G5K-org/open-lasertag/readme.md

<div align="center">

# Open Lasertag

**Infrarot-Lasertag zum Selberbauen – ESP32-S3 in der Waffe, passive Sensorweste, Spielserver in Python**







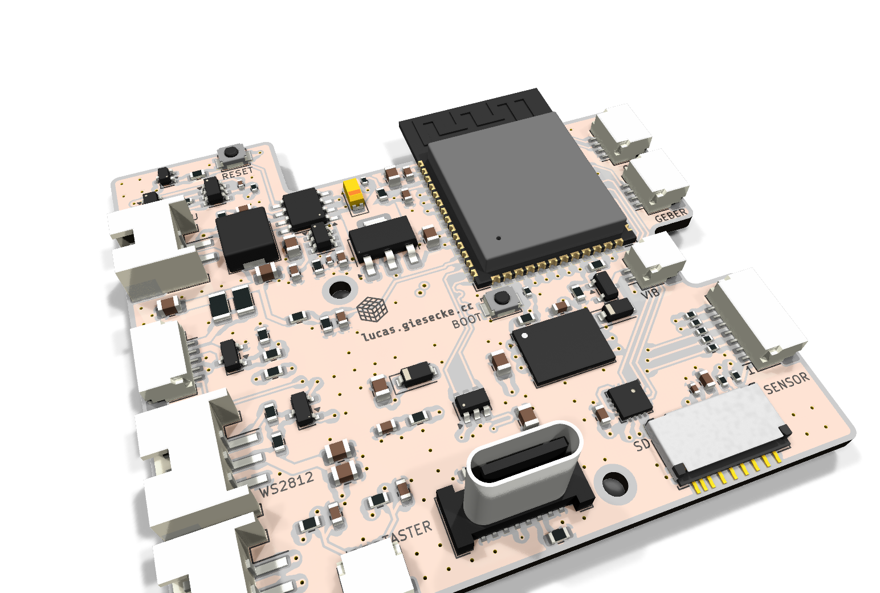
[picture p1: kicad/waffe_elektronik/renders/platine_3d.png]
3D-Ansicht der Waffen-Platine


</div>

## Was ist das?

Ein komplettes Lasertag-System im Eigenbau für Spiele in einer großen Halle:

- **Waffe:** ein 3D-gedrucktes MP5-Gehäuse mit einer eigenen Platine. Darauf
  sitzt ein ESP32-S3, der alles steuert: IR-Schuss, Trefferauswertung,
  Lebens- und Munitionsanzeige, Mündungsfeuer, Vibration, Sound, Akku und WLAN.
- **Weste:** nur passive IR-Empfänger (TSOP34838) an Stirnband, Brust, Rücken
  und Schultern, per Kabel an der Waffe. Die Weste hat keine eigene Elektronik.
- **Server:** ein Python-Programm mit Live-Anzeige im Browser. Es zählt
  Punkte, führt Runden und gibt den Respawn frei.
- **Gateway (optional):** ein kleiner ESP32 am Server-PC. Über ihn erreichen
  die Waffen den Server per ESP-NOW, wenn das WLAN ausfällt.

Geschossen wird mit einer 940-nm-IR-LED hinter einer Linse, nicht mit einem
echten Laser. Die Spiellogik läuft lokal in der Waffe, damit Treffer sofort
Licht, Ton und Vibration auslösen. Das Netz meldet nur nach.

## Inhalt

- [Funktionen](#funktionen)
- [Systemüberblick](#systemüberblick)
- [Hardware](#hardware)
- [Gehäuse](#gehäuse)
- [Firmware](#firmware)
- [Server und Live-Anzeige](#server-und-live-anzeige)
- [Schnellstart](#schnellstart)
- [Projektstruktur](#projektstruktur)
- [Stand](#stand)
- [Planung im Detail](#planung-im-detail)
  1. [Grundentscheidungen](#1-grundentscheidungen)
  2. [Architektur](#2-architektur)
  3. [Sensorkabel zwischen Weste und Waffe](#3-sensorkabel-zwischen-weste-und-waffe)
  4. [IR-Protokoll und Trefferlogik](#4-ir-protokoll-und-trefferlogik)
  5. [Netzwerk](#5-netzwerk)
  6. [Anzeige und Feedback](#6-anzeige-und-feedback)
  7. [Risiken und Gegenmaßnahmen](#7-risiken-und-gegenmaßnahmen)
  8. [ESP32-Wahl](#8-esp32-wahl)
  9. [Vorgehen](#9-vorgehen)
  10. [Offene Punkte](#10-offene-punkte)

## Funktionen

| | |
|---|---|
| 🔫 **Schuss** | NEC-codiertes IR-Signal (Team + Spieler-ID), 38 kHz, jeder Schuss 2× gesendet; Ziel 30–50 m Reichweite |
| 🎯 **Treffer** | bis zu 6 Sensoren; Treffer zählt erst bei 2 gültigen Frames in 100 ms, danach 500 ms unverwundbar; Kopftreffer geben Bonuspunkte |
| 💡 **Anzeige** | WS2812-Kette an der Waffe: Lebensbalken grün → gelb → rot, Munition, Teamfarbe, Ringlicht als Mündungsfeuer; Anschlüsse für OLED (I²C) und Drehdrück-Geber |
| 📳 **Feedback** | Rückstoß- und Treffervibration, Soundeffekte über I²S-Verstärker, weißer Blitz bei Treffer, rotes Pulsieren als tot |
| 🔋 **Akku** | 1S-LiPo/18650 mit Schutzschaltung auf der Platine, Laden über USB-C, Spannungs- und Ladeanzeige; per USB auch ohne Akku lauffähig |
| 📡 **Netz** | WLAN mit eigenem Roaming zwischen Access Points, UDP mit HMAC-Signatur, Treffer werden bis zur Bestätigung wiederholt |
| 🛟 **ESP-NOW** | Fallback zum Server über ein Gateway, wenn das WLAN ausfällt; Trefferbestätigung direkt an die Waffe des Schützen (Ton + grüner Blitz) |
| 🖥️ **Server** | Runden mit Zeitlimit, Teamwertung, Respawn-Freigabe, Live-Anzeige und Bedienung im Browser, Latenzmessung pro Hallenzone |

## Systemüberblick

```mermaid
flowchart LR
    subgraph Weste["Weste (nur Sensoren)"]
        T1["TSOP 1<br>Stirn vorn"]
        T2["TSOP 2<br>Stirn hinten"]
        T3["TSOP 3<br>Brust"]
        T4["TSOP 4<br>Rücken"]
        T5["TSOP 5<br>Schultern"]
    end
    subgraph Waffe["Waffe (ESP32-S3)"]
        RX["IR-Empfang<br>RMT + GPIO"]
        GAME["Spiellogik<br>HP, Munition, Respawn"]
        TX["IR-LED<br>38 kHz"]
        FX["WS2812, Ringlicht,<br>Vibration, Sound"]
        NET["WLAN / UDP"]
    end
    SRV["Server (Python)<br>Punkte, Runden"]
    GW["Gateway<br>ESP32-C3"]
    WEB["Browser<br>Live-Anzeige"]
    W2["andere Waffe"]

    Weste -->|"Sensorkabel<br>GX16, 7 Adern"| RX
    RX --> GAME
    GAME --> TX
    GAME --> FX
    GAME <--> NET
    NET <-->|"WLAN: UDP + HMAC"| SRV
    NET <-.->|"Fallback: ESP-NOW"| GW
    GW <-->|USB| SRV
    NET -.->|"ESP-NOW: Treffer bestätigt"| W2
    SRV <-->|WebSocket| WEB
    TX -.->|IR-Schuss| G(("Gegner"))
```

## Hardware

Eine Platine für die ganze Waffe: 59,6 × 55 mm, 4 Lagen, nur SMD-Bauteile, von
Hand geroutet und für die Bestückung bei JLCPCB vorbereitet. Alle Peripherie
hängt an Steckern: Akku, IR-LED, Taster, Motoren, Lautsprecher, WS2812, ein Sensor an der Waffe und
das Sensorkabel der Weste. Ein- und ausgeschaltet wird mit dem Taster des Drehgebers (kurz drücken = ein,
2 s = aus; ausgeschaltet fließen ca. 55 µA). Geladen wird über USB-C mit 2 A.

| Oberseite | Unterseite |
|---|---|
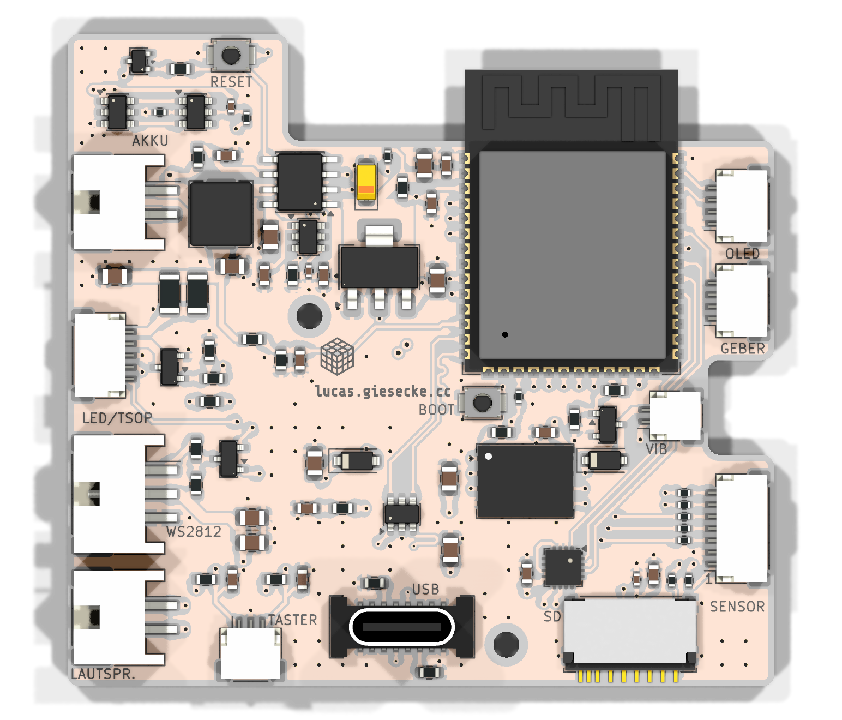
[picture p2: kicad/waffe_elektronik/renders/platine_oben.png]
Platine Oberseite
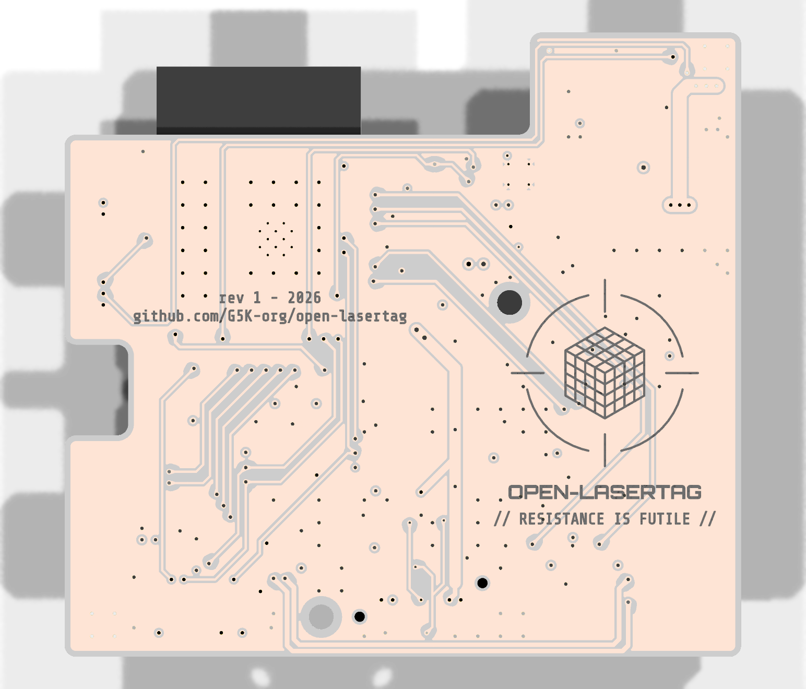
[picture p3: kicad/waffe_elektronik/renders/platine_unten.png]
Platine Unterseite
|  |  |

**Auf der Platine:** ESP32-S3-WROOM-1 (16 MB Flash, 8 MB PSRAM; optional WROOM-1U mit externer Antenne), USB-C mit
ESD-Schutz zum Flashen und Laden, Lade- und 5-V-IC IP5306 (2 A Laden), Akkuschutz DW01A + FS8205A,
3,3-V-Regler, MOSFETs für IR-LED und Vibrationsmotor, Pegelwandler für
WS2812, I²S-Verstärker MAX98357A, microSD-Slot für Audio-Dateien (optional SPI-NAND-Flash 128 MB),
GX16-Buchse für das Sensorkabel der Weste (TSOP-Leitungen über 100 Ω).

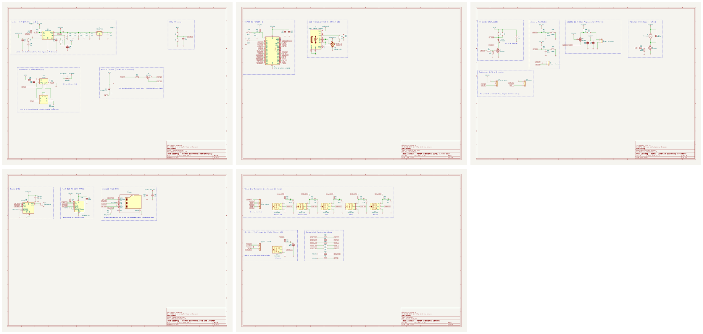
[picture p4: kicad/waffe_elektronik/renders/schaltplan.png]
Schaltplan der Waffen-Elektronik, fünf Seiten


Schaltplan, Layout, Fertigungsdaten und Design-Entscheidungen:
[kicad/waffe_elektronik/](kicad/waffe_elektronik/) · Pinbelegung:
[pinbelegung.md](pinbelegung.md)

## Gehäuse

Als Basis dient das Modell
[MP5 Toygun Cosplay](https://makerworld.com/de/models/427808-mp5-toygun-cosplay)
von **WIZZY** (MakerWorld). Es ist eine rein statische Requisite und wird für
Platine, Akku, Lautsprecher und Optik ausgehöhlt und angepasst. Vorne an der
Mündung sitzt ein WS2812-Ring als Mündungsfeuer.

Die Originaldateien liegen wegen der MakerWorld-Lizenz nicht im Repo; Download und
Ablage beschreibt [gehaeuse/mp5_toygun_stls/](gehaeuse/mp5_toygun_stls/).

Die Platine sitzt im Unterteil zwischen Magazinschacht und Griff; die senkrechte
USB-C-Buchse schließt bündig mit einer Mulde in der linken Seitenwand ab. Im Schalldämpfer sitzen IR-LED und
verstellbare Linse, vorn das Ringlicht; der 18650-Akku steckt im Magazin, das OLED sitzt
angewinkelt vorn oben am Schaft, der Drehgeber unten im Griff, der Abzug löst einen Mikroschalter aus.
Im Handschutz sitzt ein Lautsprecher Ø 40 mit Basskammer, vorn unter dem Korn der TSOP 6. Gehäusehälften
(6 × M3) und die beiden Hälften des vorderen Handschutzes mit Schalldämpfer (5 × M3) sind mit
Einschmelzmuttern verschraubt; die vorderen Hälften umschließen einen Zapfen am hinteren Handschutz
und sind dort mit je 2 × M3 befestigt (ohne Kleber, lösbar). Das Sensorkabel der Weste steckt unten vorn
am Schaft in einer GX16-7-Buchse (Stecker hängt hinter dem Griff leicht schräg nach hinten unten). Links über
dem Griff ist der Sicherungshebel ein beweglicher Nachladehebel (Wippe auf einen verdeckten Taster). Links oben
über dem ESP32-Modul sitzt eine RP-SMA-Buchse für eine externe Knick-Stabantenne (Variante WROOM-1U), die
senkrecht nach oben neben Kimme und Korn steht. Gehäuse, Zwischenring, Handschutz und Schaft sind
mit Stahlstegen und je zwei Zugankern M4 vorn und hinten verspannt, der Zwischenring ist beidseitig
zentriert. Alle Kabelwege sind geprüft:
[gehaeuse/mp5_umbau/](gehaeuse/mp5_umbau/README.md#kabelwege).
Umgebaute und neue Druckteile: [gehaeuse/mp5_umbau/](gehaeuse/mp5_umbau/). Alle Teile samt
Platine zusammengesetzt: [gehaeuse/baugruppe/](gehaeuse/baugruppe/) (GLB/3MF).

| Umgebaute Waffe | Innen (linke Hälfte, Schaft und Magazin ausgeblendet) |
|---|---|
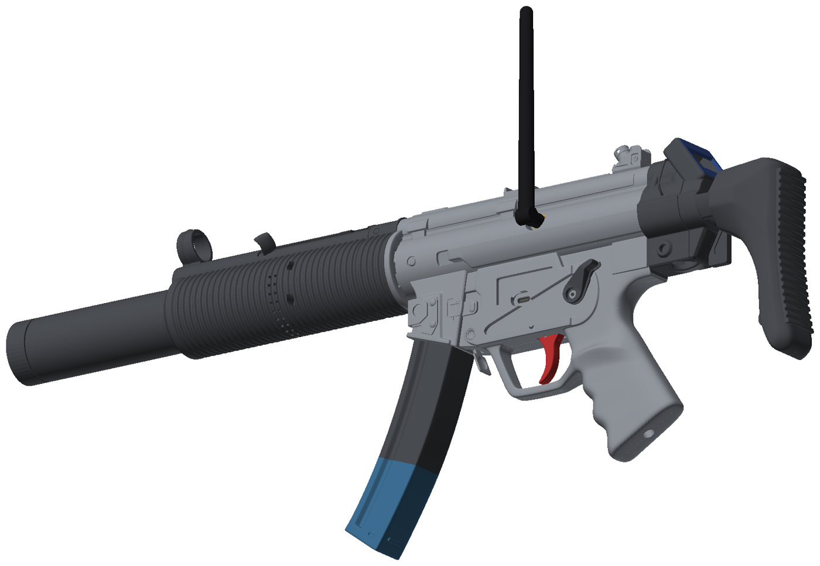
[picture p5: gehaeuse/baugruppe/baugruppe_schraeg.png]
3D-Ansicht der umgebauten Waffe, schräg von vorn
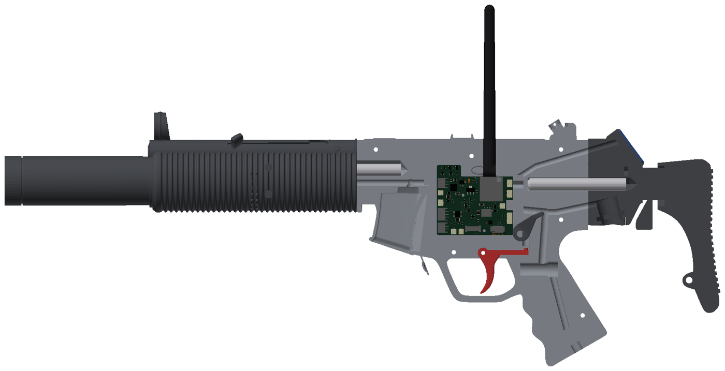
[picture p6: gehaeuse/baugruppe/baugruppe_offen.png]
3D-Schnittansicht: Platine, Abzug, Kabelschächte, Motor, Drehgeber
|  |  |

| Schalldämpfer mit Ringlicht und Linsenhülse | OLED am Schaft |
|---|---|
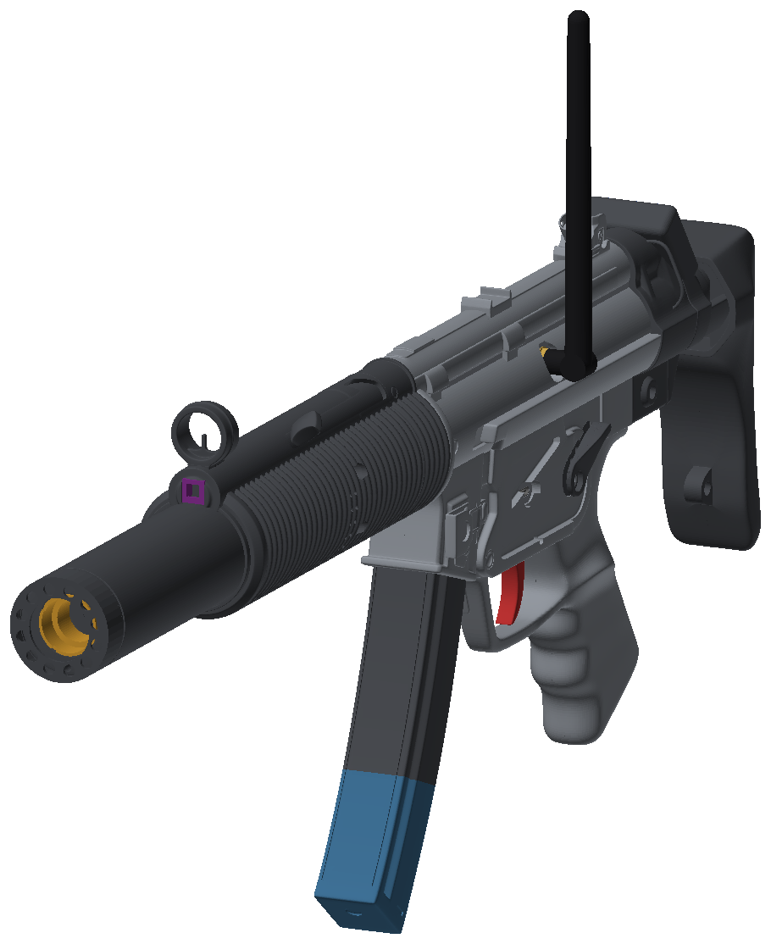
[picture p7: gehaeuse/baugruppe/baugruppe_vorn.png]
3D-Ansicht vorn: Frontkappe mit 12 Fenstern und Linsenhülse
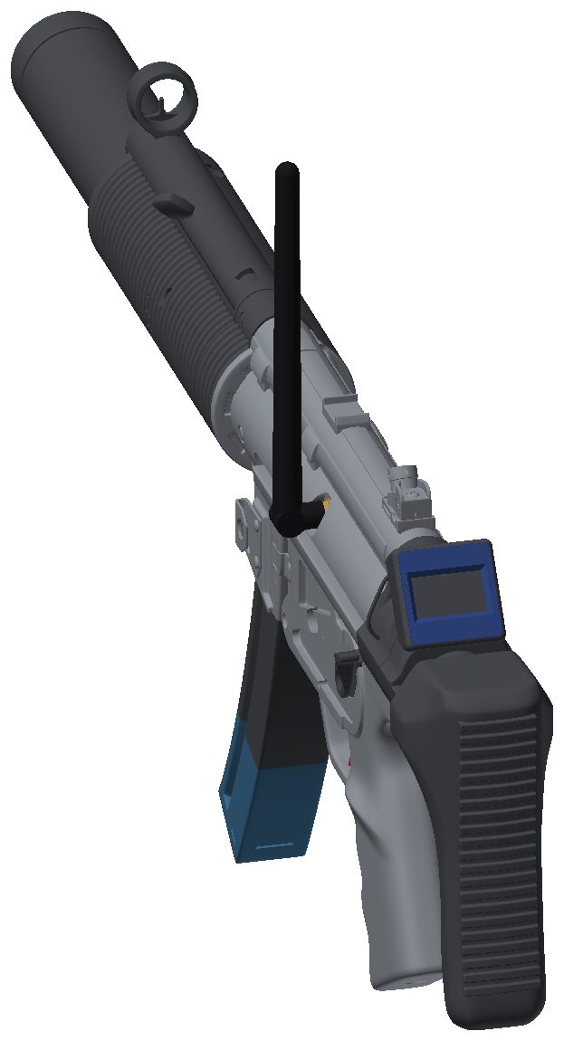
[picture p8: gehaeuse/baugruppe/baugruppe_hinten.png]
3D-Ansicht hinten: OLED-Sockel mit Rahmen am Schaft
|  |  |

**Externe Antenne:** RP-SMA-Buchse in der linken Seitenwand, innen Pigtail als Schlaufe zum U.FL des WROOM-1U.

| Außen | Innen (linke Hälfte und Antenne ausgeblendet) |
|---|---|
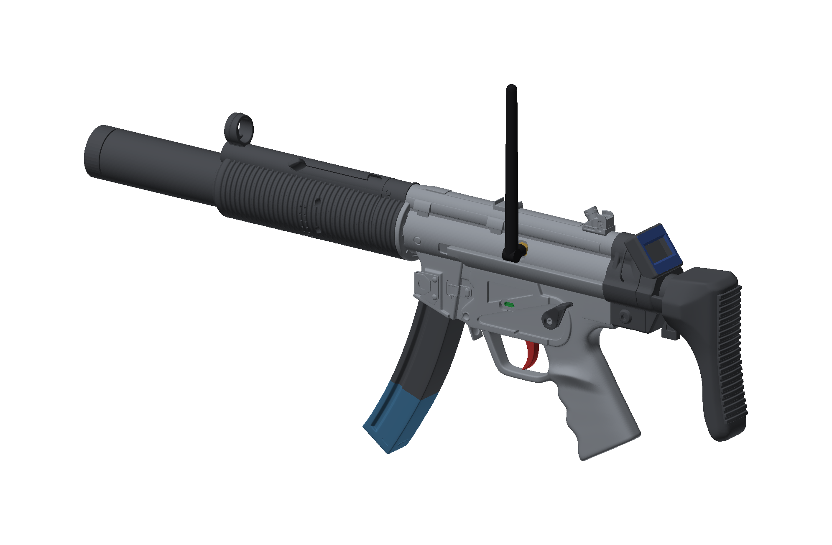
[picture p9: gehaeuse/baugruppe/antenne_aussen.png]
Knick-Stabantenne links oben am Gehäuse, senkrecht nach oben
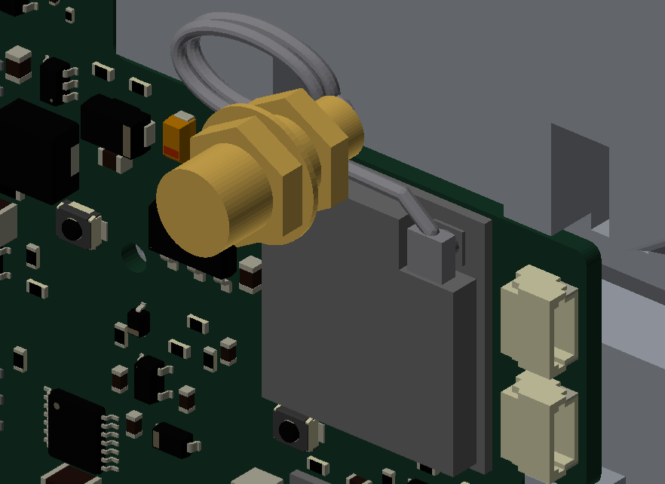
[picture p10: gehaeuse/baugruppe/antenne_innen.png]
RP-SMA-Buchse, Kabelschlaufe und U.FL am ESP32-S3-WROOM-1U
|  |  |

**Explosionszeichnung:** alle Druckteile, die Platine und die Antennenteile, entlang ihrer Montagerichtung auseinandergezogen.

| Von links vorn | Von rechts |
|---|---|
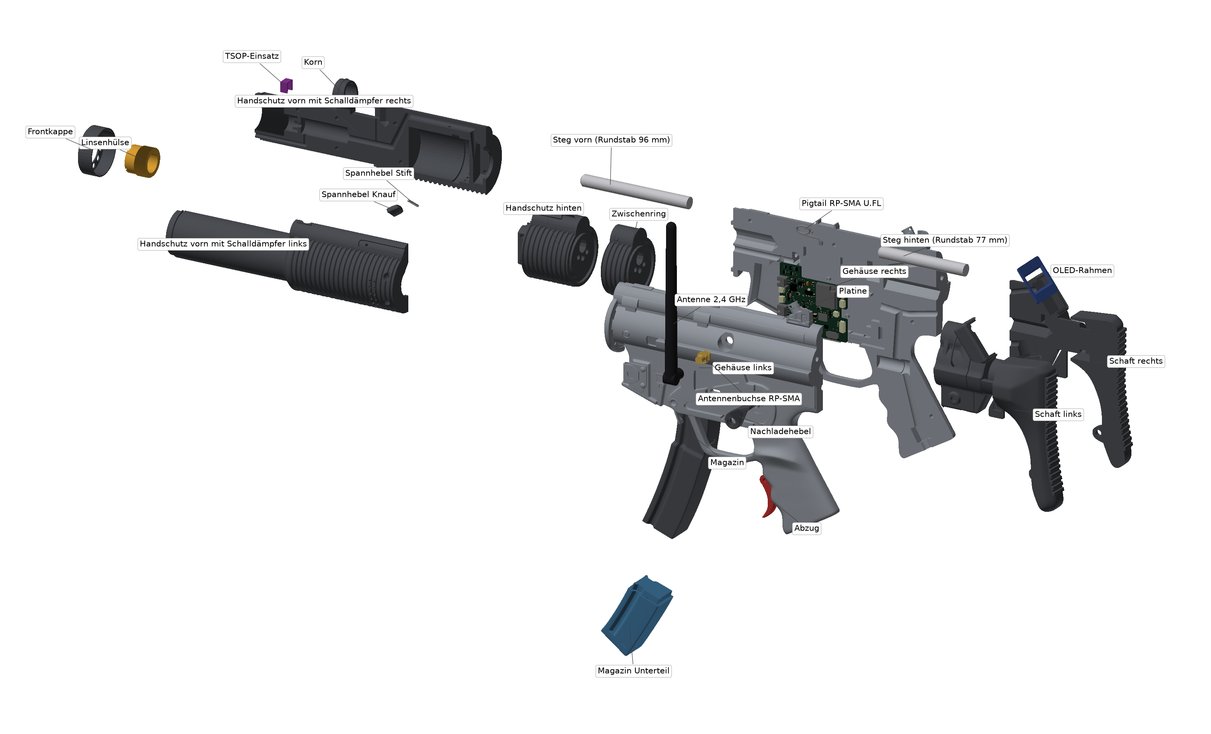
[picture p11: gehaeuse/baugruppe/explosion_links.png]
Explosionszeichnung von links vorn mit Teilenamen
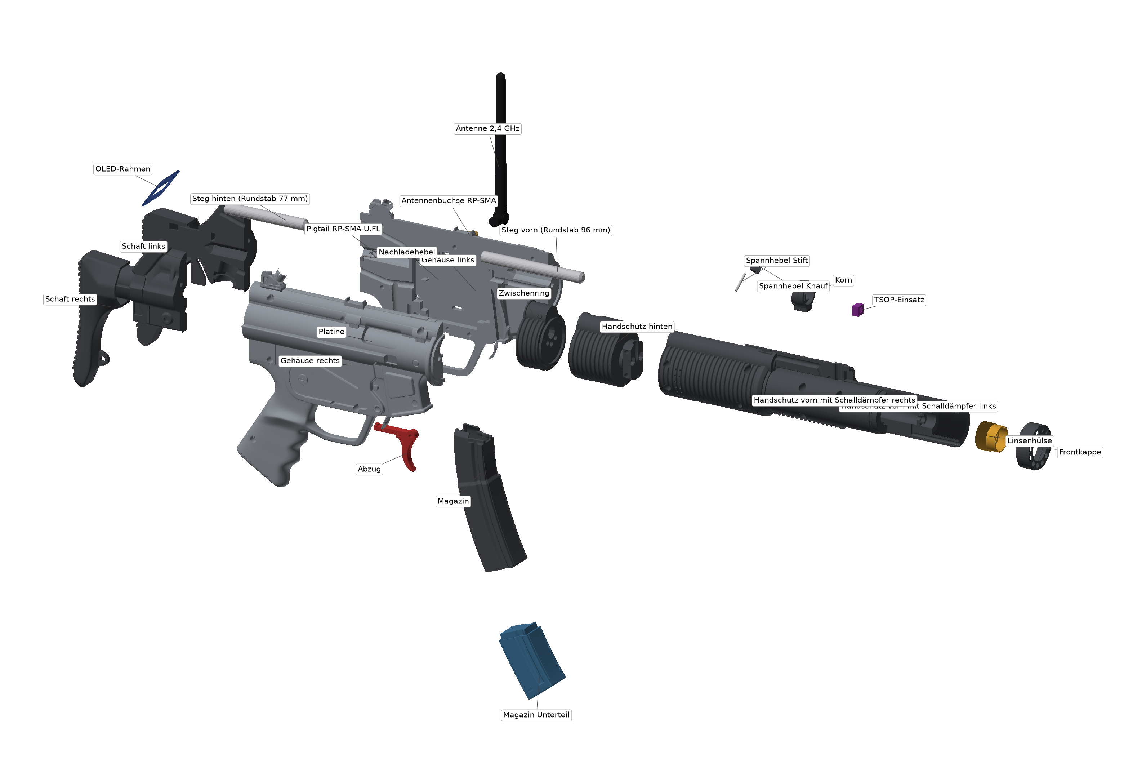
[picture p12: gehaeuse/baugruppe/explosion_rechts.png]
Explosionszeichnung von rechts mit Teilenamen
|  |  |

**Schnitt durch den Schalldämpfer:** Linsenhülse (gold) mit Linse Ø 20 im Innengewinde M24 × 1,5,
von vorn verstellbar; dahinter die IR-LED im Sitz (21 mm hinter der Linse), Kabel nach hinten;
vorn die Frontkappe mit Ringlicht, unten der Kabelkanal für das Ringlicht.

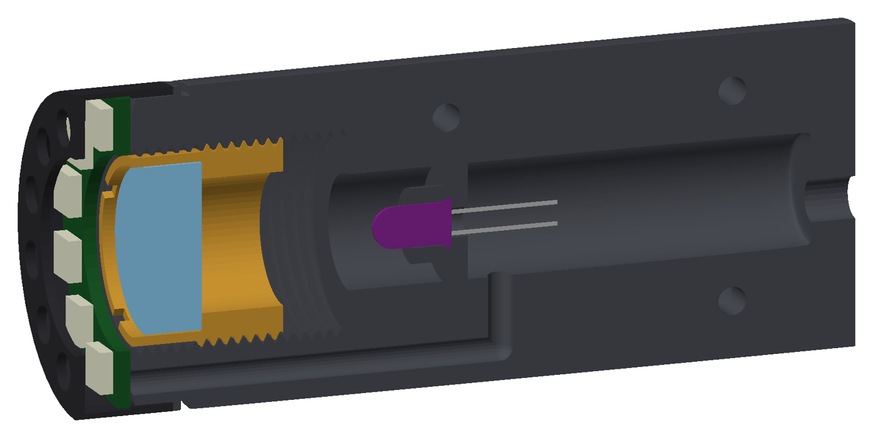
[picture p13: gehaeuse/baugruppe/schnitt_schalldaempfer.png]
Schnitt durch den Schalldämpfer: Linsenhülse mit Gewinde, Linse, IR-LED, Frontkappe mit Ringlicht


**Schnitt durch den Handschutz** (rechte Hälfte): Lautsprecher Ø 40 (rot) strahlt nach hinten in eine
Schallkammer mit Löchern in den Rillen, davor die geschlossene Basskammer (ca. 42 cm³); oben der
Kabelschacht als offene Nut an der Teilungsfläche, darüber das Korn; rechts (blau) der Zapfen des
hinteren Handschutzes, den die vorderen Hälften umschließen.

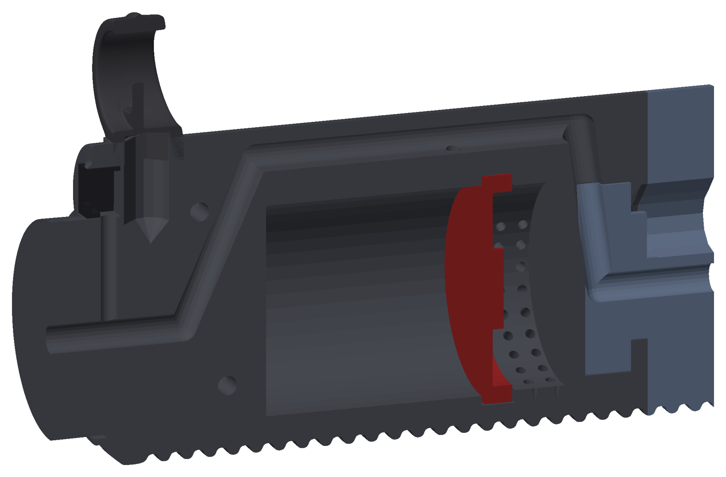
[picture p14: gehaeuse/baugruppe/schnitt_lautsprecher.png]
Schnitt durch den Handschutz: Lautsprecher, Schallkammer mit Löchern, Basskammer, Kabelschacht


**Schnitt durch Gehäuse und Schaft:** GX16-7-Buchse für das Sensorkabel der Weste unten vorn am Schaft
(gold, Mutter in einer Sechskanttasche), Stecker 15° nach hinten unten; der Westenschacht läuft schräg nach
vorn in den Motorschacht und zur Platine (J2).

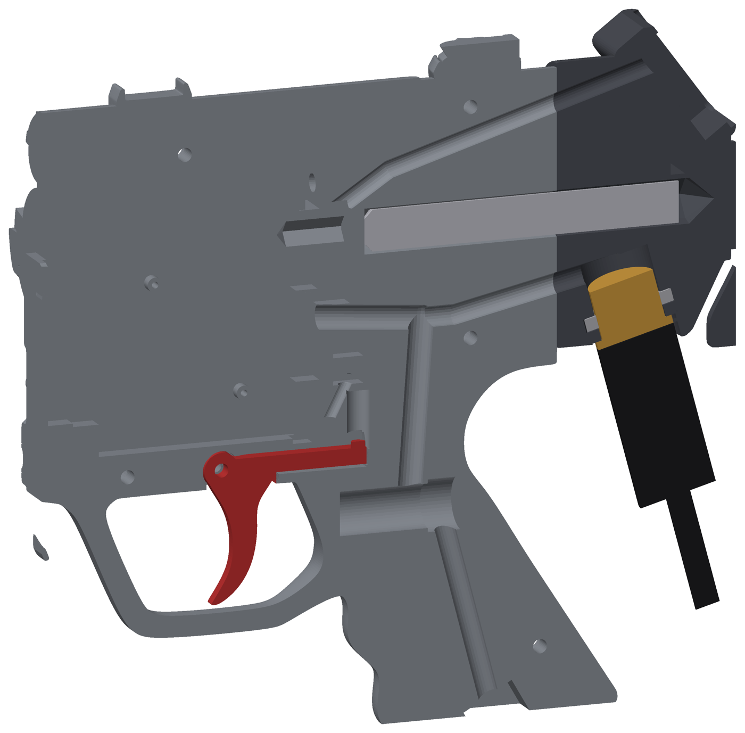
[picture p15: gehaeuse/baugruppe/schnitt_weste.png]
Schnitt: GX16-Buchse im Schaft mit Mutter und Stecker, Kabelschacht zur Platine


## Firmware

ESP-IDF v6.0, nur offizielle Espressif-Komponenten. WLAN und Netz laufen auf
Core 0, IR-Empfang und Spiellogik auf Core 1.

- **IR:** Senden über RMT mit 38-kHz-Träger. TSOP 1–4 laufen über die vier
  RMT-Empfangskanäle, weitere Sensoren über GPIO-Interrupts. Beide Wege gehen
  in denselben NEC-Decoder.
- **Feedback:** WS2812 über `led_strip`, Vibration per PWM, Soundeffekte
  werden synthetisch erzeugt (keine Sound-Dateien). Flash und microSD für
  Audio-Dateien sind auf der Platine vorgesehen, die Firmware nutzt sie noch nicht.
- **Netz:** kein Stromsparmodus, eigenes Roaming unter −75 dBm, Treffer
  werden gepuffert und wiederholt, bis der Server bestätigt.
- **ESP-NOW:** ohne WLAN nach 5 s Fallback über das [Gateway](gateway/);
  getroffene Waffen bestätigen dem Schützen den Treffer direkt.
- **Einstellungen:** Team, Spieler-ID, WLAN, Server und Spielregeln unter
  `idf.py menuconfig`. Team und ID kann auch der Server setzen.

Details: [firmware/](firmware/)

## Server und Live-Anzeige

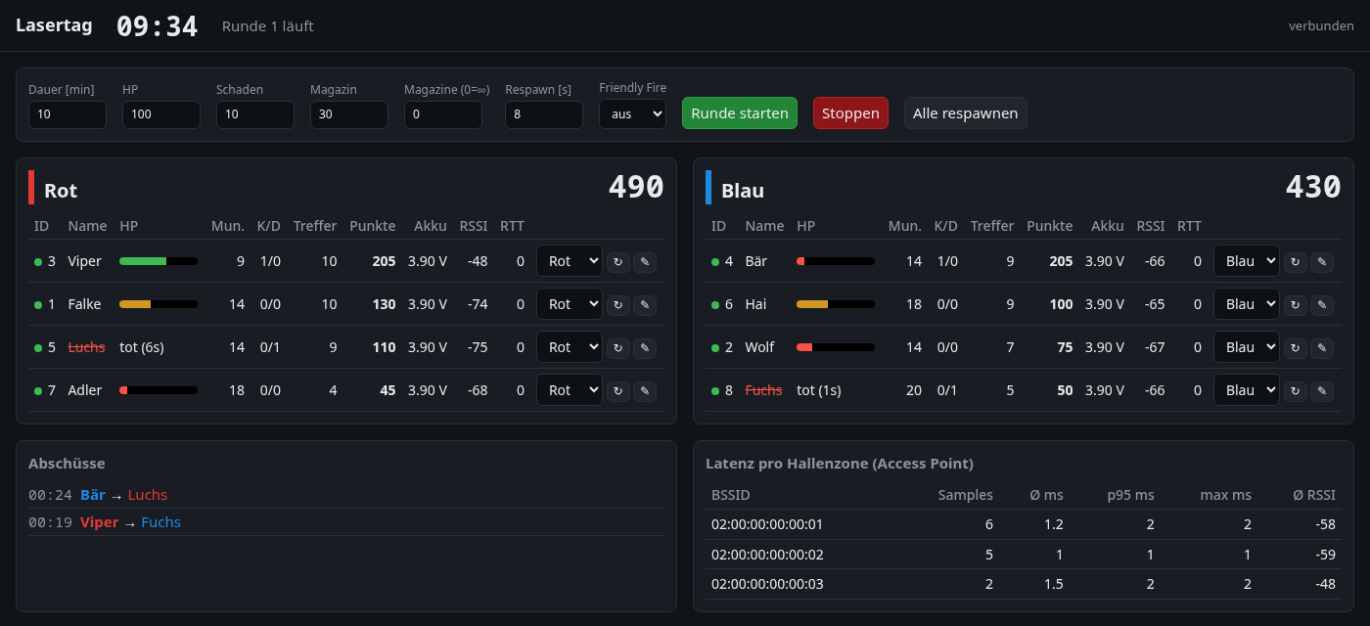
[picture p16: docs/bilder/server_weboberflaeche.png]
Live-Anzeige des Servers während einer Runde


Reines Python (Standardbibliothek, keine Installation). Der Server nimmt die
UDP-Pakete der Waffen an, wertet Treffer und Abschüsse aus, führt Runden mit
Zeitlimit und gibt den Respawn frei. Im Browser gibt es Teamwertung,
Spielerwerte (HP, Munition, K/D, Akku, Signal, Latenz), Abschussliste und die
Latenz pro Access Point. Ein Waffen-Simulator erlaubt Tests ohne Hardware.

Details: [server/](server/) · ESP-NOW-Gateway: [gateway/](gateway/)

## Schnellstart

**Firmware bauen und flashen** (Platine über USB-C anschließen):

```sh
. ~/esp/esp-idf-v6.0.3/export.sh
cd firmware
idf.py menuconfig          # "Lasertag Waffe": WLAN, Server-IP, Team, Spieler
idf.py -p /dev/ttyACM0 flash monitor
```

**Server starten:**

```sh
cd server
cp config.example.json config.json   # Schlüssel wie in der Firmware eintragen
python3 -m lasertag_server --config config.json
# Live-Anzeige: http://<server-ip>:8080/
```

**Ohne Hardware ausprobieren:**

```sh
cd server
python3 -m lasertag_server &
python3 sim_weapon.py --count 6
```

## Projektstruktur

```
├── firmware/              ESP-IDF-Projekt der Waffe
│   ├── main/              Module: IR, Spiellogik, LEDs, Sound, Netz, …
│   ├── test/              Host-Test des NEC-Decoders
│   └── tools/             kleiner UDP-Testserver
├── gateway/               ESP-NOW-Gateway (ESP32-C3) für den Server
├── server/                Spielserver in Python
│   ├── lasertag_server/   UDP, Spiellogik, Web/WebSocket, Oberfläche
│   ├── sim_weapon.py      Waffen-Simulator
│   └── tests/             Unit-Tests
├── kicad/waffe_elektronik/
│   ├── scripts/           Generatoren für Schaltplan (5 Seiten) und Platine, 3D-Modelle
│   ├── symbols/, footprints/, 3dmodels/   Projektbibliotheken
│   ├── renders/           Bilder von Platine und Schaltplan
│   └── fertigung/jlcpcb/  Gerber, BOM, CPL
├── gehaeuse/              MP5-Umbau: Druckteile, Baugruppe, Skripte (Basis-STL per Download)
├── docs/bilder/           Screenshots
├── pinbelegung.md         GPIO-Belegung des ESP32-S3
└── roadmap.md             Phasenplan
```

## Stand

| Teil | Stand |
|---|---|
| Schaltplan und Platine | fertig (Schaltplan auf fünf Seiten), ERC ohne Meldungen, DRC ohne Fehler, Bestellpaket für JLCPCB erstellt |
| Firmware | erste Fassung, auf einem ESP32-S3 geflasht und gestartet; Peripherie noch nicht getestet |
| Server | erste Fassung, mit simulierten Waffen getestet |
| ESP-NOW | Fallback Waffe ↔ Gateway ↔ Server mit zwei ESP32-S3 getestet (beide Richtungen, RTT ~22 ms); Trefferbestätigung Waffe zu Waffe noch ungetestet |
| Gehäuse | Umbau konstruiert (Druckteile, Baugruppe, Kabelwege geprüft), noch nicht gedruckt |
| Weste | Sensoren und Kabel geplant |

Nächste Schritte im [Phasenplan](roadmap.md).

## Lizenz

© 2026 Lucas Giesecke. Firmware, Server, Gateway, Schaltplan, Platine, Gehäuseumbau, Skripte und
Dokumentation stehen unter [CC BY-NC-SA 4.0](LICENSE)
(Namensnennung – nicht kommerziell – Weitergabe unter gleichen Bedingungen):

- **erlaubt:** nutzen, nachbauen, verändern, weiterentwickeln und weitergeben, mit Namensnennung
  und Link auf dieses Projekt; Abwandlungen unter derselben Lizenz
- **nicht erlaubt ohne meine Einwilligung:** kommerzielle Nutzung, z. B. Verkauf von Platinen,
  Bausätzen, Waffen oder Druckteilen, bezahlte Veranstaltungen mit den Geräten, Einbau in
  kommerzielle Produkte. Anfragen bitte als Issue oder direkt an mich

Ausgenommen sind Teile Dritter, für sie gelten ihre eigenen Lizenzen:

| Teil | Quelle | Lizenz |
|---|---|---|
| Gehäusebasis (Originaldateien nicht im Repo, Download siehe `gehaeuse/mp5_toygun_stls/`) und die daraus abgeleiteten Teile in `gehaeuse/mp5_umbau/`, `gehaeuse/baugruppe/` | [MP5 Toygun Cosplay](https://makerworld.com/de/models/427808-mp5-toygun-cosplay) von WIZZY | MakerWorld Standard-Digitaldatei-Lizenz |
| `kicad/waffe_elektronik/fonts/` | Orbitron, Share Tech Mono | SIL Open Font License 1.1 |

---

# Planung im Detail

Stand der Planung: 08.10.2026

## 1. Grundentscheidungen

| Thema | Entscheidung |
|---|---|
| Strahl | IR-LED 940 nm + Linse, kein echter Laser |
| Empfänger | TSOP34838 (Tageslichtfilter) |
| Aufteilung | Ein ESP32-S3 in der Waffe, Weste trägt nur noch passive TSOP-Sensoren |
| Verbindung Weste–Waffe | reines Sensorkabel (3,3 V + GND + je 1 Ader pro TSOP) |
| Netz | WLAN + UDP zu einem Server |
| Spiellogik | lokal in der Waffe (HP, Vibration, LEDs, Sound), Netz meldet nur nach |
| ESP-NOW | Fallback zum Server über ein Gateway und Trefferbestätigung Waffe zu Waffe, WLAN bleibt der Hauptweg |
| Firmware-Framework | ESP-IDF, kein Arduino – nur offizielle Espressif-Komponenten (RMT, I²S, led_strip, esp_wifi) |

---

## 2. Architektur

Übersichtsdiagramm siehe [Systemüberblick](#systemüberblick).

### Waffe (ESP32-S3, zentrale Elektronik – einziger Chip)
- IR-LED (TSAL6100 o. ä.) über N-MOSFET (AO3400 / IRLZ44N), Gate 100 Ω, Pulldown 100 kΩ
- 2 × 22 µF Keramik (C7, C19) als Puffer zwischen Akku und GND
- Abzug und Nachladen (Mikrotaster, RC-Entprellung 10 kΩ + 100 nF)
- Munitionszähler: WS2812-Kette, dazu kleines OLED (I²C) und Drehdrück-Geber, je an eigenem Stecker
- Ein Vibrationsmotor für Rückstoß und Treffer (MOSFET, Freilaufdiode, PWM)
- 4–5× TSOP34838-Signale von der Weste, lokale RMT-Auswertung
- Zusätzlicher TSOP34838 an der Waffe (Stecker J6 zusammen mit der IR-LED, GPIO16, Filter
  100 Ω + 4,7 µF am Sensor, nicht über das Sensorkabel)
- WS2812(B)-Streifen, echte 5-V-Variante (HP/Treffer/Team-Farbe), an der Waffe
  montiert. 5 V für den Strip aus dem IP5306 (Boost vom 1S-LiPo), plus Pegelwandler (z. B.
  ein N-MOSFET in Gateschaltung) zwischen 3,3-V-GPIO und Datenleitung.
- I²S-Verstärker (MAX98357A) + Lautsprecher, nutzt dieselben 5 V wie der
  WS2812-Strip
- SPI-NAND-Flash ZD35Q1GC (128 MB) für Audio-Dateien, optional (Standard: nur microSD), an IO7/IO15/IO3/IO46
- microSD-Slot (Push-Pull, TF-018) am selben SPI-Bus, /CS an IO48; Karte nur bei geöffnetem Gehäuse
  erreichbar
- 1S-LiPo oder 18650, Akkuschutz (DW01A + FS8205A) auf der Platine, Akkuspannung per ADC, im Waffengehäuse
- ESP32-S3-WROOM-1 direkt auf der Platine, eigene USB-C-Buchse am nativen USB
  (IO19/IO20) zum Flashen, Debuggen und Laden – Auto-Flash über den
  eingebauten USB-Serial-JTAG, BOOT- und RESET-Taster als Rückfallebene
- Laden über USB-C mit 2 A: IP5306 (Schaltlader + 5-V-Boost, eigener I²C-Bus, siehe
  [pinbelegung.md](pinbelegung.md)); USB speist über eine Schottky-Diode auch die 5-V-Schiene, damit Flashen
  ohne Akku geht
- WLAN auf Core 0, IR-Auswertung auf Core 1

### Weste (nur Sensoren, keine eigene Elektronik)
- 4–5 TSOP34838: Stirnband vorn/hinten, Brust, Rücken, Schultern
- Je Sensor 100 Ω + 4,7 µF direkt am VCC-Pin, am Sensor selbst
- Kein Chip, keine Platine – nur Sensoren und das Sensorkabel zur Waffe

---

## 3. Sensorkabel zwischen Weste und Waffe

Die Weste hat keinen eigenen Chip – nur TSOP-Sensoren, reine Signalleitungen,
kein Protokoll.

| Ader | Signal |
|---|---|
| 1 | 3,3 V |
| 2 | GND |
| 3 | TSOP 1 – Stirnband vorn |
| 4 | TSOP 2 – Stirnband hinten |
| 5 | TSOP 3 – Brust |
| 6 | TSOP 4 – Rücken |
| 7 | TSOP 5 – Schultern (optional) |

- 7 Adern (bei 5 Sensoren): GX16-7-Aviation-Steckverbinder mit Schraubverriegelung.
  Buchse unten vorn am Schaft, im Gehäuse Litzen zu J2 (JST-SH 7), siehe
  [Weste im Gehäuse](gehaeuse/mp5_umbau/README.md#einbau).
- Je TSOP 100 Ω + 4,7 µF direkt am Sensor, nicht erst an der Waffe; auf der Platine
  liegt jede TSOP-Leitung über 100 Ω in Reihe (Schutz der GPIOs).
- Kabel kurz halten, geschirmt.
- Reine GPIO/RMT-Eingänge, von derselben Firmware ausgewertet, die auch sendet.

---

## 4. IR-Protokoll und Trefferlogik

- NEC-Timing über den offiziellen ESP-IDF RMT-Treiber (`driver/rmt_tx.h` /
  `rmt_rx.h`) encodieren/decodieren; Adresse = Team, Command = Spieler-ID
- Optional später eigenes kürzeres Protokoll (38 kHz, 2 Bit Team, 6 Bit ID,
  Parität)
- Treffer nur zählen bei: Team ungleich eigenem Team (Friendly Fire als
  Schalter), 2 gültige Pakete innerhalb 100 ms, Wiederholcodes ignorieren
- 500 ms Unverwundbarkeit nach Treffer
- Während des Sendens Empfang pausieren, eigene ID ignorieren
- FreeRTOS-Tasks mit `vTaskDelay()`/`esp_timer_get_time()` statt Busy-Loops
- Keine Zonenerkennung (Kopf/Arm/Bein); Kopf-Bonus über Regeln

### Reichweite (IR)
- Linse Ø 25 mm, f ≈ 40–50 mm, LED knapp hinter dem Brennpunkt
- Spitzenstrom 150–300 mA gepulst, Tastgrad 25–33 %
- Eine IR-LED (TSAL6100) mit Vorwiderstand 2 × 22 Ω parallel (11 Ω), Kabel über J6 zusammen mit TSOP 6
- Schuss 2× kurz hintereinander senden
- Ziel: 30–50 m frei

---

## 5. Netzwerk

- Eigene SSID nur 2,4 GHz, eigenes VLAN, Band-Steering aus
- Feste Kanäle (1/6/11), Auto-Optimize während des Spiels aus
- Minimum RSSI ca. -75 dBm, DTIM 1, 802.11r für diese SSID eher aus
- Server und möglichst viele APs per Kabel anbinden
- Waffe: `esp_wifi_set_ps(WIFI_PS_NONE)`, statische IP, keine Scans im Spiel
- UDP-Pakete mit Laufnummer, Treffer 2× senden, bei Aussetzern puffern und
  nachsenden
- Pakete mit Shared-Secret/HMAC absichern
- Eigene Roaming-Logik: RSSI alle 1–2 s prüfen, unter ca. -75 dBm gezielt
  wechseln
- Latenzmessung: Zeitstempel + Echo vom Server, RTT pro Hallenzone loggen
- Erwartung: 3–15 ms, Ausreißer bis 200 ms bei Roaming
- ESP-NOW als Rettungsanker: ohne WLAN Fallback über ein Gateway-ESP32 am
  Server (fester Kanal), dazu Trefferbestätigung direkt an den Schützen. ESP-NOW
  funkt auf dem aktuellen WLAN-Kanal, Waffen hören sich also nur auf gleichem
  Kanal

### Server
- UDP-Listener als eigener asyncio-`DatagramProtocol`, Deduplizierung über
  (Spieler-ID, Laufnummer)
- Teams, Punkte, Runden, Respawn-Freigabe
- Live-Anzeige als Webseite (WebSocket)

---

## 6. Anzeige und Feedback

Komplett an der Waffe montiert (WS2812-Streifen, Vibration, Lautsprecher).

- Lebensanzeige: WS2812-Streifen an der Waffe über das offizielle
  ESP-IDF-`led_strip`-Component, 1 LED = 10 % HP, grün → gelb → rot, unter
  20 % blinken
- Treffer: Vibration 200–300 ms, weißer Blitz 150 ms, Treffer-Ton, Richtung
  über Sensor-Segment
- Tod: rot pulsierend bis Respawn, langes Vibrationsmuster
- Team: Lichtband an der Waffe in Teamfarbe
- Mündungsfeuer: WS2812-Ringlicht vorne an der MP5, als letztes Glied der
  WS2812-Kette über denselben LED-Stecker (kein eigener Pin), kurzer warmer
  Blitz bei jedem Schuss, Helligkeit wegen Stromspitze an der 5-V-Versorgung begrenzt
- Lokale Anzeige zuerst, Netzmeldung danach
- Helligkeit per Skalierungsfaktor in der `led_strip`-Pixel-Berechnung
  begrenzen, Diffusor über den LEDs

---

## 7. Risiken und Gegenmaßnahmen

| Risiko | Maßnahme |
|---|---|
| WLAN stört IR-Empfang | S3 mit Core-Trennung, RC-Filter am TSOP, ggf. RMT-Empfang |
| Reflexionen an Regalen/Folie | 2 gültige Pakete, früh an Gangkreuzungen testen |
| PWM-gedimmte Hallenbeleuchtung stört/blendet TSOP | früh unter realer Beleuchtung testen, ggf. Dimmfrequenz der Lampen prüfen |
| Spannungseinbruch beim IR-Puls | Elko am MOSFET, ausreichend dicke Adern |
| Kabelbruch / Sensorkabel löst sich | Zugentlastung, GX12/GX16-Steckverbinder mit Schraubverriegelung statt loser Stecker |
| TSOP-Signale über längeres Kabel anfälliger für Störungen | kurz halten, geschirmt/verdrillt, RC-Filter direkt am Sensor |
| Team-/HP-Anzeige an der Waffe schlechter sichtbar als am Körper | im Praxistest prüfen, ggf. Sensorkabel später um WS2812-Datenader erweitern |
| Gewicht/Balance der Waffe (Akku, Lautsprecher, LED jetzt alle dort) | früh mit Gesamtgewicht prototypisch testen, ggf. Akku in den Griff/Schaft verlegen |
| WS2812-Datensignal bei 3,3 V unzuverlässig | Pegelwandler (N-MOSFET in Gateschaltung) |
| Augen | IR-LED-Datenblatt und IEC 62471 prüfen, nicht aus der Nähe in die Optik schauen |
| LiPo in der Halle | Schutzschaltung, geschütztes Laden (LiPo-Beutel), nie unbeaufsichtigt |
| Unfallgefahr | nur gehen, Schutzschuhe, Staplerbereiche sperren |
| Organisation | Chef, Versicherung, ggf. Betriebsrat vorher klären |

---

## 8. ESP32-Wahl

| Chip | Status |
|---|---|
| ESP32-S3 | Einziger Chip, in der Waffe |
| ESP32-C3 SuperMini (vorhanden) | nicht mehr im Einsatz – als Ersatzteil aufheben |
| ESP32-C6 | entfällt |
| ESP32 (WROOM) | entfällt |

Befestigung: Platine mit Buchsenleisten und M3-Abstandshaltern oder gedruckte
PETG-Halterung mit Schnappnasen, Antenne frei halten (≥ 10–15 mm Abstand zu
Akku und Metall), USB-Zugang einplanen.

---

## 9. Vorgehen

1. Waffe mit angeschlossenen TSOP-Sensoren auf dem Tisch, nur IR: Reichweite und Fehltreffer messen
2. IR-Stresstest (1000 Schüsse bei laufendem WLAN und LED-Animation, Ziel ≥ 99 %)
3. Sensorkabel Weste → Waffe verlegen und auswerten
4. WLAN/UDP zum Server, RTT pro Hallenzone loggen
5. Spiellogik (Teams, HP, Respawn, Runden) auf dem Server
6. Optik- und Schaltungsoptimierung nach Messwerten
7. Danach weitere Westen, Sound, Extras

---

## 10. Offene Punkte

- Waffe-Code: erste Fassung in [firmware/](firmware/) (ESP-IDF v6.0, auf ESP32-S3 geflasht, Peripherie noch nicht getestet)
- Server: erste Fassung in [server/](server/) (Python, nur Standardbibliothek, mit Waffen-Simulator getestet)
- Gehäuse/3D-Druck-Maße, inkl. Platz für Akku/Lautsprecher/LED in der Waffe –
  als Basis ausgewählt: [MP5 Toygun Cosplay](https://makerworld.com/de/models/427808-mp5-toygun-cosplay)
  (Quellenangabe und Download in [gehaeuse/mp5_toygun_stls/](gehaeuse/mp5_toygun_stls/)),
  Umbau in [gehaeuse/mp5_umbau/](gehaeuse/mp5_umbau/); offen: Nachlade-Taster,
  WS2812-Lebensbalken/Munitionsanzeige
- Akku-/Laufzeitbudget (WLAN + WS2812 + Sound + IR-Pulse) für Eventplanung
- OTA-Update-Mechanismus für die Waffe bei mehreren Sets
- CI-Build für die Firmware
- Server (Python) folgt eigener Umsetzung, ohne externe Basis – ESP-IDF-Vorgabe gilt nur für die Firmware
- Gewichtsverteilung der Waffe mit Gesamt-BOM früh real nachbauen/wiegen
