G5K-org/open-lasertag/gehaeuse/mp5_umbau/README.md

# MP5-Umbau für die Lasertag-Elektronik

Geänderte Druckteile und neue Teile, erzeugt mit [`../scripts/umbau.py`](../scripts/umbau.py).
Geänderte Originalteile liegen in derselben Drucklage wie die Originale, neue Teile druckfertig
(flach bzw. stehend). Zusammengesetzt: [`../baugruppe/`](../baugruppe/).

## Dateien

Vollständiger Drucksatz, jedes Teil mit eindeutigem Namen (gleicher Name als Knoten in der Baugruppe).

| Datei | Teil | aus Original | Änderung |
|---|---|---|---|
| `gehaeuse_links.stl` | Gehäuse links | `obj_1_3` | Platinentasche (Bauteilseite) mit Zonen für die Stecker, USB-C bündig in einer Mulde, RP-SMA-Buchse für die externe Antenne mit Planfläche und Raum für die Kabelschlaufe, Abzugsmechanik, Kabelschächte (auch zur Westenbuchse), Motor, Drehgeber, Tasche und Lagerbund des Nachladehebels (Sicherungshebel-Relief entfernt), Einschmelzmuttern, Zentrierbund vorn, Zuganker mit Mutternischen |
| `gehaeuse_rechts.stl` | Gehäuse rechts | `obj_3_6` | Platinentasche mit Domen, Abzugsmechanik, Kabelschächte (auch zur Westenbuchse), Motor, Drehgeber, Schraubensenkungen, Zentrierbund vorn, Zuganker mit Mutternischen |
| `zwischenring.stl` | Zwischenring | `obj_5_5` | Kabelschacht, Nut hinten, Zentrierbund vorn, 2 Bohrungen für die Zuganker (Nut unten drucken) |
| `handschutz_hinten.stl` | Handschutz hinten | `obj_10_2` | einteilig, ab Y = −32; vorn Zapfen mit 4 Einschmelzmuttern und 2 gefangenen Muttern M4 (Zuganker), Nut hinten, Kabelschacht (Rückseite unten drucken, Stützen unter dem Zapfenkopf) |
| `handschutz_vorn_links.stl` | Handschutz vorn mit Schalldämpfer links | `obj_10_2` | links/rechts geteilt (flach auf der Teilungsfläche), Einschmelzmuttern; Aufnahme für den Zapfen, Lautsprechertasche, Schallkammer mit Löchern, Basskammer, Kabelnut, TSOP-Aufnahme, Gewinde M24 × 1,5, LED-Sitz, Kabelkanäle, Zapfen für die Frontkappe |
| `handschutz_vorn_rechts.stl` | Handschutz vorn mit Schalldämpfer rechts | `obj_10_2` | Gegenstück, Schraubensenkungen (auch für den Zapfen) |
| `frontkappe.stl` | Frontkappe | neu | 12 Fenster für das Ringlicht (Front unten drucken) |
| `linsenhuelse.stl` | Linsenhülse | neu | Gewinde M24 × 1,5 für die Linse Ø 20 |
| `tsop_einsatz.stl` | TSOP-Einsatz | neu | Halter für den TSOP34838 mit Linsenfenster (Fensterseite oben drucken) |
| `korn.stl` | Korn | `obj_7_1` | unverändert |
| `spannhebel_stift.stl` | Spannhebel Stift | `obj_11_12` | unverändert |
| `spannhebel_knauf.stl` | Spannhebel Knauf | `obj_9_10` | unverändert |
| `schaft_links.stl` | Schaft links | `obj_4_7` | OLED-Sockel, Kabelschacht, Aufnahme der GX16-Buchse (Weste), Zuganker mit gefangener Mutter |
| `schaft_rechts.stl` | Schaft rechts | `obj_2_4` | OLED-Sockel, Kabelschacht, Aufnahme der GX16-Buchse (Weste), Zuganker mit gefangener Mutter |
| `oled_rahmen.stl` | OLED-Rahmen | neu | Fenster 24 × 14 mit Fase (Außenseite oben drucken) |
| `steg_vorn_96mm.stl` | Steg vorn (Rundstab 96 mm) | `obj_8_8` | auf 96 mm gekürzt (endet vor dem Zapfen); nur Lehre/Ersatz, eingebaut wird Stahl |
| `steg_hinten_77mm.stl` | Steg hinten (Rundstab 77 mm) | `obj_8_8` | auf 77 mm gekürzt; nur Lehre/Ersatz, eingebaut wird Stahl |
| `magazin.stl` | Magazin | `obj_6_9` | Akkuhalter (3 Rippen), unteres Drittel abgetrennt, Öffnung oben |
| `magazin_unterteil.stl` | Magazin Unterteil | `obj_6_9` | abnehmbar, Zapfen stützt den Akku |
| `abzug.stl` | Abzug | `obj_1_3`/`obj_3_6` | Abzugsblatt in voller Dicke aus beiden Hälften gelöst (kein fester Rest), Nabe und Hebel (flach drucken) |
| `nachladehebel.stl` | Nachladehebel | `obj_1_3` | Sicherungshebel-Relief als bewegliche Wippe, Lagerbohrung in der Kreismarke, 2 Bohrungen für Stifte Ø 3 (Boden unten drucken) |
| `lage.json` | – | – | Lage der neuen Teile in der Waffe (für `baugruppe.py`) |

`obj_12_11` (Sechskantstift 6 × 17,6 mm) aus dem Originalsatz hat keine erkennbare Aufnahme und ist nicht enthalten.

## Kaufteile

Elektrische Teile außerhalb der Platine mit LCSC-Nummer: [`waffe_lose_teile.csv`](../../kicad/waffe_elektronik/fertigung/lcsc/waffe_lose_teile.csv)
(zusammen mit der Platine bei LCSC bestellbar, nicht Teil der JLCPCB-Bestückung).

| Teil | Typ |
|---|---|
| Stege | Stahl-Rundstab Ø 10 h9 (Silberstahl oder Edelstahl), 96 mm und 77 mm |
| Zuganker vorn | 2 × Gewindestange M4 × 130 (Stahl 8.8 oder A2), 2 Muttern M4 (gefangen im Zapfen), 2 Muttern M4 + 2 Scheiben |
| Zuganker hinten | 2 × Gewindestange M4 × 95, 2 Muttern M4 (gefangen im Schaft), 2 Muttern M4 + 2 Scheiben |
| Achse Abzug | Stahlstift Ø 3 × 25 mm |
| Abzugsfeder | Druckfeder Ø 5 × 15 mm, Draht 0,5–0,6 mm (härter/weicher tauschbar) |
| Abzugsschalter | Omron D2F-01 (LCSC C397278; Stößel unten, Grundfläche oben) |
| Linse | Ø 20 mm, bis 7 mm dick, in die Hülse geklebt |
| IR-LED | 5 mm (z. B. TSAL6100), von vorn in den Sitz gesteckt |
| Ringlicht | 12 × WS2812/SK6812, Ø 36,8/23,3 mm (Adafruit #1643 o. ä.) |
| Akku | 1 × 18650 mit Kabel und JST-PH-2-Stecker |
| OLED | 0,96″ SSD1306 I²C 128 × 64 (Platine 27,3 × 27,8), Kabel direkt angelötet, ohne Stiftleiste |
| Drehgeber | EC11 mit Taster, Welle Ø 6, 20 mm |
| Vibrationsmotor | Ø 10 × 20 mm mit Unwucht |
| Nachladehebel | Taster 6 × 6 × 5 mm THT, runder Stößel: Korean Hroparts K2-1102DP-C4SW-04 (LCSC C110153), 2 × Zylinderstift Ø 3 × 8 (Stahl), Druckfeder Ø 3 × 6 (weich), Linsenkopfschraube M3 × 10 ISO 7380 + Scheibe M3 DIN 125 |
| Platine | M2 × 8 ISO 7380 (2 ×) |
| Gehäusehälften | 6 × M3 × 10 ISO 4762, 6 × Einschmelzmutter M3 × 5,7 (Loch Ø 4,0) |
| Handschutz vorn | 5 × M3 × 10 ISO 4762, 5 × Einschmelzmutter M3 × 5,7 (Loch Ø 4,0) |
| Handschutz vorn ↔ hinten | 4 × M3 × 10 ISO 4762, 4 × Einschmelzmutter M3 × 5,7 (in den Zapfen) |
| Lautsprecher | Ø 40 mm, 4–8 Ω, 2–3 W, bis 6 mm Einbautiefe |
| Sensorkabel Weste | GX16-7 Einbaubuchse (Gewinde M16 × 1, Mutter SW 19, Flansch bis Ø 20) + GX16-7 Kabelstecker; 7 Litzen AWG 28 zu J2 (JST-SH 7) |
| Kabel innen | Litze AWG 28 (Ø ≤ 0,9 mm), Akku AWG 24 (Ø ≤ 1,3 mm); Stecker, Längen und fertige Kabel unter [Kabelwege](#kabelwege) |
| TSOP 6 | TSOP34838 (6 × 6,95 × 5,6 mm) |
| Externe Antenne | Knick-Stabantenne 2,4 GHz RP-SMA, 3,2 dBi, 142 mm (TE/Linx ANT-2.4-CW-HWR-RPS); Pigtail RP-SMA-Einbaubuchse auf U.FL, 100 mm, Kabel 1,13 mm (TE/Linx CSI-RGFB-100-UFFR); nur mit ESP32-S3-WROOM-1U auf der Platine |

## Einbau

- **Verstärkung** (vor Platine und Zusammenschrauben der Hälften):
  1. Stege aus Stahl einsetzen: vorn 96 mm (Gehäuse 34 mm, Zwischenring, Handschutz hinten), hinten 77 mm
     (Anschlag im Gehäuse bis in den Schaft)
  2. Zwischenring mit seiner Nut auf den Zentrierbund der Gehäusefront, Handschutz hinten mit seiner Nut auf
     den Bund des Zwischenrings
  3. Zuganker vorn: Mutter M4 in die Sechskanttasche der Stirnfläche am Zapfenkopf drücken, Gewindestange
     M4 × 130 von vorn durch Handschutz hinten und Zwischenring bis in die Gehäusehälfte eindrehen; in der
     Nische vor der Platinentasche (offen zur Teilung) Scheibe und Mutter aufsetzen und mit Schlüssel SW 7
     anziehen. Je Hälfte ein Anker (Z ±6,6)
  4. Zuganker hinten: Mutter M4 von der Teilungsfläche in den Schlitz im Schaft schieben, Gewindestange
     M4 × 95 durch das Gehäuse in die Mutter drehen, in der Nische hinter der Platinentasche Scheibe und Mutter
     anziehen. Je Hälfte ein Anker (Z ±9)
  5. Gehäuse, Zwischenring, Handschutz hinten und Schaft bilden damit einen vorgespannten Block; danach Platine
     einsetzen und die Hälften mit M3 verschrauben
- **Druck der tragenden Teile** (Gehäusehälften, Zwischenring, Handschutz hinten, Schaft): PETG oder ASA,
  6 Wände, 50 % Gyroid, Zwischenring 100 %. Konzept für weniger Druckzeit mit dünner Schale und
  Gießfüllung (Quarzharz / PU-Schaum), noch nicht erprobt: [GIESSFUELLUNG.md](GIESSFUELLUNG.md)

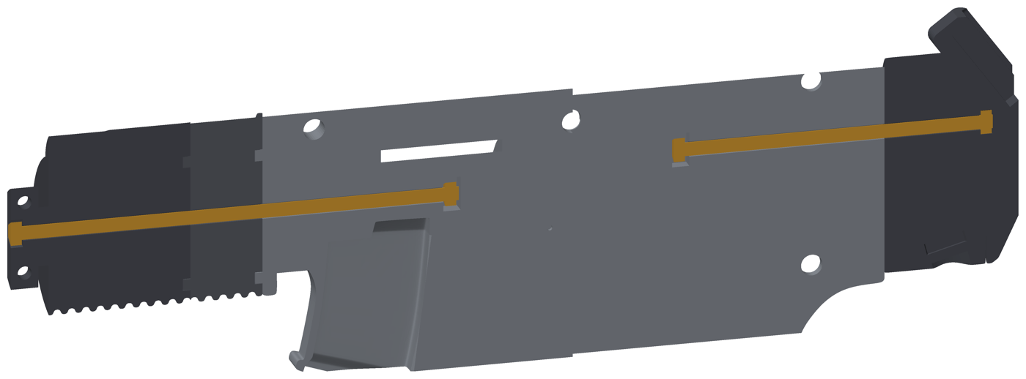
[picture p25: gehaeuse/baugruppe/schnitt_zuganker.png]
Schnitt: Zuganker M4 vorn durch Handschutz hinten, Zwischenring und Gehäuse, hinten durch Gehäuse und Schaft


- **Platine** in der rechten Hälfte, Oberkante X = 76 (4 mm höher als zuvor, Platz für den Abzug)
- **USB-C** (Buchse 10,5 mm hoch) reicht durch die linke Seitenwand (Durchbruch 9,3 × 3,5) und schließt bündig
  mit einer flachen Mulde (14 × 8,5, Boden auf Höhe der Buchsenoberkante) ab

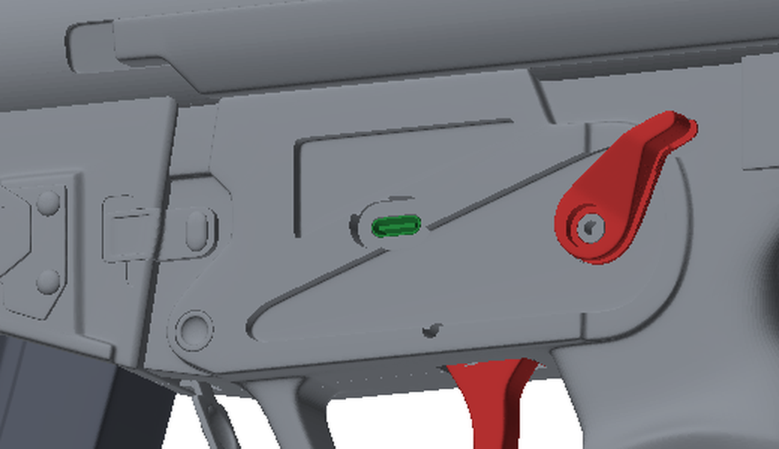
[picture p26: gehaeuse/baugruppe/usb_buendig.png]
USB-C-Buchse bündig in der Mulde der linken Seitenwand


- **Abzug:** Achse X = 136 / Y = 129, Stift durch beide Hälften; Hebel nach hinten unter
  Mikroschalter und Feder; Schalter löst bei ca. 4,5° aus, Anschlag bei 5° (Abzugsweg vorn ca. 3 mm)
- **Schalldämpfer:** Linsenhülse von vorn einschrauben und mit Werkzeug in den Schlitzen verstellen
  (LED-Abstand 13–26 mm, nominal 21 mm); ganz heraus nur bei abgenommener Frontkappe.
  LED von vorn in den Sitz stecken, Kabel nach hinten
- **Ringlicht** von hinten in die Frontkappe legen, Kabel durch den Kanal unten im Schalldämpfer;
  Frontkappe auf den Zapfen stecken
- **Kabelschacht** Ø 5 von der Mündung durch Handschutz, Zwischenring und Gehäuse bis zur Platine;
  Abzweig Ø 6 in den Magazinschacht (Akkukabel)
- **Magazin:** geteilt direkt unter dem Akku (der starre 18650 passt nicht durch den gebogenen
  unteren Teil); Akku von dort gerade einschieben, Unterteil aufstecken. Kabel mit JST-PH-Stecker
  oben heraus; vor dem Einsetzen mit dem Kabel aus dem Schacht verbinden, Stecker in den oberen
  Magazinraum schieben. Der Akku sitzt mit nur ca. 0,5 mm Luft – Zelle ohne dicken Schrumpfschlauch
- **OLED** angewinkelt in der Schrägfläche vorn oben am Schaft: abgerundeter Sockel, Modul von oben
  einkleben (Glas liegt unter der Rahmenstufe), Rahmen in die Stufe setzen; Kabel (Stiftleiste nicht
  bestücken) durch den Schacht im Schaft und Gehäuse zur Platine (OLED). Kimme und Korn bleiben
- **Drehgeber** hinten in der schrägen Griffunterseite, Achse entlang des Griffs, Buchse bündig,
  Welle schaut heraus (Kappe aufstecken)
- **Vibrationsmotor** über dem Griff, Unwucht hinten; Kabel mit dem Drehgeberkabel zur Platine (VIB)
- **Gehäusehälften** verschraubt: Einschmelzmuttern von der Teilungsebene in die linke Hälfte,
  Schrauben M3 × 10 von rechts (Kopf versenkt); vorn oben, Mitte oben, hinten oben, vor dem Abzug,
  hinten über dem Griff, unten im Griff
- **Handschutz vorn mit Schalldämpfer** links/rechts geteilt (Z = 0), beide Hälften flach drucken:
  Einschmelzmuttern in die linke Hälfte, Schrauben M3 × 10 von rechts (Kopf versenkt); 2 Schrauben
  direkt vor der Basskammer, 3 am Schalldämpfer. Lautsprecher, LED, TSOP-Einsatz und Kabel vor dem Verschrauben einlegen
- **Handschutz vorn ↔ hinten:** der hintere Handschutz (einteilig) hat vorn einen Zapfen (Hals Ø 22, Kopf Ø 33
  mit zwei Flächen); die vorderen Hälften umschließen ihn formschlüssig (zieht nicht ab, verdreht nicht).
  4 Einschmelzmuttern seitlich in die Flächen des Kopfs, jede Hälfte mit 2 × M3 × 10 von außen
  (Kopf versenkt) daran schrauben, dann die Hälften miteinander verschrauben. Kein Kleber, alles lösbar
- **Lautsprecher** Ø 40 im vorderen Handschutz: in die Tasche einer Hälfte legen (Membran nach hinten zur
  Schallkammer), Kabel durch die kleine Bohrung in die Kabelnut und abdichten (Basskammer ca. 42 cm³
  bleibt geschlossen). Der Schall geht durch 2 Reihen Löcher Ø 1,8 in den Rillen zwischen den Rippen
- **TSOP 6** vorn an der Rundung unter dem Korn, über dem Schalldämpfer, Linse nach vorn: TSOP von
  hinten in den Einsatz schieben, Kabel an die Beinchen (zeigen nach unten), Einsatz in die Aufnahme
  stecken; Kabel senkrecht nach unten in den Hauptschacht
- **Kabelschächte** laufen als gerade Stücke in beliebiger Richtung (auch diagonal), z. B. vom OLED
  schräg durch das Gehäuse und im Handschutz oben im Rohr um den Lautsprecher herum. Dieses Stück liegt
  als offene Nut an der Teilungsfläche der rechten Hälfte: Kabel einlegen, dann durch die Bohrung im
  Zapfen in den hinteren Handschutz
- **Weste:** GX16-7 Buchse unten vorn am Schaft, 15° schräg nach hinten unten; der Stecker hängt hinter dem
  Griff (ca. 35 mm Abstand zur Griffrückseite, 40 mm vor der Schaftkappe), weg von Schießhand und Wange.
  Mutter vor dem Zusammensetzen der Schafthälften in die Sechskanttasche legen, Buchse später von außen
  eindrehen (Flansch auf der Planfläche). Litzen an die Lötkelche, durch den Schacht schräg nach vorn
  in den Motorschacht (Ø 6, gemeinsam mit Motor und Drehgeber), in die VIB-Zone und flach unter der
  Platine zu J2. Belegung: [Sensorkabel](../../readme.md#3-sensorkabel-zwischen-weste-und-waffe)

Schnitt: GX16-Buchse im Schaft, Mutter, Stecker, Kabelschacht zur Platine

- **Externe Antenne** (Variante mit ESP32-S3-WROOM-1U): RP-SMA-Buchse quer durch die linke Seitenwand oben über
  dem Modul (X = 71,5, Y = 134), Wand an der Buchse 2,5 mm, außen Planfläche Ø 14. Buchse vor dem Einsetzen der
  Platine von innen durchstecken (Sechskant innen an der Wand), außen Scheibe und Mutter SW 8. Kabel in knapp zwei
  Windungen vor der Buchse in der Tasche zur Schlaufe legen, U.FL auf das Modul stecken. Antenne außen aufschrauben
  und senkrecht nach oben klappen; sie steht neben Kimme und Korn

| Außen | Innen (linke Hälfte und Antenne ausgeblendet) |
|---|---|
| Antenne links oben am Gehäuse, senkrecht nach oben geklappt | RP-SMA-Buchse, Kabelschlaufe des Pigtails und U.FL am WROOM-1U |

- **Nachladehebel** (Wippe) links über dem Griff: der Sicherungshebel ist ein eigenes Teil und dreht um die
  Kreismarke (Daumen drückt den Arm ca. 4,5° nach unten)
  1. Taster 6 × 6 liegend in die Tasche unter dem Hebel (Stößel zum Drehpunkt hin), Beinchen nach unten biegen,
     Litzen anlöten und durch den Kanal über der Abzugsfeder in die Tasche des Abzugsschalters führen, von dort
     wie das Abzugskabel zu SW2
  2. Druckfeder Ø 3 × 6 in die Bohrung neben dem Taster legen
  3. Zwei Zylinderstifte Ø 3 × 8 in die Bohrungen im Hebelboden drücken (4,5 mm Überstand)
  4. Hebel mit den Stiften in die Bahnen setzen, Linsenkopfschraube M3 × 10 mit Scheibe in den Lagerbund drehen
     (selbstschneidend); Schraubenkopf liegt versenkt in der Kreismarke. Feder hält den Hebel oben, beim Drücken
     löst der Taster aus, der Taster ist zugleich der Anschlag

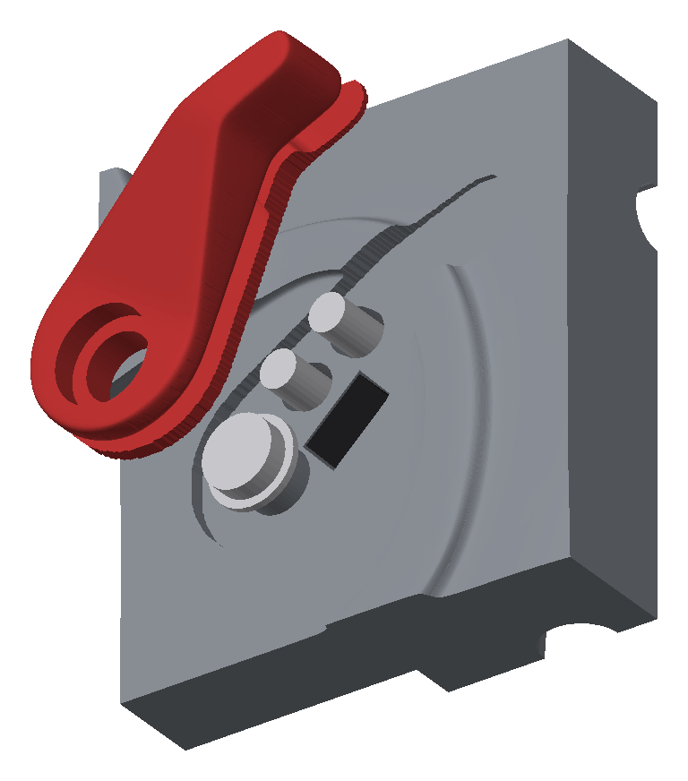
[picture p27: gehaeuse/baugruppe/schnitt_nachladehebel.png]
Nachladehebel abgehoben: Lagerbund mit Schraube, Stifte, Taster und Feder in der Tasche


## Kabelwege

Geprüft mit [`../scripts/kabelwege.py`](../scripts/kabelwege.py): jede Leitung vom Stecker auf der Platine
bis zum Bauteil, das Kabelbündel als Zylinder gegen alle Teile der Baugruppe (Platine eingeschlossen).
Alle Wege sind frei. Jeder Stecker der Platine zeigt in die Zone am Platinenrand, aus der sein Schacht
abgeht: links (vorn) in den Hauptschacht, unten in den Kanal zum Abzugsschalter, rechts (hinten) in den
Motorschacht, rechts oben in OLED- und Motorschacht. Die microSD-Karte (J7) ragt unten rechts ~8,6 mm in
den Kanal zum Abzugsschalter (Tasche dort bis 9,5 mm unter die Platine); die Abzugskabel liegen über ihr.
Die Tasche folgt der Platinenkontur mit der Lasche oben links (Akkuschutz, Ein/Aus); das Westenkabel geht von J2 an der
rechten Kante nach oben in die VIB-Zone und von dort in den Motorschacht.

| Leitung | Stecker | Adern | Weg | Länge ca. | Zuschnitt |
|---|---|---|---|---|---|
| Akku | BT1 (JST-PH 2) | 2 × AWG 24 | linke Zone → Hauptschacht → Abzweig in den Magazinschacht → Kupplung im Magazin | 35 mm + Stecker | 70 mm |
| IR-LED | J6 (JST-SH 5, Pins 1/2, verdrillt) | 2 | linke Zone → Hauptschacht → Zwischenring → Handschutz (um den Lautsprecher) → LED-Sitz | 349 mm | 400 mm |
| TSOP 6 | J6 (JST-SH 5, Pins 3/4/5) | 3 | wie IR-LED bis Y −129, senkrecht hoch in den TSOP-Einsatz | 303 mm | 350 mm |
| Ringlicht | J1 (JST-PH 3) | 3 | linke Zone → Hauptschacht → Bohrung → Kanal unten im Schalldämpfer → Frontkappe | 410 mm | 450 mm |
| Lautsprecher | SP1 (JST-PH 2) | 2 | linke Zone → Hauptschacht → Kabelnut → Bohrung in die Basskammer | 305 mm | 350 mm |
| Abzug | J8 (JST-SH 3, Pins 1/2) | 2 | untere Zone → Schaltertasche | 47 mm | 80 mm |
| Nachladen | J8 (JST-SH 3, Pins 3/2) | 2 | untere Zone → Schaltertasche → Nut an der Teilung → Taster | 66 mm | 100 mm |
| Weste | J2 (JST-SH 7) | 7 | rechte Zone → Motorschacht → Westenschacht → GX16-Buchse | 90 mm | 120 mm |
| OLED | J4 (JST-SH 4) | 4 | Zone rechts oben → OLED-Schacht → OLED im Schaft | 95 mm | 130 mm |
| Drehgeber | J5 (JST-SH 4) | 4 | Zone rechts oben → VIB-Zone → Motorschacht → Motorraum → Drehgeber | 145 mm | 180 mm |
| Vibrationsmotor | M1 (JST-SH 2) | 2 | rechte Zone → Motorschacht → Motor | 80 mm | 110 mm |
| Antenne | U.FL am WROOM-1U | Koax 1,13 | Schlaufe vor der Buchse in der Antennenzone → RP-SMA-Buchse | 100 mm (Pigtail) | – |

„Länge ca.“ ist der Weg ohne Zugabe, „Zuschnitt“ enthält ca. 30 mm Reserve. Zusammen ca. 6,6 m Litze AWG 28 und
0,15 m AWG 24 je Waffe. Zwei Stecker werden aufgeteilt: **J6** läuft mit allen 5 Adern bis Y −129, dort gehen
3 Adern hoch zum TSOP und 2 weiter zur LED. Bei **J8** ist Pin 2 die gemeinsame Masse für Abzug und Nachladetaster.

Füllung der Schächte (Querschnitt der Adern / Schacht, Litze Ø 0,9 mm, Akku Ø 1,3 mm):

| Schacht | Ø | Adern | Ø 0,9 | Ø 1,0 | Ø 1,1 |
|---|---|---|---|---|---|
| Hauptschacht im Gehäuse | 5,0 | 10 × AWG 28 + 2 × AWG 24 | 46 % | 54 % | 62 % |
| Hauptschacht Zwischenring/Handschutz | 5,0 | 10 × AWG 28 | 32 % | 40 % | 48 % |
| Motorschacht | 6,0 | 13 × AWG 28 (Motor, Drehgeber, Weste) | 29 % | 36 % | 44 % |
| Westenschacht | 5,0 | 7 × AWG 28 | 23 % | | |
| OLED-Schacht | 4,5 | 4 × AWG 28 | 16 % | | |

### Stecker und Kabel

| Serie | Raster | auf der Platine | Gegenstück |
|---|---|---|---|
| JST-SH | 1,0 mm | M1 (2), J8 (3), J4 + J5 (4), J6 (5), J2 (7) | SHR-02V-S … SHR-07V-S, Crimpkontakte SSH-003T-P0.2 |
| JST-PH | 2,0 mm | BT1 + SP1 (2), J1 (3) | PHR-2, PHR-3, Crimpkontakte SPH-002T-P0.5S |

JST-XH (2,5 mm) passt auf keinen Stecker der Platine und ist für die Platinentasche zu hoch (THT, ca. 7 mm).
Möglich ist XH nur als Kupplung zwischen Akkukabel und Akku im Magazin.

Am einfachsten sind fertig gecrimpte Kabel mit Stecker an einem Ende („Single Head“), auf Länge gekürzt.
Je Waffe:

| Serie | Pole | Länge | Anzahl | für |
|---|---|---|---|---|
| JST-SH | 2 | 15 cm | 1 | M1 Vibrationsmotor |
| JST-SH | 3 | 15 cm | 1 | J8 Abzug + Nachladen |
| JST-SH | 4 | 15 cm | 1 | J4 OLED |
| JST-SH | 4 | 20 cm | 1 | J5 Drehgeber |
| JST-SH | 5 | 50 cm | 1 | J6 IR-LED + TSOP (ohne Verlängerung) |
| JST-SH | 7 | 15 cm | 1 | J2 Weste → GX16-Buchse |
| JST-PH | 2 | 10 cm | 1 | BT1 Akku → Kupplung im Magazin |
| JST-PH | 2 | 50 cm | 1 | SP1 Lautsprecher |
| JST-PH | 3 | 50 cm | 1 | J1 Ringlicht |

Dazu die Kupplung zum Akku (JST-PH- oder JST-XH-Paar, passend zum Stecker am Akku).

### Verlegen

- **Litze:** Silikonlitze AWG 28 mit Außendurchmesser ≤ 0,9 mm (bei fertig gecrimpten Kabeln auf den Durchmesser
  achten). Mit dickerer PVC-Litze (UL1007, ca. 1,1 mm) wird der Hauptschacht im Gehäuse zu voll (62 %).
- **Einlegen:** Gehäuse, Schaft und vorderer Handschutz sind an der Teilungsebene geteilt, die Schächte liegen dort
  je zur Hälfte in beiden Teilen. Bei offenen Hälften werden die Kabel in die Rinnen gelegt, nicht gezogen.
- **Durchziehen** nur durch Zwischenring und hinteren Handschutz (geschlossen, zusammen ca. 75 mm, 10 Adern):
  alle Adern zusammen, die Spitze mit etwas Klebeband gebündelt. Das muss vor dem Spannen der Zuganker passieren.
- **Lötstellen** (Verlängerungen) nicht in den Hauptschacht im Gehäuse legen, sondern in die Platinentasche direkt
  hinter den Stecker oder vorn in den Handschutz. Versetzt anordnen, mit dünnem Schrumpfschlauch.
- IR-LED-Adern verdrillen. Die Leitung zum Lautsprecher nach dem Löten in der Bohrung zur Basskammer abdichten
  (Heißkleber), sonst leckt die Kammer.
