G5K-org/open-lasertag/gehaeuse/mp5_toygun_stls/README.md

# MP5 Toygun Cosplay – Gehäusebasis

Quelle: [MP5 Toygun Cosplay](https://makerworld.com/de/models/427808-mp5-toygun-cosplay) von Designer **WIZZY** (MakerWorld), veröffentlicht 2024-04-14.
Lizenz: MakerWorld Standard-Digitaldatei-Lizenz (kommerzielle Nutzung erfordert Mitgliedschaft beim Designer).

## Dateien nicht im Repo

Die Originaldateien von WIZZY dürfen hier nicht weitergegeben werden. Für die Skripte in
[`../scripts/`](../scripts/) (z. B. `umbau.py`, `baugruppe.py`) selbst holen:

1. `MP5+Build_stls.zip` von der [MakerWorld-Seite](https://makerworld.com/de/models/427808-mp5-toygun-cosplay) laden
2. in diesen Ordner entpacken, sodass hier `obj_1_3.stl` … `obj_12_11.stl` liegen (12 Dateien)

Git ignoriert die Dateien (`.gitignore`). Die fertigen Druckteile in [`../mp5_umbau/`](../mp5_umbau/)
liegen im Repo und brauchen den Download nicht.

## Wichtiger Hinweis des Designers
Das Modell ist eine **rein statische Deko-Requisite**: kein Schussmechanismus,
keine beweglichen Funktionsteile, nicht als Waffe nutzbar. Für den Tagger
muss das Gehäuse selbst ausgehöhlt/angepasst werden, um ESP32-S3, Akku,
IR-LED, MOSFETs, WS2812, Lautsprecher etc. unterzubringen (siehe
[readme.md, Abschnitt 10 "Offene Punkte"](../../readme.md#10-offene-punkte)).
Nutzer-Reviews weisen zudem auf schwer
entfernbare Supports und knappen Platz hin – beim Druck/Zusammenbau beachten.
