G5K-org/open-lasertag/kicad/waffe_elektronik/README.md

# waffe_elektronik – KiCad-Projekt

Schaltplan und Platine für die zentrale Elektronik der Waffe (einziger
ESP32-S3-Chip), passend zu [../../pinbelegung.md](../../pinbelegung.md) und
[../../readme.md](../../readme.md). KiCad 10, ERC 0 Fehler und 0 Warnungen, DRC 0 Fehler.

Schaltplan, alle Seiten

## Öffnen

`waffe_elektronik.kicad_pro` in KiCad öffnen, dann Schaltplan- bzw.
Platinen-Editor starten. Die Bibliotheken sind über die mitgelieferte projekteigene
`sym-lib-table` eingebunden (nur Standard-KiCad-Bibliotheken, z. B. `Device`,
`Diode`, `Transistor_FET`, `74xx`, `power`).

## Aufbau

Hierarchischer Schaltplan: ein Übersichtsblatt (`waffe_elektronik.kicad_sch`, A4) mit fünf A3-Unterblättern,
jedes in gestrichelt umrahmte Funktionsblöcke gegliedert:

| Seite | Datei | Blöcke |
|---|---|---|
| 2 [Stromversorgung](renders/schaltplan_1_stromversorgung.png) | `stromversorgung.kicad_sch` | Laden + 5 V (IP5306) + LDO, Akku-Messung, Akkuschutz + USB-Versorgung, Akku + Ein/Aus |
| 3 [ESP32-S3 und USB](renders/schaltplan_2_mcu_usb.png) | `mcu_usb.kicad_sch` | ESP32-S3-WROOM-1, USB-C |
| 4 [Bedienung und Aktoren](renders/schaltplan_3_bedienung_aktoren.png) | `bedienung_aktoren.kicad_sch` | IR-Sender, Abzug/Nachladen, WS2812, Vibration, OLED + Drehgeber |
| 5 [Audio und Speicher](renders/schaltplan_4_audio_speicher.png) | `audio_speicher.kicad_sch` | Sound (I²S), Flash, microSD |
| 6 [Sensoren](renders/schaltplan_5_sensoren.png) | `sensoren.kicad_sch` | Weste, TSOP 6, Serienwiderstände im Sensorkabel |

- Innerhalb eines Blocks ist alles mit echten Leitungen verdrahtet; Bauteile
  liegen auf dem Raster, Versorgung zeigt nach oben, Masse nach unten.
- Zwischen den Blöcken und Seiten laufen Signale über globale Labels an kurzen
  Stichleitungen (z. B. `IR_GATE`, `TSOP1_OUT`) statt über lange Leitungen.
- Versorgungsnetze (`GND`, `3V3_MCU`, `5V_PERIPH`, `BAT_P`, `VBUS_NATIVE`)
  hängen an KiCad-Power-Symbolen.
- Unbenutzte Pins sind markiert: freie GPIOs mit No-Connect-Kreuz.
- Bauteile in der Waffe (IR-LED, TSOP 6, Abzugs- und Nachladeschalter) und auf der Weste stehen im Schaltplan
  ohne Footprint jenseits ihres Steckers.

Schaltplan ([kiutils][1]) und Platine (pcbnew) werden per Python erzeugt und
mit `kicad-cli` geprüft; die Generator-Skripte liegen in [`scripts/`](scripts/).
Die Footprints der senkrechten USB-C-Buchse (J3) und des microSD-Slots (J7, Pads nach LCSC/EasyEDA) liegen in der Projektbibliothek
[`footprints/lasertag.pretty`](footprints/lasertag.pretty) (`fp-lib-table`), ihr 3D-Modell
erzeugt `freecadcmd scripts/gen_3d_usb_c_vertical.py`.
3D-Modelle der JST-PH-SMD-Stecker (BT1, SP1, J1) und des WSON-8 8×6 (U14) liegen in [`3dmodels/`](3dmodels/)
(STEP + WRL, erzeugt mit `freecadcmd scripts/gen_3d_jst_ph_sm4.py` bzw. `scripts/gen_3d_wson8_8x6.py`),
das Modell des microSD-Slots (J7) stammt aus der LCSC/EasyEDA-Bibliothek (C961679).

[1]: https://github.com/mvnmgrx/kiutils

## Bauteile

Die Symbole stammen aus den KiCad-Standardbibliotheken; FS8205A, IP5306 sowie Kopien von `W25Q32JVZP`
(/WP, /HOLD passiv) und `MAX98357A` (Pad = Masse) liegen in der Projektbibliothek
[`symbols/lasertag.kicad_sym`](symbols/lasertag.kicad_sym), die `build_clean.py` aus dem erzeugten Schaltplan
schreibt. Verwendet u. a.
`ESP32-S3-WROOM-1` (`U4`), `USB_C_Receptacle_USB2.0_16P` (`J3`),
`USBLC6-2SC6`, `AMS1117-3.3`, `TSOP348xx`,
`MAX98357A`, `AO3400A`, `SS14` (Pinbild für B5819W), `W25Q32JVZP` (Pinbild für U14), `Micro_SD_Card_Det1`,
`DW01A`, `D_Schottky`. Alle Footprints sind
SMD, J3 aus der Projektbibliothek; Bauteile außerhalb der Platine (Akku, IR-LED, TSOP 6, Taster, Motoren,
Lautsprecher, WS2812, Weste) sind über JST-SH/-PH-Stecker angeschlossen.

## Design-Entscheidungen im Schaltplan

- **ESP32-S3-WROOM-1 direkt auf der Platine** (kein DevKit):
  - 3V3 mit 100 nF + 10 µF direkt am Modul
  - EN mit 10 kΩ Pull-up und 1 µF (Power-on-Reset), dazu RESET-Taster
  - BOOT-Taster an IO0
- **USB-C (`J3`) am nativen USB des S3** (IO19/IO20 = USB_D−/USB_D+):
  - senkrechte Buchse hanxia HX-TYPE-C 16P 180 LT H10.5 (LCSC C49261570), 10,5 mm hoch;
    Stecker kommt von der Bestückungsseite, die Buchse reicht in der Waffe durch die linke Seitenwand
    und schließt bündig mit einer flachen Mulde außen ab
  - Flashen und serielle Konsole über den eingebauten USB-Serial-JTAG –
    esptool setzt das Modul automatisch in den Download-Modus, ohne
    USB-UART-Chip
  - Hängt die Firmware oder belegt sie die USB-Pins: BOOT halten und RESET
    drücken, dann lässt sich trotzdem flashen
  - CC1/CC2 je 5,1 kΩ nach GND, damit USB-C-Netzteile VBUS einschalten
  - ESD-Schutz USBLC6-2SC6 in D−/D+ und VBUS
- **Laden und 5 V (`U1`, IP5306-I2C, LCSC C488349):** ein Schaltregler mit einer Spule (`L1` 1 µH,
  MWSA0503S-1R0MT) lädt den Akku aus USB-C (bis 2,1 A, Ladestrom per I²C) und erzeugt aus dem Akku
  `5V_PERIPH`; mit USB kommen die 5 V direkt aus VBUS (Powerpath). VIN 10 µF (`C4`) + Dämpfung 2 Ω/10 µF
  (`R1`/`C29`, an der VBUS-Leitung bei der USB-Buchse), VOUT 22 µF + 10 µF (`C20`, `C30`), BAT-Messeingang über 1 Ω/22 µF (`R2`/`C5`), Akku 22 µF (`C19`).
  Eigener I²C-Bus an IO18 (SCL) / IO9 (SDA), je 4,7 kΩ (`R40`/`R38`) auf 3V3
- **Lastschalter hinter VOUT (`U16`, TPS22810DBV, LCSC C205990):** der IP5306 lässt im Standby eine Restspannung
  (0,8–2,8 V) an VOUT stehen; `U16` trennt `5V_PERIPH` davon ab. EN hängt an IRQ des IP5306 (Pin 4, high solange
  er arbeitet, hochohmig im Standby) mit 100 kΩ nach GND (`R42`); CT 10 nF (`C33`) → ca. 1 ms Anstieg, begrenzt den
  Einschaltstrom in die 5-V-Kondensatoren. Notlösung, falls IRQ sich anders verhält: Pin 1 und 6 von `U16` brücken
- **Ein/Aus:** der Taster des Drehgebers (J5 Pin 2, `PWR_KEY`) geht über `D6` (BAT54CW, Anode 1; Doppel-Schottky mit kleinem Sperrstrom, sonst zieht der Leckstrom in den stromlosen
  IO21 KEY nach unten) und 10 kΩ
  (`R24`) an KEY des IP5306 und über die zweite Anode an IO21. Ein: kurz drücken; aus: 2 s drücken oder per
  I²C (Register siehe [pinbelegung.md](../../pinbelegung.md)); IO21 liest den Taster über die zweite Anode. Ausgeschaltet ziehen Akkuschutz und IP5306
  zusammen ca. 55 µA
- **Power-Tree:** Akku → Akkuschutz → IP5306 (`U1`) → Lastschalter (`U16`) → `5V_PERIPH` (speist WS2812, MAX98357A) →
  AMS1117-3.3 (`U2`) → `3V3_MCU` (ESP32-S3 und Pull-ups); IR-LED und Akku-Messung (1 MΩ/1 MΩ) direkt am Akku
- **Akkuschutz:** DW01A (`U15`, LCSC C351410) + FS8205A (`Q3`, C2830320) im Minuspfad des Akkus
  (`BAT_N` → `GND`): trennt bei ca. 4,3 V, 2,4 V und Überstrom (ca. 3 A); VCC über 100 Ω (`R28`) + 100 nF
  (`C27`), CS über 1 kΩ (`R29`)
- **USB ohne Akku:** Schottky B5819W (`D4`) von `VBUS_NATIVE` auf `5V_PERIPH`
- **IR-LED:** Vorwiderstand 2 × 22 Ω parallel (`R7`, `R8`, 1206, ca. 240 mA Spitze bei vollem Akku), Puffer
  `C7` + `C19` (je 22 µF) am Akku; LED und TSOP 6 teilen sich den Stecker `J6` (1 LED-Anode, 2 LED-Kathode,
  3 GND, 4 3V3, 5 TSOP-Ausgang; LED-Adern im Kabel verdrillt, GND zwischen LED und Sensor)
- **3V3 in die Kabel über 10 Ω:** Weste (`R35`, Netz `3V3_WESTE`) und J6 (`R36`, `3V3_J6`); ein Kurzschluss im Kabel
  oder beim Stecken des GX16 zieht `3V3_MCU` nicht herunter
- **5-V-Puffer:** 22 µF 0805 (Basic): `C20` am IP5306 (dazu `C30` 10 µF 0603, kein Platz für 0805; 22 µF in 0603 gibt es als Basic nur mit 6,3 V), `C1`/`C31` am 5-V-Stamm, `C10`/`C32` am WS2812-Stecker
- **Abzug und Nachladen** über einen gemeinsamen Stecker `J8` (1 Abzug, 2 GND, 3 Nachladen)
- **Sensorkabel:** TSOP 1–5 je über 100 Ω (`R30`–`R34`) an J2
- **TSOPs:** je eigener 100 Ω/4,7 µF-Tiefpass direkt am Sensor (auf der
  Weste).
- **WS2812:** Pegelwandler 3,3→5 V mit einem N-MOSFET in Gateschaltung (`Q4` 2N7002 mit kleiner Ausgangskapazität,
  Gate an 3V3, Source am GPIO, Drain mit 1 kΩ `R25` auf 5 V, nicht invertierend) plus
  330 Ω-Vorwiderstand; die Munitionsanzeige hängt als weitere WS2812-Pixel am
  physischen DOUT-Pin des HP-Streifens (Daisy-Chain), am Ende der Kette sitzt
  das Ringlicht für das Mündungsfeuer vorne an der Waffe.
- **Flash für Audio-Dateien (`U14`, optional, Standard ohne):** SPI-NAND Zetta ZD35Q1GC-IB, 1 Gbit (128 MB), WSON-8 8×6,
  LCSC C2928927 (pin- und gehäusegleich: GD5F1GQ5UE, W25N01GV), ESP-IDF-Komponente `espressif/spi_nand_flash`; SPI2 über die GPIO-Matrix
  (IO7 /CS, IO15 MISO, IO3 MOSI, IO46 CLK), /CS mit 10 kΩ (`R27`) auf 3V3, /WP und /HOLD fest
  auf 3V3, 100 nF (`C25`) an VCC, EP auf GND
- **microSD-Slot (`J7`):** XKB TF-018, Push-Pull, LCSC C961679, im SPI-Modus am Flash-Bus
  (`SPI_CLK`/`SPI_MOSI`/`SPI_MISO`), /CS an IO48; Pull-ups an /CS und DAT0 intern im ESP32, DAT1/DAT2
  gemeinsam über 10 kΩ (`R37`), Kartenerkennung offen, 100 nF (`C26`)
- **PWR_FLAG-Symbole** (`#FLG*`) markieren Netze, die ERC sonst als "nicht
  getrieben" anmahnen würde (5 V, VBUS, Akku).

## Platine

Platine oben

| Oben | Unten |
|---|---|
| oben | unten |

- **59,6 × 55 mm** (Grundfläche 59,6 × 46 mm; oben links eine 18,6 × 9 mm große Lasche für Akkuschutz und Ein/Aus-Diode,
  rechts bei y 18,5–26,5 eine Aussparung für das Motorkabel), 1,6 mm, 4 Lagen, nur SMD, Bestückung nur oben
- **Lagen:**
  - F.Cu: Bauteile, kurze Signale, GND-Fläche
  - In1.Cu: durchgehende GND-Fläche ohne Leiterbahnen
  - In2.Cu: Versorgung (`5V_PERIPH`, `3V3_MCU`, `VBUS_NATIVE` zum IP5306, `BAT_P` zum DW01A) als Leiterbahnen + GND-Fläche
  - B.Cu: lange Signale (Abzug, Nachladen, IR, WS2812, IO0, TSOP, Bedienteil, Ein/Aus, I²C zum IP5306, Flash,
    microSD, VBUS) + GND-Fläche, Projekt-URL
- **ESP32-S3-Modul:** Antenne ragt über die Oberkante hinaus; jedes GND-Pad
  mit eigenem Via nach In1, GND-Stitching-Vias im Raster
- **Befestigung:** 2 × M2-Loch (2,2 mm, nicht durchkontaktiert) für Linsenkopfschrauben
  ISO 7380 (Kopf ≤ 3,5 mm), diagonal: neben dem Spannungsregler und unten zwischen USB-C und
  microSD-Slot; Ø 3,7 mm kupferfrei auf allen Lagen
- **Flash (U14):** unter dem Modul zwischen C1 und Vibrationstreiber; die vier SPI-Leitungen laufen auf
  B.Cu links an BOOT vorbei, /CS und MISO links in U14, MOSI und CLK unter U14 durch zu Vias rechts
  neben Pin 5/6; 3V3 für C25/R27/WP über einen In2-Abzweig der rechten 3V3-Leitung
- **microSD (J7):** unten rechts; Kontakte und Öffnung an der Unterkante (die Karte wird auf der Kontaktseite
  eingesteckt) und ragt ~7,6 mm in die Kabeltasche unter der Platine. Alle Leitungen laufen auf F.Cu unter dem
  Slot nach oben: MOSI, MISO und /CS über Vias bei y 39,2, CLK wechselt über dem Slot auf F.Cu, VDD gerade in
  C26 (100 nF), daneben C28 (10 µF) gegen den Einschaltstrom der Karte, DAT1/DAT2 über In2 unter dem Slot verbunden
- **Antenne:** Standard ist das ESP32-S3-WROOM-1 mit Leiterplattenantenne über der Oberkante. Optional passt
  das ESP32-S3-WROOM-1U-N16R8 (LCSC C3013946) ohne Änderung auf denselben Footprint (gleiche Pads, Modul
  6,3 mm kürzer, endet an der Oberkante); dazu Pigtail U.FL auf RP-SMA-Einbaubuchse (TE/Linx CSI-RGFB-100-UFFR)
  in der linken Seitenwand über dem Modul und Knick-Stabantenne außen (TE/Linx ANT-2.4-CW-HWR-RPS), siehe
  [Gehäuse](../../gehaeuse/mp5_umbau/README.md#einbau). 3D-Modell des 1U für die Baugruppe:
  `scripts/gen_3d_wroom1u.py`. JLCPCB-Dateien dafür:
  `waffe_elektronik_bom_externe_antenne.csv` und `waffe_elektronik_cpl_externe_antenne.csv` (Modulmitte 3,15 mm
  versetzt), Mouser: [`option_externe_antenne_10_waffen.csv`](fertigung/mouser/option_externe_antenne_10_waffen.csv)
- **Bedienung:** J4 OLED (JST-SH 4, Qwiic: GND/3V3/SDA/SCL) und J5 Drehgeber (JST-SH 4:
  GND/Taster/B/A) übereinander im rechten Streifen; I²C-Pull-ups auf dem OLED-Modul
- **Stecker nach Kabelweg in der Waffe:** jede Öffnung zeigt in die Zone am Platinenrand, aus der der
  Kabelschacht des Bauteils abgeht
  - links (vorn, Hauptschacht zum Lauf, Abzweig Magazin): Akku (BT1), IR-LED + TSOP 6 (J6),
    WS2812 (J1), Lautsprecher (SP1)
  - unten (Kanal zur Abzugsschalter-Tasche): Abzug + Nachladen (J8), Entprellung R9/C8 und
    R10/C9 direkt darüber; microSD-Karte (J7) rechts davon, die Abzugskabel liegen über ihr
  - rechts (hinten, Motorschacht): Vibrationsmotor (M1), Sensorkabel Weste (J2)
  - rechts oben: OLED (J4), Drehgeber (J5)
  - USB-C (J3) senkrecht unten rechts der Abzugsstecker, CC1/CC2-Widerstände R23/R22 direkt
    darüber/darunter; RESET-Taster auf dem EN-Weg oben links
- **Regeln (`.kicad_pro`):** min. 0,15 mm Leiterbahn/Abstand, Vias 0,5/0,3 mm
  (USB-Kreuzung 0,4/0,2 mm), Netzklassen Default 0,2 mm, Power 0,5 mm,
  3V3 0,6 mm, USB 0,2/0,2 mm (Paar)
- **Leiterbahnen so kurz wie möglich** auf allen Lagen: lange Wege als ein 45°-Abschnitt
  statt L-Form; parallele Bündel bleiben parallel und kreuzungsfrei
- **USB-Paar gleich lang:** D+ mit Mäander zwischen Modul und USBLC6 und zwischen USBLC6
  und Buchse; an der Buchse D+ über ein Via in der Buchsenmitte (A6–B6-Diagonale), D− über eine
  B.Cu-Brücke A7–B7 mit Abgriff in der Längenmitte; beide Steckrichtungen gleich lang
  (Modul–USBLC6 0,000 mm, USBLC6–Buchse ≤ 0,01 mm, je 2 Vias); VBUS A4/B9 und A9/B4 je über ein
  Via im Reihenspalt, links über B.Cu, rechts über In2 zum USBLC6
- **Beschriftung oben** (F.SilkS), alle Labels waagerecht und einheitlich 0,8 mm hoch,
  direkt am jeweiligen Stecker/Taster, frei von Pads, Vias und Bauteilkörpern; LED/TSOP unter J6, WS2812 neben und LAUTSPR. unter ihrem
  Stecker, TASTER rechts neben J8; Pin 1 von J2
  mit „1“ markiert; Bauteilbezeichner nur auf F.Fab
- **Leiterbahnen nur in 0°/45°/90°**, jeder Knick max. 45°, Abzweige laufen
  unter 45° ein; Teardrops an allen Pads und Vias (außer GND-Stichen in der
  GND-Fläche)
- **Hohe Ströme:** 5 V vom IP5306 über `U16` und zwei Vias in den In2-Stamm (1,2 mm, Abzweig zu WS2812/C10 1,0 mm); Akku-Minus
  BT1 → Akkuschutz 1,2 mm auf B.Cu mit je drei Vias
- **Routing von Hand**, kein Autorouter: IP5306-Schaltknoten gerade und breit zur Spule, Akku → Spule 1,2 mm,
  3V3 von der LDO-Kühlfläche über 10 µF + 100 nF direkt an Modul-Pin 2,
  USB-Paar 45° geführt, D+/D− an der Buchse über eine Via-Kreuzung
- Fertigungsdaten: JLCPCB-4-Lagen-Standardstackup (USB-Impedanz beim
  Fertiger prüfen)

## Fertigung (JLCPCB)

[`fertigung/jlcpcb/`](fertigung/jlcpcb/): `waffe_elektronik_gerber.zip` (Gerber + Bohrdaten),
`waffe_elektronik_bom.csv`, `waffe_elektronik_cpl.csv`. JLCPCB bestückt 73 Teile (Feld `LCSC`, Lagerbestand
geprüft, 11 Extended-Teile); die Stecker (BT1, SP1, J1, J2, J4–J6, J8, M1) und die Taster SW3/SW4
haben statt `LCSC` das Feld `LCSC Hand` und werden selbst gelötet. Mit allen Steckern und Tastern bestückt
(84 Teile, 19 Extended-Teile): `waffe_elektronik_bom_komplett.csv` + `waffe_elektronik_cpl_komplett.csv`, mit
externer Antenne `waffe_elektronik_bom_komplett_externe_antenne.csv` + `waffe_elektronik_cpl_komplett_externe_antenne.csv`.
Der SPI-NAND (U14 mit C25, R27) hat das Feld `LCSC Option` und steckt nur in den Varianten mit `_flash` am Ende
(+3 Teile, +1 Extended-Teil).
Selbst zu lötende Teile und lose Teile in der Waffe:
[`fertigung/lcsc/waffe_lose_teile.csv`](fertigung/lcsc/waffe_lose_teile.csv) (LCSC-Nummern, Menge je Waffe).
Alles für den Selbstbau bei Mouser: [`fertigung/mouser/`](fertigung/mouser/) (10 Waffen, Mouser-Vorlage) plus
[`lcsc_ergaenzung_10_waffen.csv`](fertigung/mouser/lcsc_ergaenzung_10_waffen.csv) für Teile, die Mouser nicht führt.

- Leiterplatte: 4 Lagen, 1,6 mm, Impedanz-Stackup JLC04161H-7628, ENIG, weißer Lötstopplack (Druck schwarz)
- Bestückung: Top Side, BOM + CPL hochladen, Platzierungsvorschau prüfen
- Teile: `U1` IP5306-I2C (ESOP-8, Extended), `D1`/`D4` B5819W (SOD-123, Basic), `D6` LBAT54CWT1G (SOT-323), `Q4` 2N7002 (Basic),
  `U16` TPS22810DBVR (SOT-23-6, Extended),
  22 µF CL21A226MAQNNNE (0805, Basic), `R7`/`R8` 22 Ω 1206 (Basic), `C3` TAJA106K016RNJ (Case A, Basic),
  `L1` 1 µH MWSA0503S-1R0MT

## Bekannte offene Punkte

- RMT-Kanal-Engpass bei 5 TSOPs (siehe
  [pinbelegung.md, Offene Fragen für den Praxistest](../../pinbelegung.md#offene-fragen-für-den-praxistest))
  ist hier nicht abgebildet, da rein softwareseitig
- Kein mechanischer Abgleich mit dem Waffengehäuse – Gehäusebasis siehe
  [../../gehaeuse/mp5_toygun_stls/](../../gehaeuse/mp5_toygun_stls/)
