G5K-org/open-lasertag/kicad/waffe_elektronik/renders/schaltplan_1_stromversorgung.png

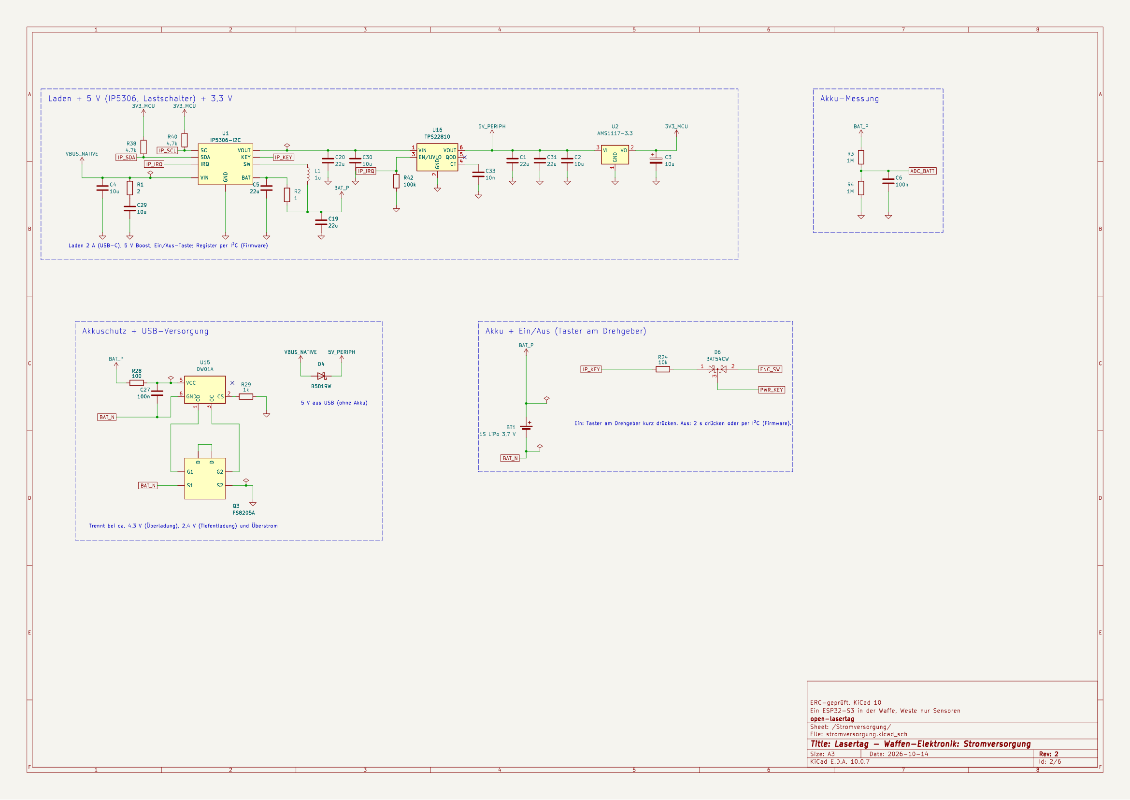
kicad/waffe_elektronik/renders/schaltplan_1_stromversorgung.png
