G5K-org/open-lasertag/kicad/waffe_elektronik/renders/schaltplan_2_mcu_usb.png

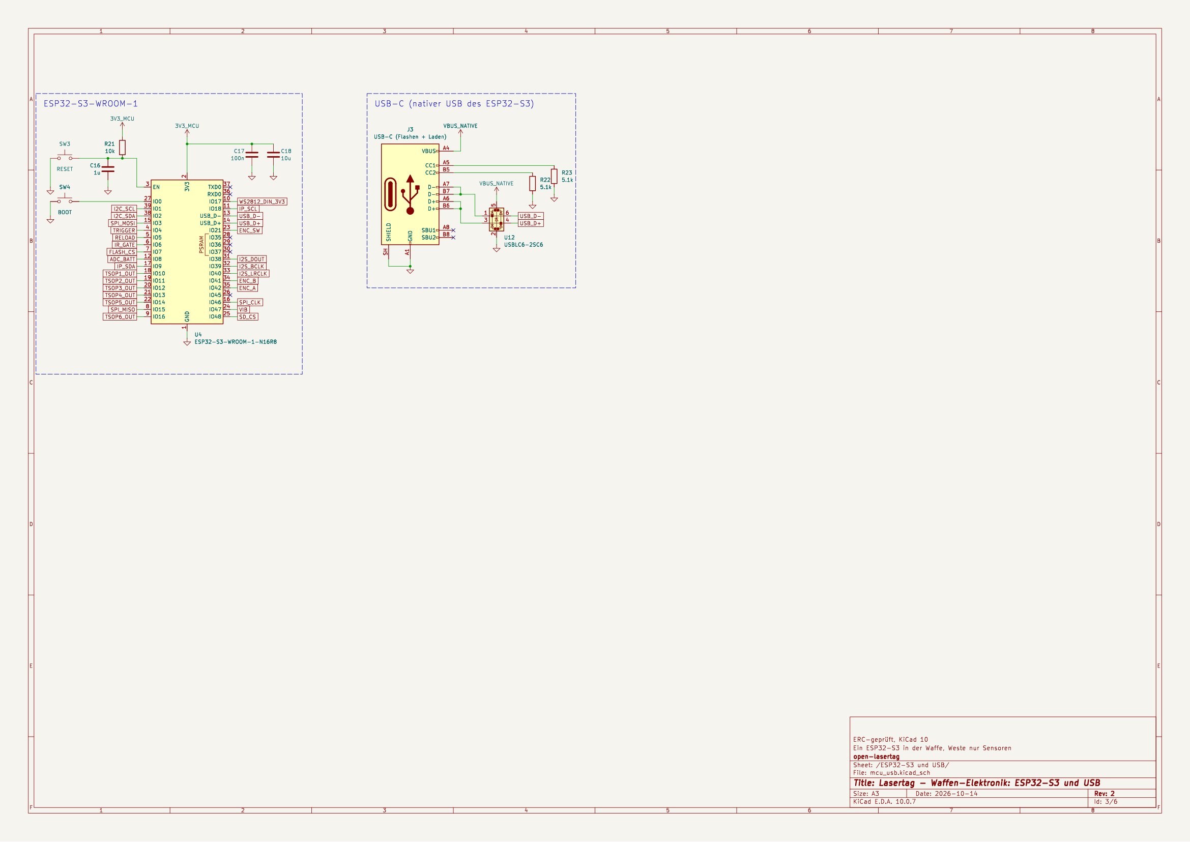
kicad/waffe_elektronik/renders/schaltplan_2_mcu_usb.png
