G5K-org/open-lasertag/kicad/waffe_elektronik/renders/schaltplan_3_bedienung_aktoren.png

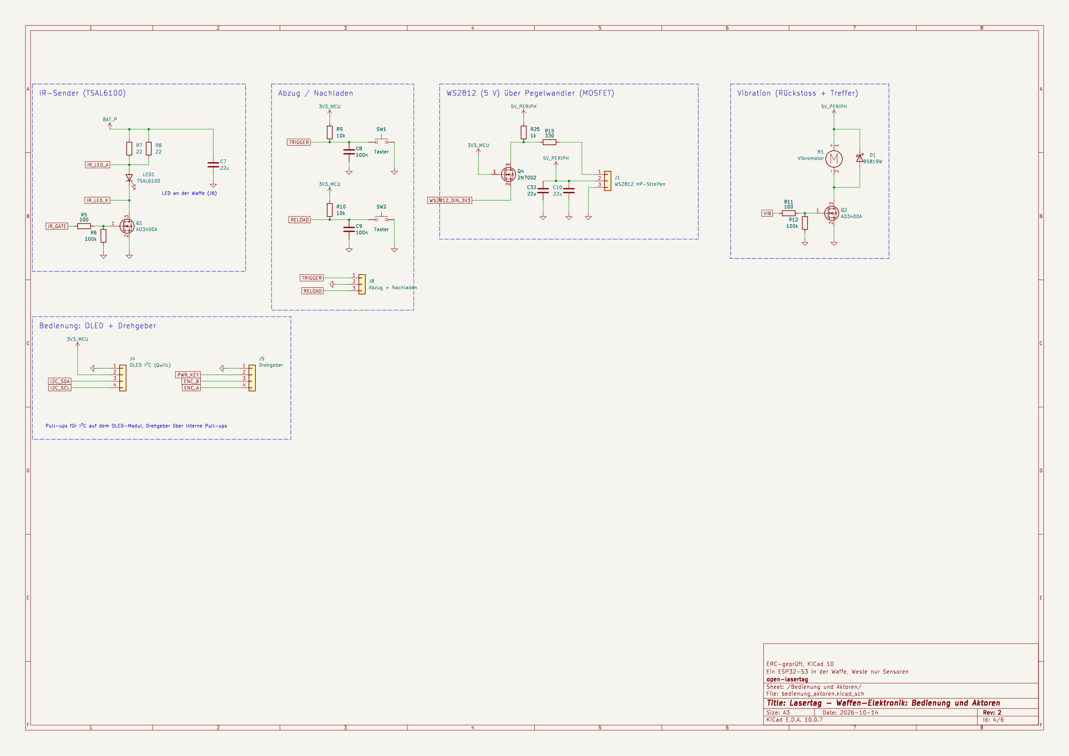
kicad/waffe_elektronik/renders/schaltplan_3_bedienung_aktoren.png
