G5K-org/open-lasertag/kicad/waffe_elektronik/renders/schaltplan_4_audio_speicher.png

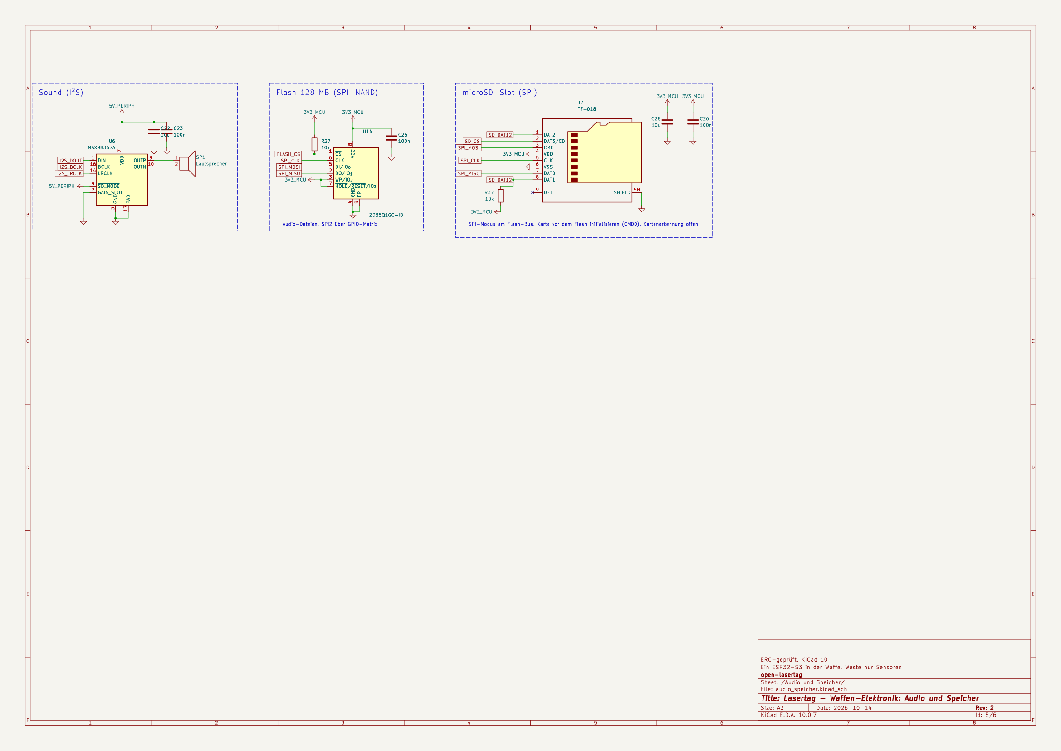
kicad/waffe_elektronik/renders/schaltplan_4_audio_speicher.png
