G5K-org/open-lasertag/kicad/waffe_elektronik/renders/schaltplan_5_sensoren.png

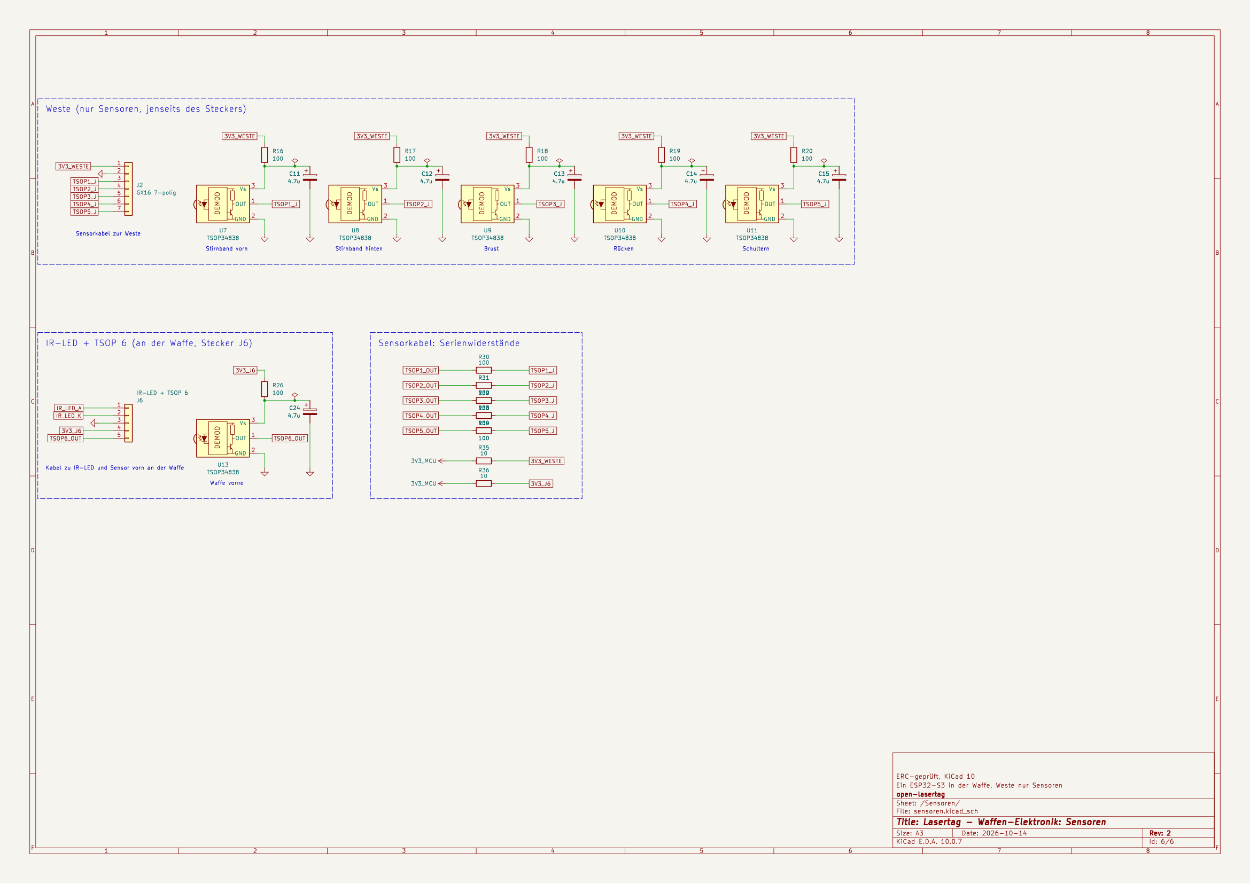
kicad/waffe_elektronik/renders/schaltplan_5_sensoren.png
