G5K-org/open-lasertag/kicad/waffe_elektronik/fertigung/jlcpcb/waffe_elektronik_bom_komplett.csv

Comment | Designator | Footprint | LCSC Part #
1S LiPo 3,7 V / Lautsprecher | BT1,SP1 | JST_PH_S2B-PH-SM4-TB_1x02-1MP_P2.00mm_Horizontal | C225233
22u | C1,C7,C10,C19,C20,C31,C32 | C_0805_2012Metric | C45783
10u | C2,C18,C22 | C_0805_2012Metric | C15850
10u | C3 | CP_EIA-3216-18_Kemet-A | C7171
10u | C4,C28,C29,C30 | C_0603_1608Metric | C19702
22u | C5 | C_0603_1608Metric | C59461
100n | C6,C8,C9,C17,C23 | C_0603_1608Metric | C14663
1u | C16 | C_0603_1608Metric | C15849
100n | C26,C27 | C_0402_1005Metric | C1525
10n | C33 | C_0402_1005Metric | C15195
B5819W | D1,D4 | D_SOD-123 | C8598
BAT54CW | D6 | SOT-323_SC-70 | C57891
WS2812 HP-Streifen | J1 | JST_PH_S3B-PH-SM4-TB_1x03-1MP_P2.00mm_Horizontal | C225234
GX16 7-polig | J2 | JST_SH_SM07B-SRSS-TB_1x07-1MP_P1.00mm_Horizontal | C160406
USB-C (Flashen + Laden) | J3 | USB_C_Receptacle_HX_TYPE-C-16P-180-LT-H10.5_Vertical | C49261570
Drehgeber / OLED I²C (Qwiic) | J4,J5 | JST_SH_SM04B-SRSS-TB_1x04-1MP_P1.00mm_Horizontal | C160404
IR-LED + TSOP 6 | J6 | JST_SH_SM05B-SRSS-TB_1x05-1MP_P1.00mm_Horizontal | C7430447
TF-018 | J7 | microSD_TF-018_PushPull | C961679
Abzug + Nachladen | J8 | JST_SH_SM03B-SRSS-TB_1x03-1MP_P1.00mm_Horizontal | C7430445
1u | L1 | L_Sunlord_MWSA0503S | C408355
Vibromotor | M1 | JST_SH_SM02B-SRSS-TB_1x02-1MP_P1.00mm_Horizontal | C160402
AO3400A | Q1,Q2 | SOT-23 | C20917
FS8205A | Q3 | SOT-23-6 | C2830320
2N7002 | Q4 | SOT-23 | C8545
2 | R1 | R_0603_1608Metric | C22977
1 | R2 | R_0603_1608Metric | C22936
1M | R3,R4 | R_0603_1608Metric | C22935
100 | R5,R11 | R_0603_1608Metric | C22775
100k | R6,R12,R42 | R_0603_1608Metric | C25803
22 | R7,R8 | R_1206_3216Metric | C17958
10k | R9,R10,R21,R24 | R_0603_1608Metric | C25804
330 | R15 | R_0603_1608Metric | C23138
5.1k | R22,R23 | R_0603_1608Metric | C23186
1k | R25 | R_0603_1608Metric | C21190
100 | R28,R30,R31,R32,R33,R34 | R_0402_1005Metric | C25076
1k | R29 | R_0402_1005Metric | C11702
10 | R35 | R_0402_1005Metric | C25077
10 | R36 | R_0603_1608Metric | C22859
10k | R37 | R_0402_1005Metric | C25744
4.7k | R38,R40 | R_0402_1005Metric | C25900
BOOT / RESET | SW3,SW4 | SW_SPST_B3U-1000P | C231329
IP5306-I2C | U1 | HSOP-8-1EP_3.9x4.9mm_P1.27mm_EP2.3x2.3mm_ThermalVias | C488349
AMS1117-3.3 | U2 | SOT-223-3_TabPin2 | C6186
ESP32-S3-WROOM-1-N16R8 | U4 | ESP32-S3-WROOM-1 | C2913202
MAX98357A | U6 | TQFN-16-1EP_3x3mm_P0.5mm_EP1.23x1.23mm | C910544
USBLC6-2SC6 | U12 | SOT-23-6 | C7519
DW01A | U15 | SOT-23-6 | C351410
TPS22810 | U16 | SOT-23-6 | C205990
