G5K-org/open-lasertag/gehaeuse/baugruppe/mp5_baugruppe.3mf

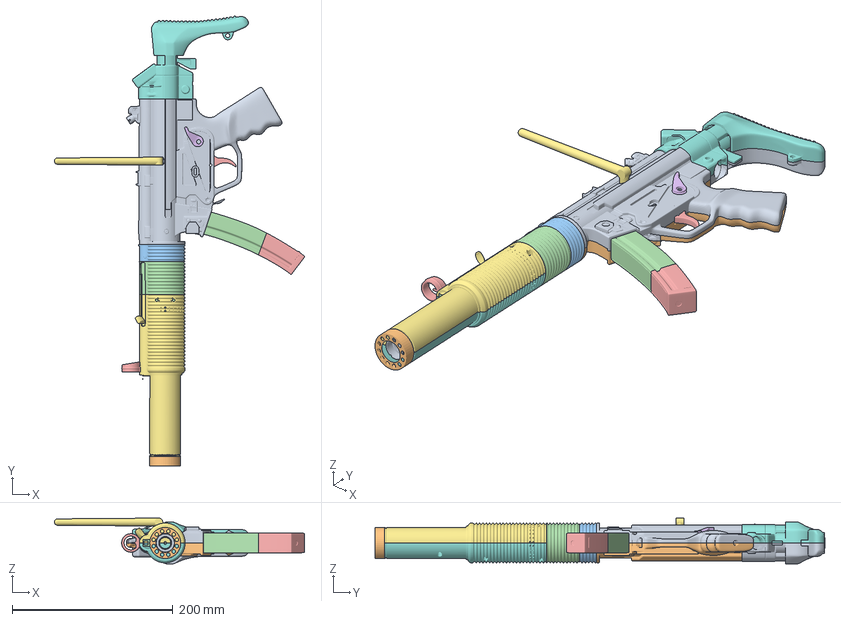
[picture p36: CAD file, 2026-10-15]
gehaeuse/baugruppe/mp5_baugruppe.3mf
311.6 x 560.2 x 57.1 mm
Gehäuse links
Gehäuse rechts
Zwischenring
Handschutz hinten
Korn
Spannhebel Stift
Spannhebel Knauf
Schaft links
Schaft rechts
Steg vorn (Rundstab 96 mm)
Steg hinten (Rundstab 77 mm)
Magazin
Abzug
Nachladehebel
Handschutz vorn mit Schalldämpfer links
Handschutz vorn mit Schalldämpfer rechts
Linsenhülse
Frontkappe
OLED-Rahmen
TSOP-Einsatz
Magazin Unterteil
Antennenbuchse RP-SMA
Antenne 2,4 GHz
Pigtail RP-SMA U.FL
Platine
