G5K-org/open-lasertag/gehaeuse/mp5_umbau/gehaeuse_links.stl

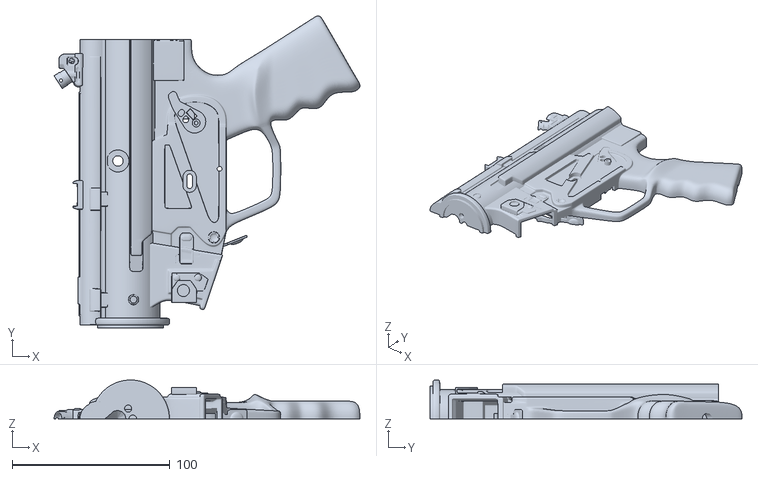
[picture p38: CAD file, 2026-10-15]
gehaeuse/mp5_umbau/gehaeuse_links.stl
194.0 x 198.0 x 24.7
