G5K-org/open-lasertag/kicad/waffe_elektronik/3dmodels/ESP32-S3-WROOM-1U.step

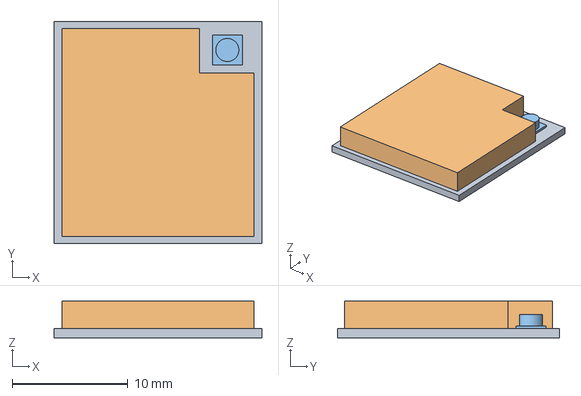
[picture p39: CAD file, 2026-10-14]
kicad/waffe_elektronik/3dmodels/ESP32-S3-WROOM-1U.step
18.0 x 19.2 x 3.20 mm
