G5K-org/open-lasertag/gehaeuse/bambu/mp5_massiv_p2s.3mf

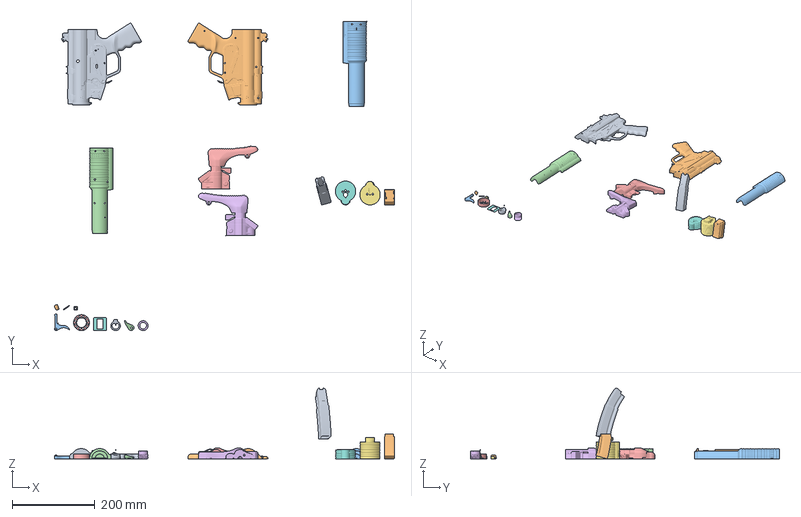
[picture p40: CAD file, 2026-10-18]
gehaeuse/bambu/mp5_massiv_p2s.3mf
823.6 x 749.1 x 171.1 mm
gehaeuse_links
gehaeuse_rechts
handschutz_vorn_links
handschutz_vorn_rechts
schaft_links
schaft_rechts
handschutz_hinten
zwischenring
magazin
magazin_unterteil
abzug
nachladehebel
frontkappe
linsenhuelse
tsop_einsatz
oled_rahmen
korn
spannhebel_knauf
spannhebel_stift
