G5K-org/open-lasertag/gehaeuse/mp5_umbau/gehaeuse_rechts.stl

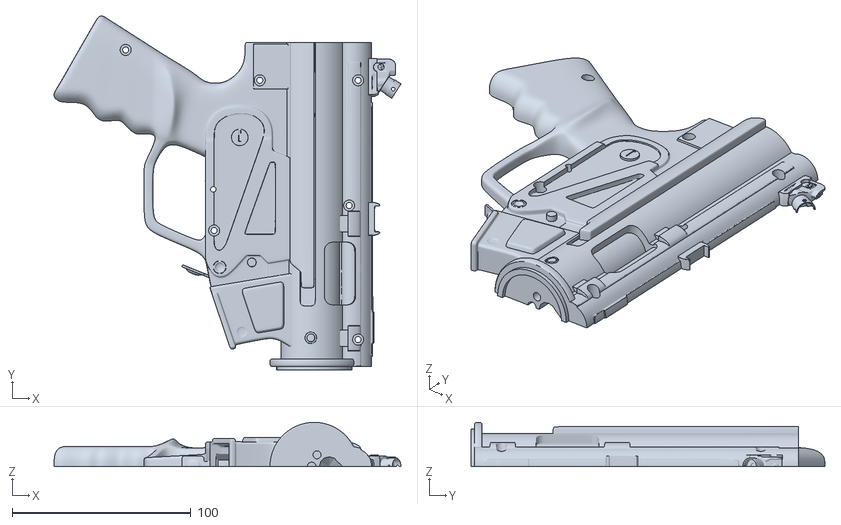
[picture p42: CAD file, 2026-10-15]
gehaeuse/mp5_umbau/gehaeuse_rechts.stl
194.0 x 198.0 x 24.7
