G5K-org/open-lasertag/kicad/waffe_elektronik/3dmodels/microSD_TF-018_PushPull.step

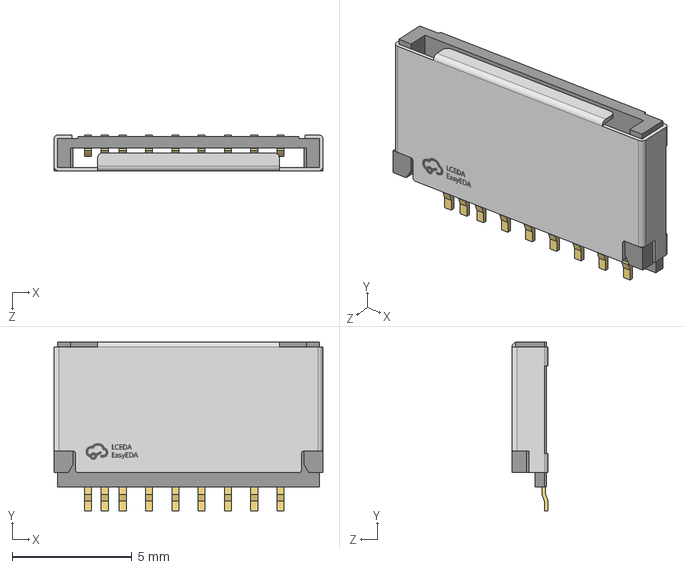
[picture p43: CAD file, 2026-10-14]
kicad/waffe_elektronik/3dmodels/microSD_TF-018_PushPull.step
11.3 x 7.05 x 1.50 mm
