G5K-org/open-lasertag/gehaeuse/mp5_giessfuellung/handschutz_vorn_links.stl

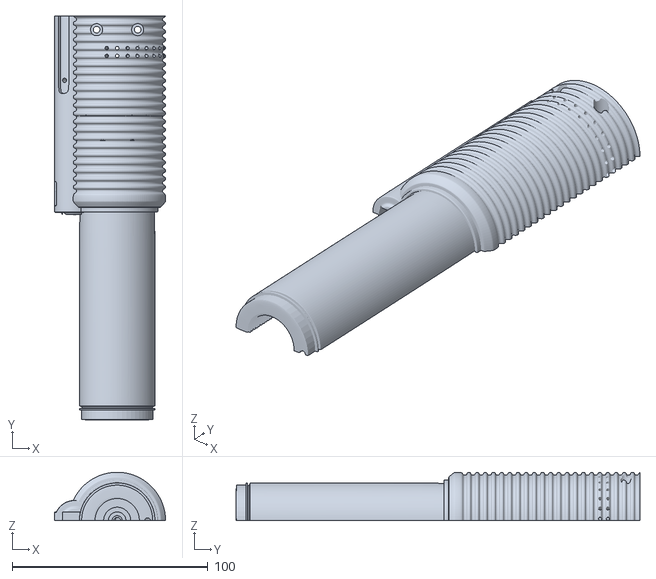
[picture p44: CAD file, 2026-10-18]
gehaeuse/mp5_giessfuellung/handschutz_vorn_links.stl
56.8 x 206.5 x 24.8
