G5K-org/open-lasertag/gehaeuse/mp5_umbau/nachladehebel.stl

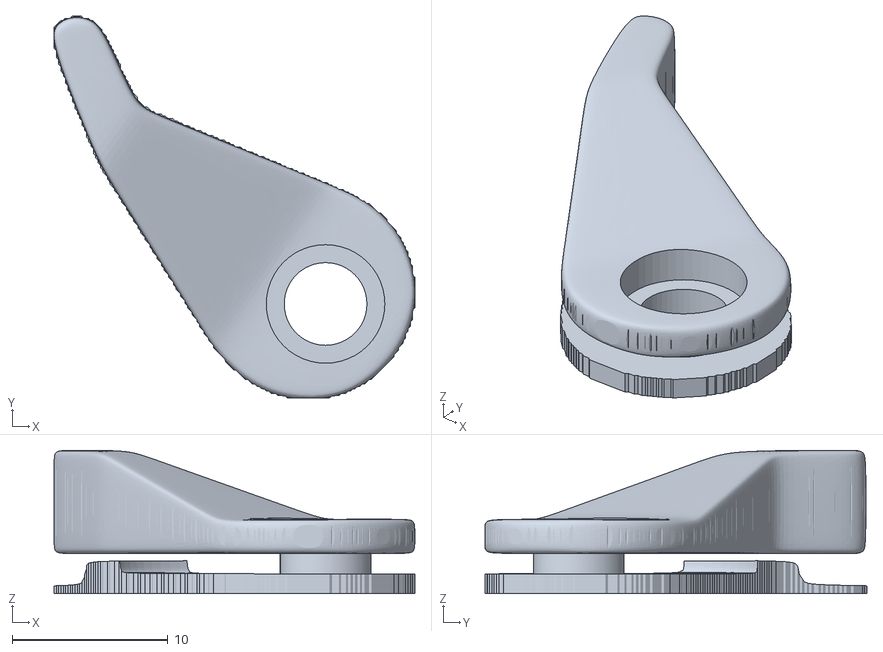
[picture p45: CAD file, 2026-10-13]
gehaeuse/mp5_umbau/nachladehebel.stl
23.1 x 24.5 x 9.19
