G5K-org/open-lasertag/kicad/waffe_elektronik/3dmodels/WSON-8-1EP_8x6mm_P1.27mm_EP3.4x4.3mm.step

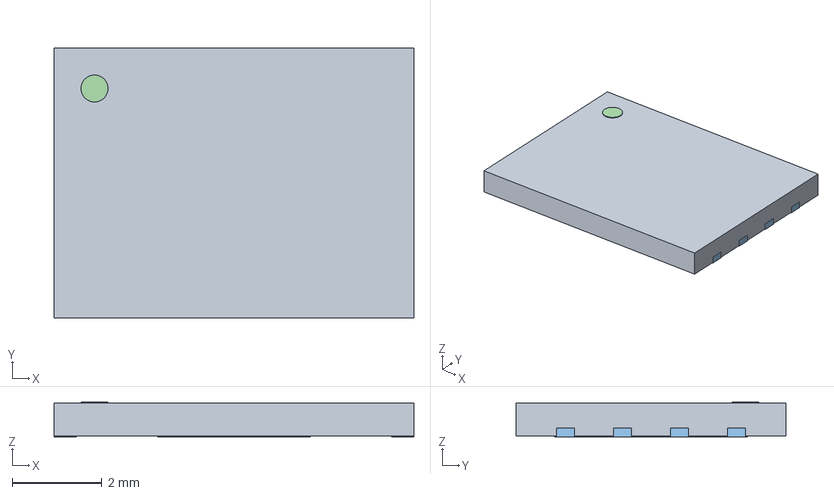
[picture p46: CAD file, 2026-10-14]
kicad/waffe_elektronik/3dmodels/WSON-8-1EP_8x6mm_P1.27mm_EP3.4x4.3mm.step
8.00 x 6.00 x 0.77 mm
