G5K-org/open-lasertag/gehaeuse/mp5_giessfuellung/gehaeuse_rechts.stl

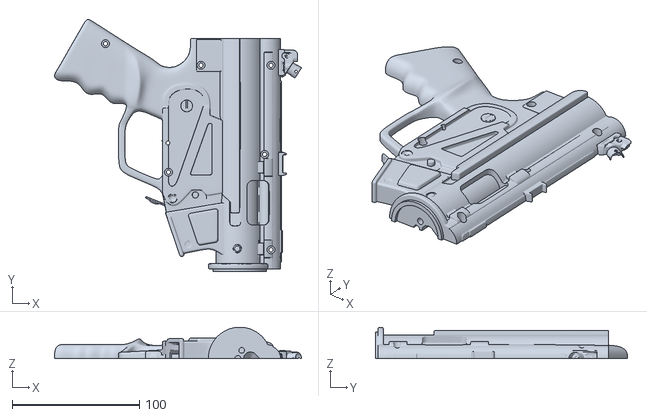
[picture p47: CAD file, 2026-10-18]
gehaeuse/mp5_giessfuellung/gehaeuse_rechts.stl
194.0 x 198.0 x 24.7
