G5K-org/open-lasertag/gehaeuse/mp5_umbau/abzug.stl

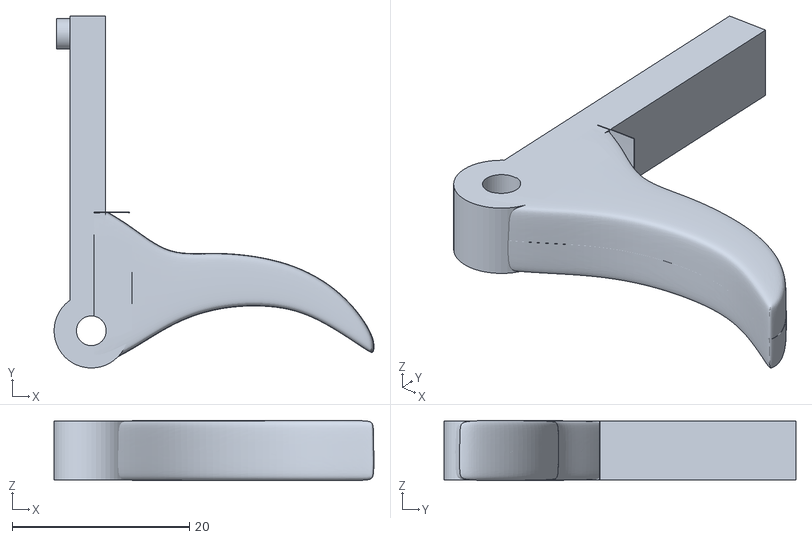
[picture p48: CAD file, 2026-10-13]
gehaeuse/mp5_umbau/abzug.stl
36.1 x 39.7 x 6.77
