G5K-org/open-lasertag/kicad/waffe_elektronik/3dmodels/USB_C_Receptacle_HX_TYPE-C-16P-180-LT-H10.5_Vertical.step

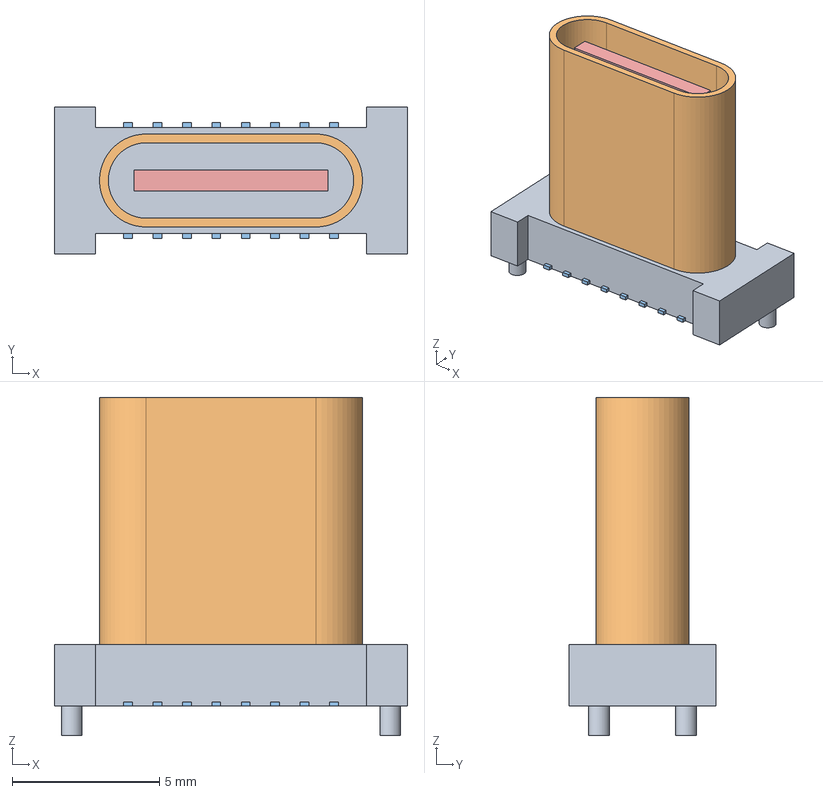
[picture p49: CAD file, 2026-10-13]
kicad/waffe_elektronik/3dmodels/USB_C_Receptacle_HX_TYPE-C-16P-180-LT-H10.5_Vertical.step
12.0 x 5.00 x 11.5 mm
