G5K-org/open-lasertag/gehaeuse/mp5_giessfuellung/handschutz_hinten.stl

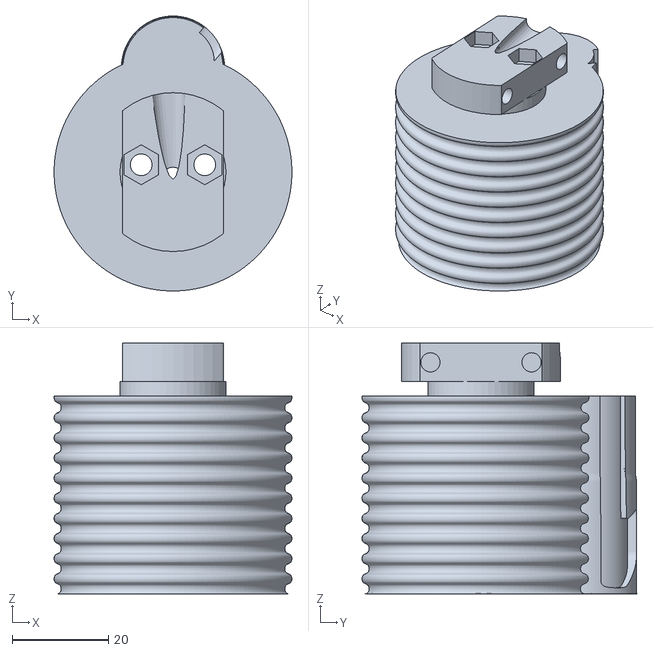
[picture p50: CAD file, 2026-10-18]
gehaeuse/mp5_giessfuellung/handschutz_hinten.stl
49.4 x 57.1 x 52.1
