G5K-org/open-lasertag/gehaeuse/mp5_umbau/handschutz_hinten.stl

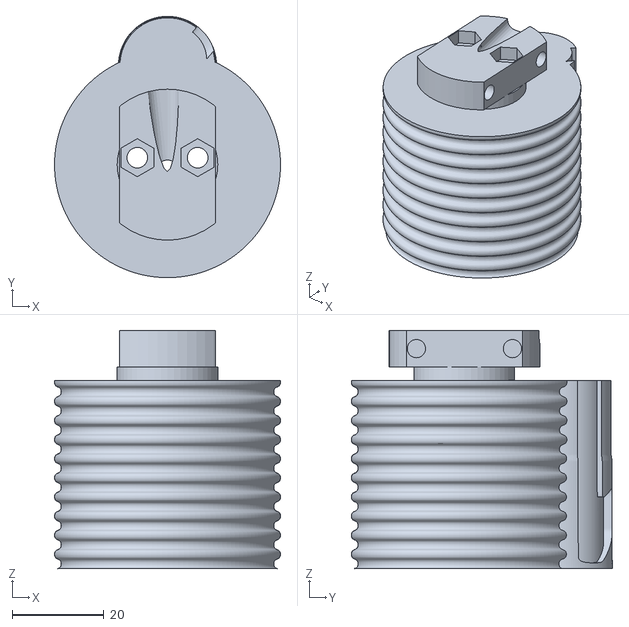
[picture p51: CAD file, 2026-10-13]
gehaeuse/mp5_umbau/handschutz_hinten.stl
49.4 x 57.1 x 52.1
