G5K-org/open-lasertag/kicad/waffe_elektronik/3dmodels/JST_PH_S3B-PH-SM4-TB_1x03-1MP_P2.00mm_Horizontal.step

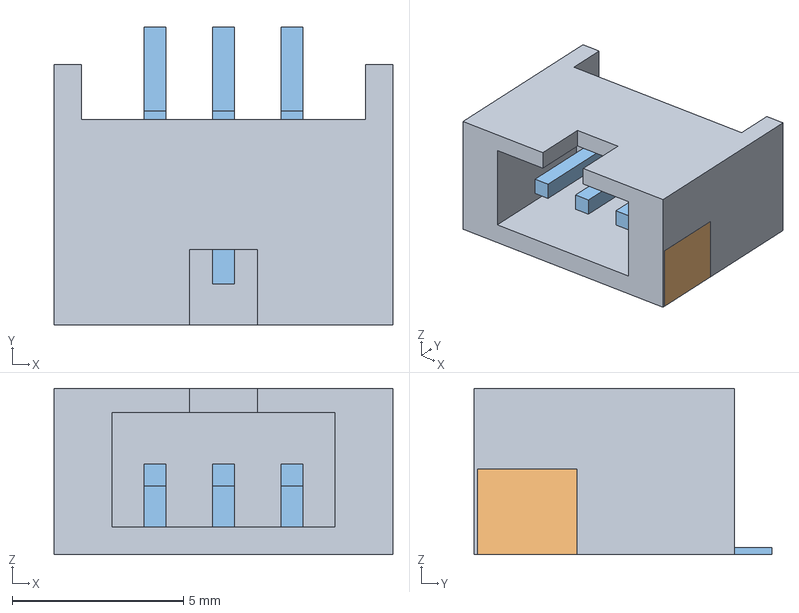
[picture p52: CAD file, 2026-10-12]
kicad/waffe_elektronik/3dmodels/JST_PH_S3B-PH-SM4-TB_1x03-1MP_P2.00mm_Horizontal.step
9.90 x 8.70 x 4.85 mm
