G5K-org/open-lasertag/gehaeuse/mp5_giessfuellung/schaft_rechts.stl

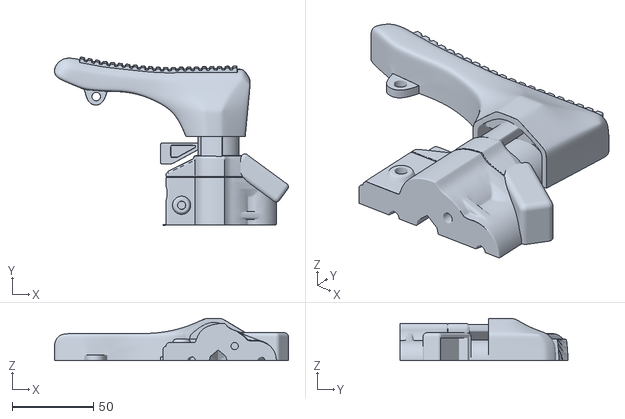
[picture p53: CAD file, 2026-10-18]
gehaeuse/mp5_giessfuellung/schaft_rechts.stl
144.2 x 103.6 x 26.1
