G5K-org/open-lasertag/gehaeuse/mp5_umbau/zwischenring.stl

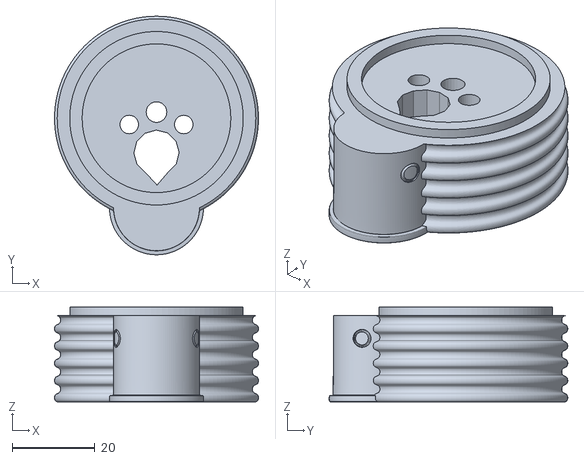
[picture p54: CAD file, 2026-10-13]
gehaeuse/mp5_umbau/zwischenring.stl
49.4 x 57.8 x 22.9
