G5K-org/open-lasertag/kicad/waffe_elektronik/3dmodels/JST_PH_S2B-PH-SM4-TB_1x02-1MP_P2.00mm_Horizontal.step

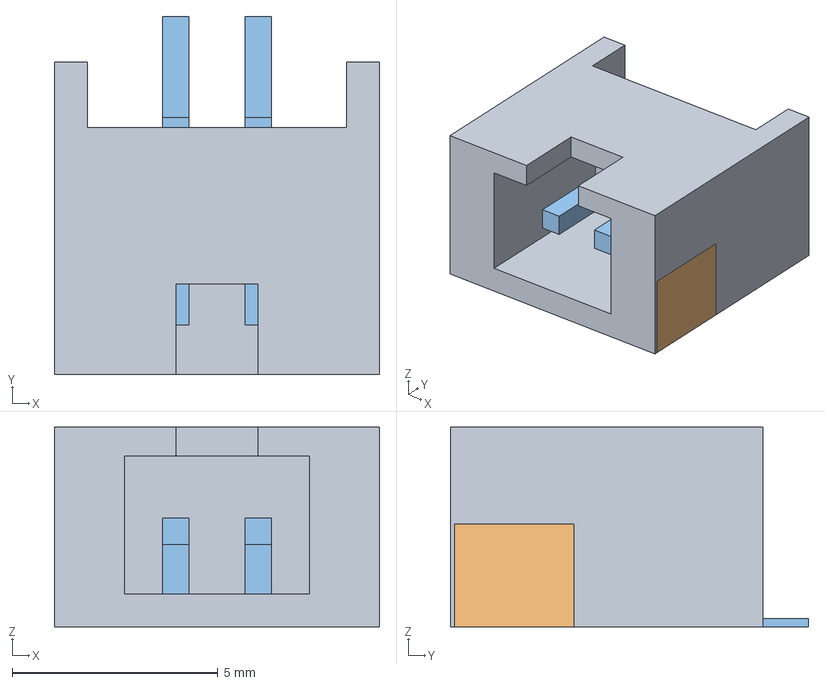
[picture p55: CAD file, 2026-10-12]
kicad/waffe_elektronik/3dmodels/JST_PH_S2B-PH-SM4-TB_1x02-1MP_P2.00mm_Horizontal.step
7.90 x 8.70 x 4.85 mm
