G5K-org/open-lasertag/gehaeuse/mp5_umbau/schaft_links.stl

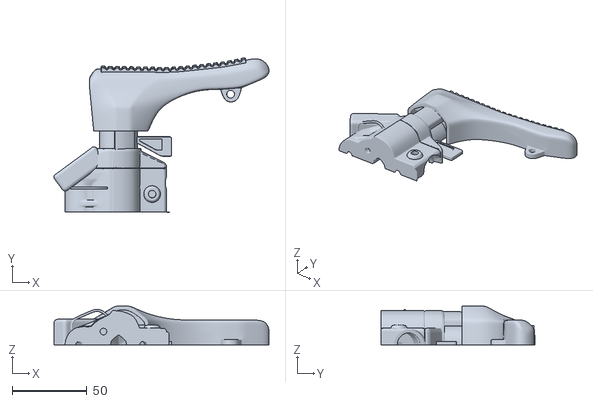
[picture p56: CAD file, 2026-10-13]
gehaeuse/mp5_umbau/schaft_links.stl
144.2 x 103.6 x 26.1
