G5K-org/open-lasertag/gehaeuse/mp5_umbau/steg_vorn_96mm.stl

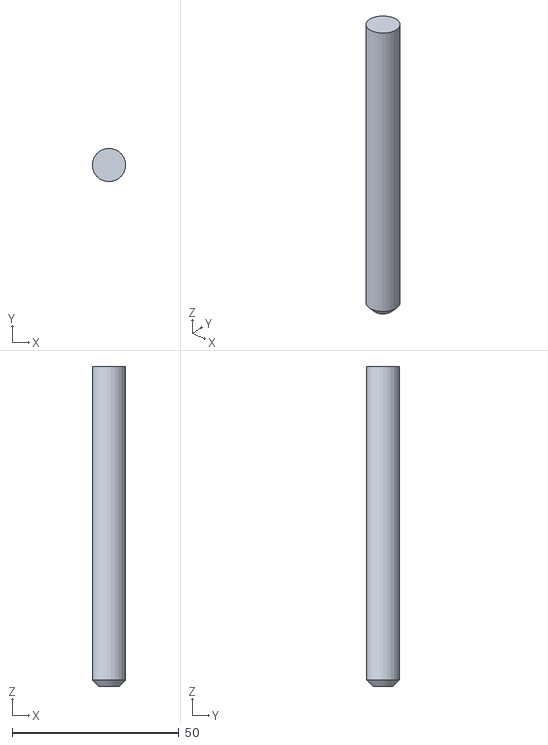
[picture p59: CAD file, 2026-10-12]
gehaeuse/mp5_umbau/steg_vorn_96mm.stl
10.0 x 9.93 x 96.0
