G5K-org/open-lasertag/gehaeuse/mp5_umbau/spannhebel_knauf.stl

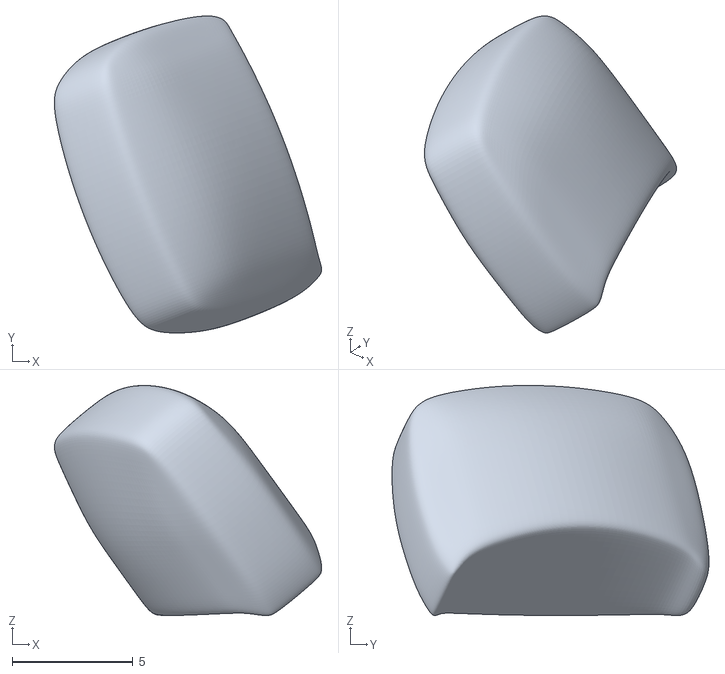
[picture p60: CAD file, 2026-10-12]
gehaeuse/mp5_umbau/spannhebel_knauf.stl
11.1 x 13.1 x 9.52
