G5K-org/open-lasertag/gehaeuse/mp5_umbau/spannhebel_stift.stl

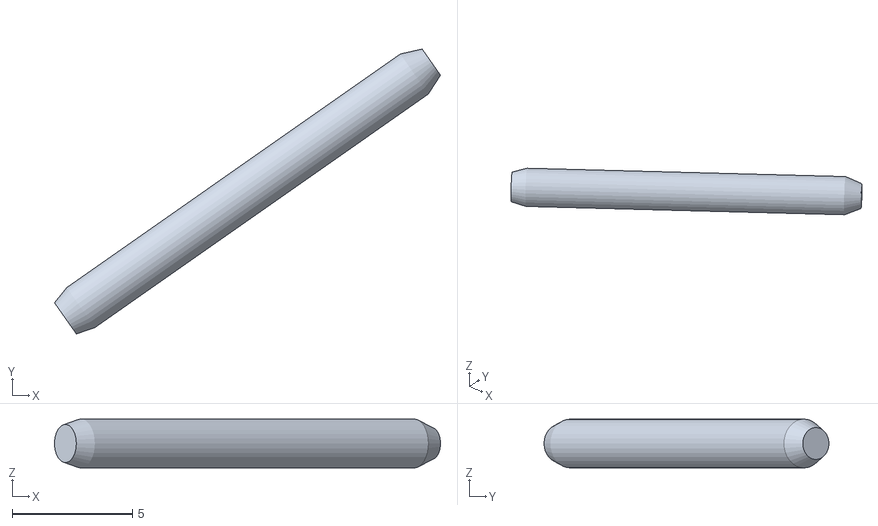
[picture p61: CAD file, 2026-10-12]
gehaeuse/mp5_umbau/spannhebel_stift.stl
16.0 x 11.8 x 2.03
