G5K-org/open-lasertag/gehaeuse/mp5_umbau/tsop_einsatz.stl

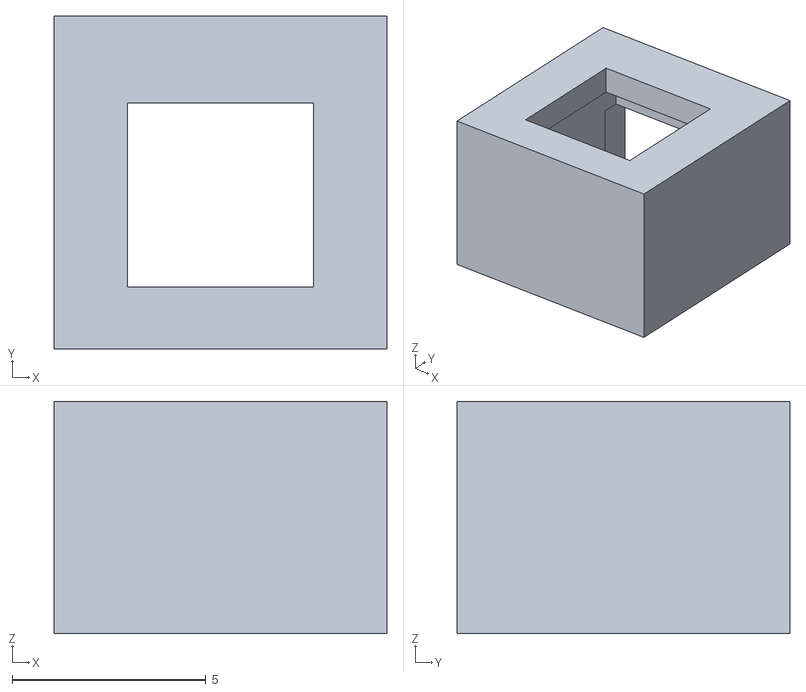
[picture p62: CAD file, 2026-10-12]
gehaeuse/mp5_umbau/tsop_einsatz.stl
8.60 x 8.60 x 6.00
