G5K-org/open-lasertag/gehaeuse/mp5_umbau/korn.stl

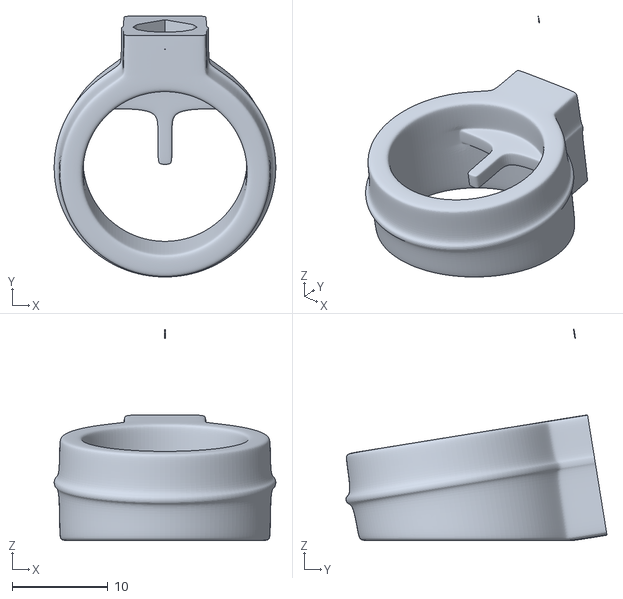
[picture p63: CAD file, 2026-10-12]
gehaeuse/mp5_umbau/korn.stl
23.1 x 27.3 x 22.1
