G5K-org/open-lasertag/gehaeuse/mp5_umbau/linsenhuelse.stl

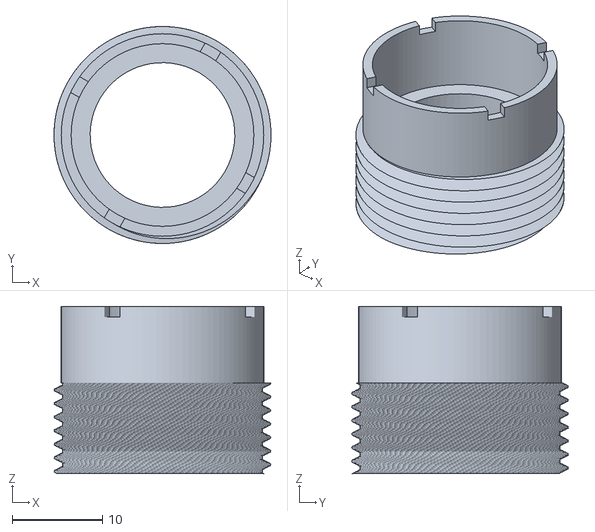
[picture p64: CAD file, 2026-10-12]
gehaeuse/mp5_umbau/linsenhuelse.stl
24.0 x 24.0 x 18.5
