G5K-org/open-lasertag/gehaeuse/mp5_umbau/oled_rahmen.stl

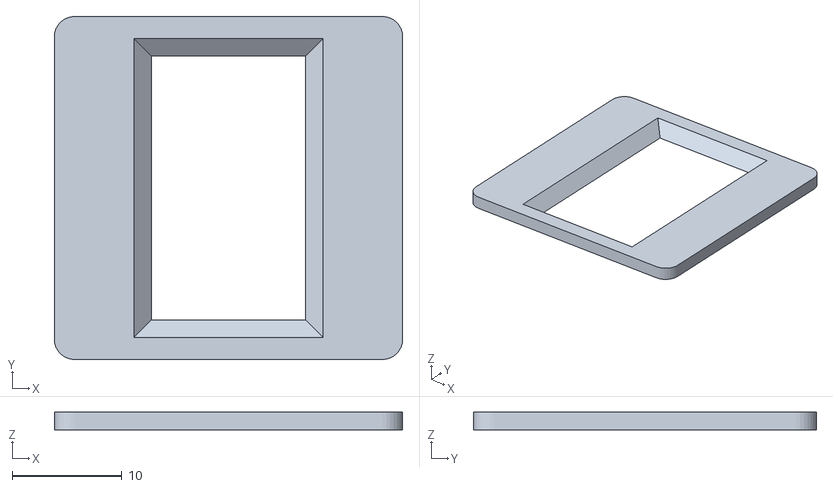
[picture p65: CAD file, 2026-10-12]
gehaeuse/mp5_umbau/oled_rahmen.stl
31.7 x 31.2 x 1.60
