G5K-org/open-lasertag/gehaeuse/mp5_umbau/frontkappe.stl

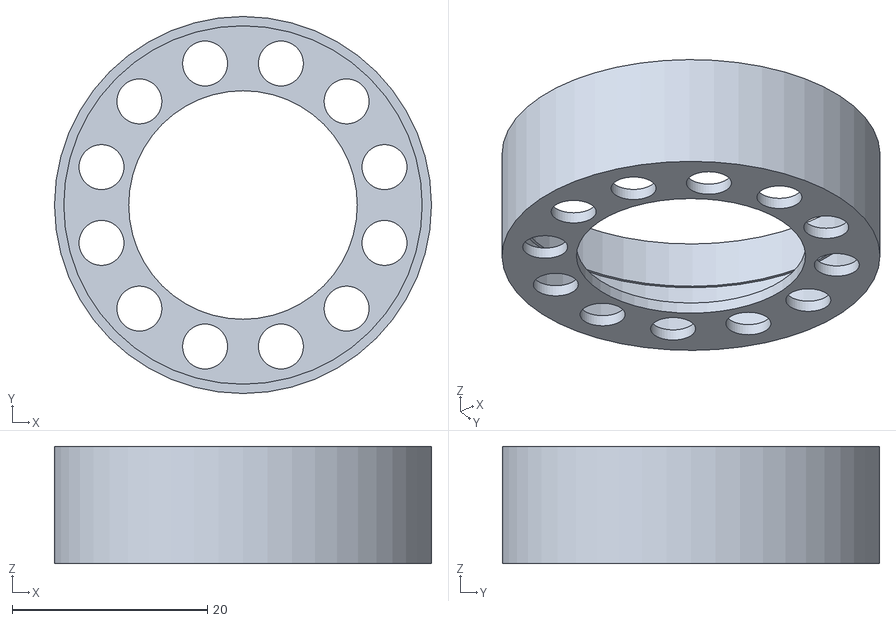
[picture p66: CAD file, 2026-10-12]
gehaeuse/mp5_umbau/frontkappe.stl
38.6 x 38.6 x 12.0
