G5K-org/open-lasertag/gehaeuse/mp5_umbau/magazin_unterteil.stl

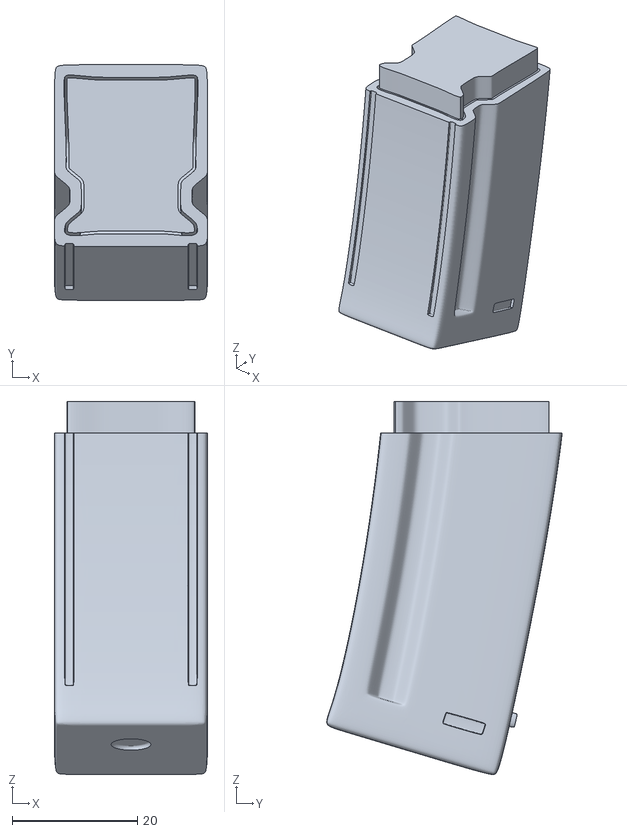
[picture p67: CAD file, 2026-10-12]
gehaeuse/mp5_umbau/magazin_unterteil.stl
24.5 x 37.7 x 59.6
