G5K-org/open-lasertag/gehaeuse/mp5_umbau/magazin.stl

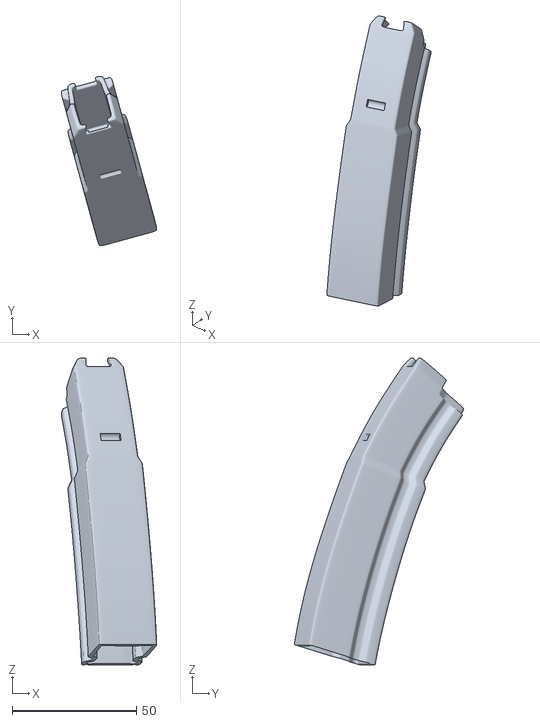
[picture p68: CAD file, 2026-10-12]
gehaeuse/mp5_umbau/magazin.stl
38.5 x 68.3 x 123.7
