G5K-org/open-lasertag/gehaeuse/mp5_umbau/steg_hinten_77mm.stl

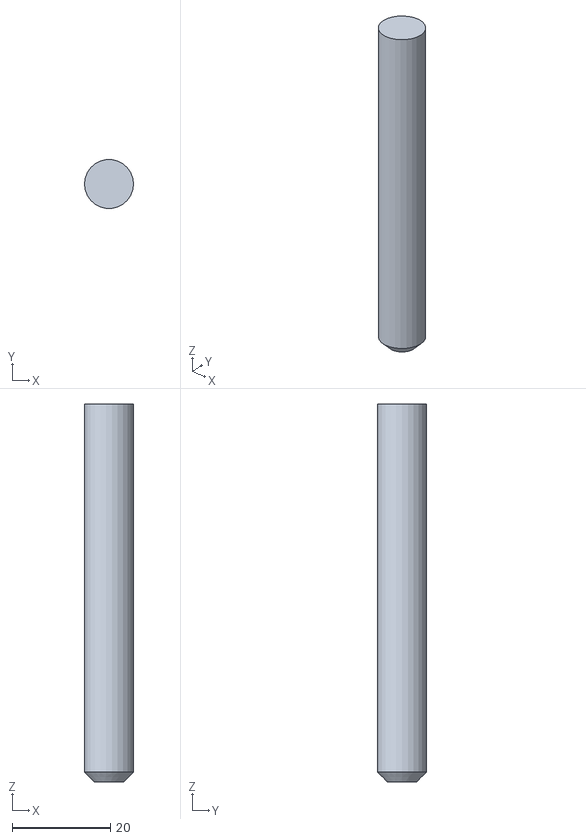
[picture p69: CAD file, 2026-10-12]
gehaeuse/mp5_umbau/steg_hinten_77mm.stl
10.0 x 9.93 x 77.0
