G5K-org/open-lasertag/(list of files, cad)

Other CAD files:
gehaeuse/bambu/mp5_guss_p2s.3mf
gehaeuse/orca/mp5_guss_i3megas.3mf
gehaeuse/orca/mp5_guss_x2.3mf
gehaeuse/mp5_giessfuellung/schaft_links.stl
gehaeuse/mp5_umbau/schaft_rechts.stl
