G5K-org/open-lasertag/kicad/waffe_elektronik/waffe_elektronik.kicad_pcb

## KiCad design kicad/waffe_elektronik/waffe_elektronik.kicad_pcb (2026-10-15)

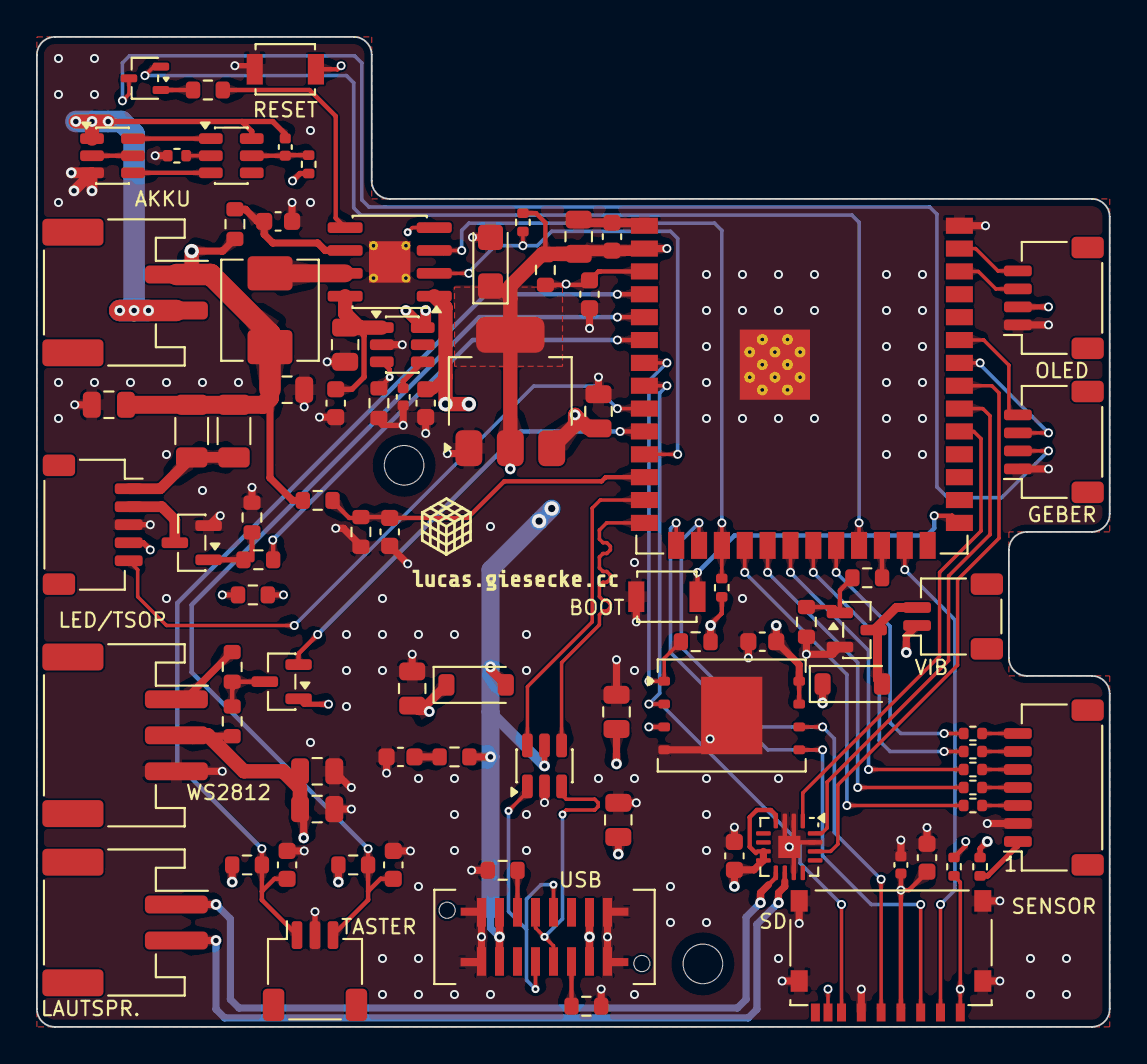
[picture p70: board waffe_elektronik.kicad_pcb from above]

Board: 4 copper layers, 59.6 x 55.0 mm, 89 parts (0 on the bottom side), 72 nets.

Parts:
BT1: 1S LiPo 3,7 V; JST_PH_S2B-PH-SM4-TB_1x02-1MP_P2.00mm_Horizontal
C1, C7, C10, C19, C20, C31, C32: 22u; C_0805_2012Metric
C2, C18, C22: 10u; C_0805_2012Metric
C3: 10u; CP_EIA-3216-18_Kemet-A
C4, C28, C29, C30: 10u; C_0603_1608Metric
C5: 22u; C_0603_1608Metric
C6, C8, C9, C17, C23, C25: 100n; C_0603_1608Metric
C16: 1u; C_0603_1608Metric
C26, C27: 100n; C_0402_1005Metric
C33: 10n; C_0402_1005Metric
D1, D4: B5819W; D_SOD-123
D6: BAT54CW; SOT-323_SC-70
H1, H2: M2; MountingHole_2.2mm_M2_ISO7380
J1: WS2812 HP-Streifen; JST_PH_S3B-PH-SM4-TB_1x03-1MP_P2.00mm_Horizontal
J2: GX16 7-polig; JST_SH_SM07B-SRSS-TB_1x07-1MP_P1.00mm_Horizontal
J3: USB-C (Flashen + Laden); USB_C_Receptacle_HX_TYPE-C-16P-180-LT-H10.5_Vertical
J4: OLED I²C (Qwiic); JST_SH_SM04B-SRSS-TB_1x04-1MP_P1.00mm_Horizontal
J5: Drehgeber; JST_SH_SM04B-SRSS-TB_1x04-1MP_P1.00mm_Horizontal
J6: IR-LED + TSOP 6; JST_SH_SM05B-SRSS-TB_1x05-1MP_P1.00mm_Horizontal
J7: TF-018; microSD_TF-018_PushPull
J8: Abzug + Nachladen; JST_SH_SM03B-SRSS-TB_1x03-1MP_P1.00mm_Horizontal
L1: 1u; L_Sunlord_MWSA0503S
M1: Vibromotor; JST_SH_SM02B-SRSS-TB_1x02-1MP_P1.00mm_Horizontal
Q1, Q2: AO3400A; SOT-23
Q3: FS8205A; SOT-23-6
Q4: 2N7002; SOT-23
R1: 2; R_0603_1608Metric
R2: 1; R_0603_1608Metric
R3, R4: 1M; R_0603_1608Metric
R5, R11: 100; R_0603_1608Metric
R6, R12, R42: 100k; R_0603_1608Metric
R7, R8: 22; R_1206_3216Metric
R9, R10, R21, R24, R27: 10k; R_0603_1608Metric
R15: 330; R_0603_1608Metric
R22, R23: 5.1k; R_0603_1608Metric
R25: 1k; R_0603_1608Metric
R28, R30, R31, R32, R33, R34: 100; R_0402_1005Metric
R29: 1k; R_0402_1005Metric
R35: 10; R_0402_1005Metric
R36: 10; R_0603_1608Metric
R37: 10k; R_0402_1005Metric
R38, R40: 4.7k; R_0402_1005Metric
SP1: Lautsprecher; JST_PH_S2B-PH-SM4-TB_1x02-1MP_P2.00mm_Horizontal
SW3: RESET; SW_SPST_B3U-1000P
SW4: BOOT; SW_SPST_B3U-1000P
U1: IP5306-I2C; HSOP-8-1EP_3.9x4.9mm_P1.27mm_EP2.3x2.3mm_ThermalVias
U2: AMS1117-3.3; SOT-223-3_TabPin2
U4: ESP32-S3-WROOM-1-N16R8; ESP32-S3-WROOM-1
U6: MAX98357A; TQFN-16-1EP_3x3mm_P0.5mm_EP1.23x1.23mm
U12: USBLC6-2SC6; SOT-23-6
U14: ZD35Q1GC-IB; WSON-8-1EP_8x6mm_P1.27mm_EP3.4x4.3mm
U15: DW01A; SOT-23-6
U16: TPS22810; SOT-23-6

Connections:
3V3_J6: J6.4, R36.2
3V3_MCU: C3.1, C17.1, C18.1, C25.1, C26.1, C28.1, J4.2, J7.4, Q4.1, R9.1, R10.1, R21.1, R27.1, R35.1, R36.1, R37.2, R38.1, R40.1, U2.2, U4.2, U14.3, U14.7, U14.8
3V3_WESTE: J2.1, R35.2
5V_PERIPH: C1.1, C2.1, C10.1, C22.1, C23.1, C31.1, C32.1, D1.1, D4.1, J1.2, M1.1, R25.1, U2.3, U6.4, U6.7, U6.8, U16.6
ADC_BATT: C6.1, R3.2, R4.1, U4.12
BAT_N: BT1.2, C27.2, Q3.1, U15.6
BAT_P: BT1.1, C7.1, C19.1, L1.2, R2.2, R3.1, R7.1, R8.1, R28.1
ENC_A: J5.4, U4.35
ENC_B: J5.3, U4.34
ENC_SW: D6.2, U4.23
FLASH_CS: R27.2, U4.7, U14.1
GND: C1.2, C2.2, C3.2, C4.2, C5.2, C6.2, C7.2, C8.2, C9.2, C10.2, C16.2, C17.2, C18.2, C19.2, C20.2, C22.2, C23.2, C25.2, C26.2, C28.2, C29.2, C30.2, C31.2, C32.2, C33.2, J1.3, J2.2, J3.A1, J3.A12, J3.B1, J3.B12, J3.SH, J4.1, J5.1, J6.3, J7.6, J7.SH, J8.2, Q1.2, Q2.2, Q3.3, R4.2, R6.2, R12.2, R22.2, R23.2, R29.2, R42.2, SW3.1, SW4.1, U1.9, U2.1, U4.1, U4.40, U4.41, U6.2, U6.3, U6.11, U6.15, U6.17, U12.2, U14.4, U14.9, U16.2
I2C_SCL: J4.4, U4.39
I2C_SDA: J4.3, U4.38
I2S_BCLK: U4.32, U6.16
I2S_DOUT: U4.31, U6.1
I2S_LRCLK: U4.33, U6.14
IP_IRQ: R42.1, U1.4, U16.3
IP_KEY: R24.1, U1.5
IP_SCL: R40.2, U1.2, U4.11
IP_SDA: R38.2, U1.3, U4.17
IR_GATE: R5.1, U4.6
IR_LED_A: J6.1, R7.2, R8.2
IR_LED_K: J6.2, Q1.3
unnamed: C29.1, R1.2
unnamed: D1.2, M1.2, Q2.3
unnamed: D6.1, R24.2
unnamed: J1.1, R15.2
unnamed: J3.A5, R23.1
unnamed: J3.B5, R22.1
unnamed: J3.A6, J3.B6, U12.3
unnamed: J3.A7, J3.B7, U12.1
unnamed: Q1.1, R5.2, R6.1
unnamed: Q2.1, R11.2, R12.1
unnamed: Q3.2, Q3.5
unnamed: Q3.6, U15.1
unnamed: Q3.4, U15.3
unnamed: Q4.3, R15.1, R25.2
unnamed: C5.1, R2.1, U1.6
unnamed: L1.1, U1.7
unnamed: C20.1, C30.1, U1.8, U16.1
unnamed: C16.1, R21.2, SW3.2, U4.3
unnamed: SW4.2, U4.27
unnamed: SP1.2, U6.10
unnamed: SP1.1, U6.9
unnamed: R29.1, U15.2
unnamed: C27.1, R28.2, U15.5
unnamed: C33.1, U16.4
PWR_KEY: D6.3, J5.2
RELOAD: C9.1, J8.3, R10.2, U4.5
SD_CS: J7.2, U4.25
SD_DAT12: J7.1, J7.8, R37.1
SPI_CLK: J7.5, U4.16, U14.6
SPI_MISO: J7.7, U4.8, U14.2
SPI_MOSI: J7.3, U4.15, U14.5
TRIGGER: C8.1, J8.1, R9.2, U4.4
TSOP1_J: J2.3, R30.2
TSOP1_OUT: R30.1, U4.18
TSOP2_J: J2.4, R31.2
TSOP2_OUT: R31.1, U4.19
TSOP3_J: J2.5, R32.2
TSOP3_OUT: R32.1, U4.20
TSOP4_J: J2.6, R33.2
TSOP4_OUT: R33.1, U4.21
TSOP5_J: J2.7, R34.2
TSOP5_OUT: R34.1, U4.22
TSOP6_OUT: J6.5, U4.9
USB_D+: U4.14, U12.4
USB_D-: U4.13, U12.6
VBUS_NATIVE: C4.1, D4.2, J3.A4, J3.A9, J3.B4, J3.B9, R1.1, U1.1, U12.5
VIB: R11.1, U4.24
WS2812_DIN_3V3: Q4.2, U4.10
