G5K-org/open-lasertag/gehaeuse/scripts/kabelwege.py

"""Prüfung aller Kabelwege in der Baugruppe: jede Leitung vom Stecker auf der Platine bis zum Bauteil.

Aufruf: python kabelwege.py   (mp5_umbau/ muss mit umbau.py erzeugt sein; Platine per kicad-cli)

Jede Leitung ist eine Kette gerader Stücke (Gun-Rahmen, siehe platine_einbau.py). Entlang des Wegs wird ein
Zylinder mit dem Radius des Kabelbündels gegen alle Teile der Baugruppe geprüft (Platine eingeschlossen).
Die Wege beginnen an der Steckeröffnung am Platinenrand (bzw. am Pin für die Stecker in den alten Zonen,
die ersten 3 mm werden nicht geprüft). Jeder Stecker zeigt in die Zone
am Platinenrand, aus der sein Schacht abgeht (links: Hauptschacht, unten: Abzugsschalter, rechts: Motorschacht).
Ausgabe: Länge, Bündelradius, frei/blockiert und die Füllung der gemeinsam genutzten Schächte.
"""
import os
import sys
import tempfile

import numpy as np
import trimesh

sys.path.insert(0, os.path.dirname(os.path.abspath(__file__)))
import baugruppe as B  # noqa: E402
import platine_einbau as P  # noqa: E402
import umbau as U  # noqa: E402

AWG28, AWG24 = 0.9, 1.3       # Außendurchmesser Litze mit Isolierung (mm)


def meshes():
    out = {}
    for name, src, mat, _ in B.parts():
        if name.startswith("Pigtail"):                              # wird als Kabelweg geprüft
            continue
        out[name] = B.mesh_of(name, src, mat)
    with tempfile.TemporaryDirectory() as tmp:
        bs, g = B.board(tmp)
        pcb = []
        for node in bs.graph.nodes_geometry:
            t, gn = bs.graph[node]
            geo = bs.geometry[gn].copy()
            geo.apply_transform(g @ t)
            pcb.append(geo)
        out["Platine"] = trimesh.util.concatenate(pcb)
    return out


def routes(M):
    ax = U.AX[0]
    mv = M[B.NAMES["magazin"]].vertices
    mag_top = mv[mv[:, 0] < mv[:, 0].min() + 1.5].mean(0)          # wie magazine_parts()
    sv = np.array([U.OLED_S[0], U.OLED_S[1], 0.0]); sv /= np.linalg.norm(sv)
    nv = np.array([-sv[1], sv[0], 0.0])
    c = np.array([U.OLED_FACE_C[0], U.OLED_FACE_C[1], 0.0]) + sv * U.OLED_SHIFT
    depth = U.OLED_FRAME[0] + U.OLED_GLASS[2] + U.OLED_PCB[2] + U.OLED_BACK
    oled = c - nv * (depth - 1.5) - sv * 9.0                       # wie housing_cuts()
    n = np.array([U.ENC_NORMAL[0], U.ENC_NORMAL[1], 0.0]); n /= np.linalg.norm(n)
    bd, bl, w, zw, h, back = U.ENC
    enc = np.array([U.ENC_FACE[0], U.ENC_FACE[1], 0.0]) - n * (bl + h + back - 1.0)
    trunk_in = [(81.0, 88.5, 0)]                                     # Hauptschacht in der linken Zone
    hg = [(81, 12, 0), (81, -40.5, 0), (U.LOBE[0], -44, U.LOBE[1]), (U.LOBE[0], -103, U.LOBE[1]),
          (81, -116, 0), (81, -156, 0)]
    def g(bx, by, z=2.0):                                            # Platinenkoordinaten -> Gun-Rahmen
        return (P.X0 + by, P.Y0 + bx, z)
    left = 89.0                                                      # Y in der linken Zone (vor der Platine)
    seat, a, inner = U.gx_axis()
    motor = [tuple(p) for p in U.MOTOR_PATH[::-1]]                 # VIB-Zone -> Motor
    spk = (ax - U.BASS[0] / 2 + 1, U.SPK_Y - U.SPK[1] - 4, U.LOBE[1])
    LEVER = U.reload_lever()[3]
    # Name: (Adern, Ader-Ø, Weg ab Steckermaul auf der Platine, gemeinsame Schächte)
    return {
        "Akku (BT1)": (2, AWG24, [(81.2, 97.8, 2), (81.2, 89.5, 2)] + trunk_in
                       + [(81, mag_top[1], 0), (88, mag_top[1], 0), tuple(mag_top + [3, 0, 0])], ["Hauptschacht Gehäuse"]),
        "IR-LED (J6)": (2, AWG28, [(94.1, 96, 2), (94.1, 89.5, 2)] + trunk_in + hg
                          + [(81, -193.4, 0), (ax, -197, 0)], ["Hauptschacht Gehäuse", "Hauptschacht Handschutz"]),
        "TSOP 6 (J6)": (3, AWG28, [(94.1, 96, 2), (94.1, 89.5, 2)] + trunk_in + hg[:5]
                        + [(81, -129.4, 0), (59.3, -129.4, 0)], ["Hauptschacht Gehäuse", "Hauptschacht Handschutz"]),
        "Ringlicht (J1)": (3, AWG28, [g(-0.5, 29.8), (P.X0 + 29.8, left, 2), (82, left, 1)] + trunk_in + hg
                           + [(81, -193.4, 0), (ax + U.WIRE_R, -193.4, 0), (ax + U.WIRE_R, -236, 0)],
                           ["Hauptschacht Gehäuse", "Hauptschacht Handschutz"]),
        "Lautsprecher (SP1)": (2, AWG28, [g(-0.5, 40.2), (P.X0 + 40.2, left, 2), (82, left, 1)] + trunk_in
                               + hg[:4] + [(U.LOBE[0], spk[1], U.LOBE[1]), spk],
                               ["Hauptschacht Gehäuse", "Hauptschacht Handschutz"]),
        "Abzug (J8)": (2, AWG28, [g(15.45, 46.5), (125.5, P.Y0 + 15.45, 2), (125.5, 145, 0), (128.7, 152, 0)], []),
        "Nachladen (J8)": (2, AWG28, [g(15.45, 46.5), (124.5, P.Y0 + 15.45, 2), (125.5, 145, 0), (128.7, 152, 0)]
                            + [tuple(p) for p in U.RELOAD_WIRE[::-1]] + [LEVER["wire0"]], []),
        "Weste (J2)": (7, AWG28, [g(60.1, 32.7), (P.X0 + 32.7, 156.1, 2), (P.X0 + 30.0, 156.1, 1), (P.X0 + 24.0, 156.1, 1)] + motor[:2] + [tuple(p) for p in U.GX_PATH[::-1]] + [tuple(inner + a * 2), tuple(inner + a * 4)],
                       ["Motorschacht", "Westenschacht"]),
        "OLED (J4)": (4, AWG28, [(81.5, 149.4, 2), (81.5, 156, 2), (P.X0 + 1, 156, 0), (68, 170, 0), tuple(oled)],
                      ["OLED-Schacht"]),
        "Drehgeber (J5)": (4, AWG28, [(89.5, 149.4, 2), (89.5, 156, 2), (97.5, 156, 0), (100, 152, 0),
                                      (101.5, 151.4, 0)] + motor[1:] + [(152, 183, 0), tuple(enc)],
                           ["Motorschacht"]),
        "Antenne (Pigtail)": (1, 1.13, P.pigtail_path() + [P.UFL], []),
        "Vibrationsmotor (M1)": (2, AWG28, [g(54.5, 23.2), (P.X0 + 23.2, 150.5, 2)] + motor + [(149, 170, 0)],
                                 ["Motorschacht"]),
    }


SHAFTS = {"Hauptschacht Gehäuse": U.TRUNK[1], "Hauptschacht Handschutz": U.TRUNK[1], "Westenschacht": U.GX_WIRE,
          "OLED-Schacht": 2.25, "Motorschacht": U.MOTOR_WIRE}


def bundle_r(n, d):
    return 0.5 * d * np.sqrt(n) * 1.15


def blocked(M, pts, r, step=0.5):
    hits = []
    p0, p1 = np.array(pts[0], float), np.array(pts[-1], float)   # Kabelenden stecken im Stecker / Bauteil
    for a, b in zip(pts, pts[1:]):
        a, b = np.array(a, float), np.array(b, float)
        L = np.linalg.norm(b - a)
        if L < 1e-6:
            continue
        d = (b - a) / L
        u = np.cross(d, [0, 0, 1.0])
        if np.linalg.norm(u) < 1e-6:
            u = np.cross(d, [1.0, 0, 0])
        u /= np.linalg.norm(u)
        v = np.cross(d, u)
        cs = [a + (b - a) * t for t in np.linspace(0, 1, int(L / step) + 2)]
        Q = np.array([p + r * (np.cos(q) * u + np.sin(q) * v) for p in cs
                      for q in np.linspace(0, 2 * np.pi, 8, endpoint=False)] + cs)
        for k, m in M.items():
            sel = ((Q >= m.bounds[0] - 0.01) & (Q <= m.bounds[1] + 0.01)).all(1)
            if not sel.any():
                continue
            ins = np.zeros(len(Q), bool)
            ins[sel] = m.contains(Q[sel])
            ins &= (np.linalg.norm(Q - p0, axis=1) > 3.0 + r) & (np.linalg.norm(Q - p1, axis=1) > 3.0 + r)
            if ins.any():
                hits.append((k, np.round(Q[ins].mean(0), 1).tolist()))
    return hits


def main():
    M = meshes()
    fill = {k: 0.0 for k in SHAFTS}
    ok = True
    for name, (n, d, pts, shafts) in routes(M).items():
        r = bundle_r(n, d)
        length = sum(np.linalg.norm(np.subtract(b, a)) for a, b in zip(pts, pts[1:]))
        hits = blocked(M, pts, r)
        ok &= not hits
        print(f"{name:22s} {n} x Ø {d:.1f}  Bündel Ø {2 * r:.1f}  Weg ca. {length:4.0f} mm  "
              + ("frei" if not hits else "BLOCKIERT"))
        for h in hits:
            print("    in", h[0], "bei", h[1])
        for s in shafts:
            fill[s] += n * np.pi * d * d / 4
    print()
    for s, a in fill.items():
        print(f"{s:26s} Ø {2 * SHAFTS[s]:.1f}  Adern {a:5.1f} mm²  Füllung {100 * a / (np.pi * SHAFTS[s] ** 2):3.0f} %")
    return ok


if __name__ == "__main__":
    sys.exit(0 if main() else 1)
