G5K-org/open-lasertag/(commit log)

2026-10-08 Entferne optionalen Waffen-TSOP, ergänze Review-Punkte
    Korrigiert die Trägerfrequenz des Eigenprotokolls auf 38 kHz (passend
    zum TSOP34838), ergänzt Paketabsicherung, UDP-Server-Hinweis,
    PWM-Beleuchtungsrisiko sowie Akku- und OTA-Punkte in den offenen Punkten.
2026-10-08 Konsolidiere Elektronik auf einen ESP32-S3 in der Waffe
    Ersetzt das Zweichip-Design (Weste=Host/Waffe=Device per USB-CDC) durch
    einen einzigen ESP32-S3 in der Waffe; die Weste trägt nur noch passive
    TSOP-Sensoren über ein mehradriges Sensorkabel (GX12/GX16-Stecker statt
    USB-C). Firmware läuft auf ESP-IDF statt Arduino, nur offizielle
    Espressif-Komponenten (RMT, I2S, led_strip, esp_wifi). Pinbelegung,
    Risiken, Roadmap und BOM-Hinweise (5V-Boost + Pegelwandler für WS2812)
    entsprechend aktualisiert.
2026-10-08 Ladeelektronik über USB-C-Flashport statt zweitem Stecker
    TP4056/MCP73831-Lade-IC hängt am VBUS des bereits vorhandenen nativen
    USB-C-Ports (Flash/Debug) statt an einem zusätzlichen Lade-Port -
    spart einen Stecker im Waffengehäuse, da die CC-Pulldowns dort schon
    für den USB-Device-Betrieb vorhanden sind.
2026-10-08 Füge KiCad-Schaltplan für die Waffen-Elektronik hinzu
    Programmatisch erzeugter Schaltplan (Python/kiutils, über kicad-cli sch erc
    mit 0 Fehlern verifiziert) für den einzelnen ESP32-S3: Power-Tree (Akku ->
    5V-Boost -> AMS1117-3.3, Lader isoliert am nativen USB-VBUS), IR-Treiber,
    Abzug/Nachladen, Vibrationsmotoren, WS2812 über Pegelwandler, MAX98357A-Audio
    und das Sensorkabel samt TSOPs auf der Weste. Ergänzt außerdem die seit
    Phase-0/1 nachgezogene Stückliste (Pegelwandler, Boost-Converter, Lade-IC)
    in roadmap.md und verlinkt den Schaltplan aus pinbelegung.md.
    [waffe_elektronik.kicad_sch]
2026-10-11 Aktualisiere Doku: Platinenhinweise, Pinbelegung und Roadmap-Feinschliff
2026-10-11 Entferne Android-App/Server-Basis (open-laser-tag), ergänze Gehäuse-Preview
2026-10-11 Verdrahte lokale Signalnetze im Schaltplan mit echten Leitungen statt nur Labels
    [waffe_elektronik.kicad_sch]
2026-10-11 Verdrahte alle Signalnetze echt (inkl. MCU-Läufe) statt nur lokaler Cluster
    [waffe_elektronik.kicad_sch]
2026-10-11 Zeichne Schaltplan neu: Funktionsblöcke, saubere Verdrahtung, A3
    Blöcke gerahmt, Versorgung oben/Masse unten, Signale zwischen Blöcken über
    Labels an kurzen Stichleitungen. Unbenutzte 74AHCT125-Gatter auf GND,
    GPIO1/2 als No-Connect. Vorschaubild in der README.
    [waffe_elektronik.kicad_sch]
2026-10-11 ESP32-S3-WROOM-1 direkt auf der Platine, eigene USB-C-Buchse mit Auto-Flash
    USB-C am nativen USB (IO19/IO20) mit CC-Widerständen und USBLC6-ESD-Schutz,
    EN-RC-Glied, RESET- und BOOT-Taster. Flashen über USB-Serial-JTAG ohne
    Wandlerchip. Doku und Stückliste angepasst.
    [waffe_elektronik.kicad_sch]
2026-10-11 Platine: 4 Lagen, nur SMD, von Hand geroutet; GPIOs layoutgetrieben neu zugeordnet
    [waffe_elektronik.kicad_pcb, waffe_elektronik.kicad_sch]
2026-10-11 Platine: Leiterbahnen nur 0/45/90 Grad, Knicke max. 45 Grad, Teardrops an Pads und Vias
    [waffe_elektronik.kicad_pcb]
2026-10-11 Generator-Skripte für Schaltplan und Platine
2026-10-11 Projekt-Skill kicad-pcb: Routing-Regeln, Ablauf und Prüfwerkzeuge
2026-10-11 JLCPCB-Bestellpaket: LCSC-Teile im Schaltplan, Gerber/BOM/CPL, Skill jlcpcb-order
    [waffe_elektronik-B_Cu.gbl, waffe_elektronik-B_Mask.gbs, waffe_elektronik-B_Paste.gbp, waffe_elektronik-B_Silkscreen.gbo, waffe_elektronik-Edge_Cuts.gm1, waffe_elektronik-F_Cu.gtl, waffe_elektronik-F_Mask.gts, waffe_elektronik-F_Paste.gtp]
2026-10-11 Firmware Waffe in ESP-IDF v6.0: IR, Spiellogik, Feedback, WLAN/UDP
    - IR-Schuss als NEC-Frame (Team/Spieler) 2x über RMT mit 38-kHz-Träger
    - TSOP 1-4 über RMT-RX, TSOP 5/6 über GPIO-Interrupts, gemeinsamer Decoder
    - Trefferregeln: 2 Frames in 100 ms, eigene ID/Team ignorieren, 500 ms unverwundbar
    - WS2812-Anzeige, Vibration (LEDC), synthetische Sounds (I2S), Akku/Ladestatus
    - WLAN ohne Power-Save, eigenes Roaming, UDP mit HMAC, ACK/Resend, RTT
    - Host-Test für den NEC-Codec, Python-Testserver für das Protokoll
    Claude-Session: https://claude.ai/code/session_0134WxVLzPq3f2kTkXj83sHP
    [partitions.csv]
2026-10-11 Ringlicht als Mündungsfeuer am Ende der WS2812-Kette
    - WS2812-Ring vorne an der MP5 über denselben LED-Stecker (Daisy-Chain)
    - Warmer, flackernder Blitz ~120 ms bei jedem Schuss, sofort gerendert
    - Eigene Helligkeitsgrenze wegen Stromspitze am 5-V-Boost
    - Treffer-Blitz lässt den Ring aus
    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
2026-10-11 IR-Empfang: RMT-Callback-Kontext im internen RAM
    Die Sensornummer wurde als Zeigerwert übergeben; mit RMT_ISR_IRAM_SAFE
    prüft der Treiber den Kontext und lehnte TSOP2-4 ab. Jetzt Zeiger auf
    ein statisches Array. Auf dem ESP32-S3 geflasht, startet fehlerfrei.
    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
2026-10-11 Spielserver in Python: UDP, Runden, Punkte, Web-Anzeige
    - asyncio-UDP mit HMAC-Prüfung, Deduplizierung, ACK für HIT/DEATH
    - Teams, Punkte, Runden mit Zeitlimit, Respawn-Freigabe durch den Server
    - Abgleich Waffenstatus/Serverstand mit Wiederholung von Start/Stopp/Respawn
    - Live-Anzeige und Bedienung über WebSocket (nur Standardbibliothek)
    - RTT pro Access Point, Event- und RTT-Logs
    - Waffen-Simulator und Unit-Tests
    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
2026-10-11 README: Projektbeschreibung mit Bildern, Inhaltsverzeichnis und Überblick
    - Einleitung, Badges, Funktionen, Mermaid-Systemdiagramm
    - Platine, Schaltplan, Gehäuse (mit Quellenangabe) und Server-Screenshot
    - Schnellstart, Projektstruktur, Stand; Planung bleibt vollständig erhalten
    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
2026-10-11 ESP-NOW: Fallback über Gateway und Trefferbestätigung Waffe zu Waffe
    - Waffe: ohne WLAN nach 5 s Fallback auf festen Kanal, Pakete per ESP-NOW
    zum Gateway, WLAN-Wiederversuch alle 20 s
    - Getroffene Waffe bestätigt dem Schützen den Treffer (Ton, grüner Blitz)
    - Gateway-Firmware (ESP32-C3/S3): ESP-NOW <-> USB-Seriell, Zeilenprotokoll
    - Server: --gateway, Antwort auf dem Weg des letzten Pakets, ESP-NOW-Markierung
    - Server-Fix: ACK auch für das erste HIT einer neuen Waffe
    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
    [audio.c, audio.h, espnow.c, espnow.h, events.h, game.c, game.h]
2026-10-11 ESP-NOW auf Hardware getestet: Gateway-Reset beim Öffnen, HELLO erneut
    - Server setzt das Gateway beim Öffnen des Ports gezielt zurück (DTR aus,
    RTS-Puls); sonst landete der ESP32 per DTR/RTS im Bootloader
    - Waffe schickt HELLO erneut, sobald sie das Gateway wieder hört
    - Doku: Fallback Waffe <-> Gateway <-> Server mit zwei ESP32-S3 getestet,
    RTT ~22 ms
    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
    [net.c]
2026-10-12 Platine: kürzere Leiterbahnen, Beschriftung auf der Vorderseite
    - B.Cu: L-förmige Bahnen durch 45°-Abschnitte ersetzt (EN/Abzug/Nachladen/IR/WS2812
    als paralleles Bündel, BOOT, Rückstoß, 3V3-Sensor), VBUS-Ring mit 45°-Ecken
    - Steckerbeschriftung auf F.SilkS neben dem jeweiligen Stecker, frei von Pads
    und Bauteilkörpern; Pin 1 von J2 markiert; Projekt-URL auf B.SilkS
    - Skill kicad-pcb: Regeln "so kurz wie möglich" und "Beschriftung vorne",
    Prüfwerkzeuge tools/detour.py und tools/silk.py
    - Fertigungsdaten JLCPCB neu erzeugt, BOM-Kommentare stabil sortiert
    [waffe_elektronik-B_Cu.gbl, waffe_elektronik-B_Mask.gbs, waffe_elektronik-B_Paste.gbp, waffe_elektronik-B_Silkscreen.gbo, waffe_elektronik-Edge_Cuts.gm1, waffe_elektronik-F_Cu.gtl, waffe_elektronik-F_Mask.gts, waffe_elektronik-F_Paste.gtp]
2026-10-12 Platine: kürzeste Leiterbahnen, USB-Paar längenangepasst, Labels ausgerichtet, 3D-Modelle
    - Leiterbahnen auf F.Cu und In2 verkürzt (CHRG_STAT, ADC_BATT, BAT_P, 3V3, 5V-Äste u. a.)
    - USB D+ mit Mäander, D+/D- je Abschnitt gleich lang
    - Labels waagerecht, Steckerspalten auf gemeinsamer Mittelachse, untere Stecker mittig;
    keine Vias unter Labels, Stitching hält Textflächen frei
    - Eigene 3D-Modelle für JST-PH-SM4 (BT1, SP1, J1), erzeugt mit FreeCAD
    - Skill kicad-pcb: Regeln und Werkzeuge pairlen.py, silk.py --column/--row, detour.py
    - Renders und JLCPCB-Fertigungsdaten neu erzeugt
    [JST_PH_S2B-PH-SM4-TB_1x02-1MP_P2.00mm_Horizontal.step, JST_PH_S3B-PH-SM4-TB_1x03-1MP_P2.00mm_Horizontal.step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]
2026-10-12 Platine: Befestigung, OLED/Drehgeber, TSOP 6 an der Waffe, ein Vibrationsmotor
    - 2 x M2-Befestigungslöcher (ISO 7380), kupferfrei auf allen Lagen
    - OLED (I2C, Qwiic, J4) und Drehdrück-Geber (J5) an JST-SH 4 im neuen Streifen
    oben rechts, Platine L-förmig 59,6 x 46 mm
    - Zweite TSAL6100 entfällt, an ihrem Platz J6 (JST-SH 3) für TSOP 6 an der Waffe (GPIO16),
    Filter am Sensor
    - Nur noch ein Vibrationsmotor (GPIO47), GPIO48 frei; I2S-Leitungen kürzer
    - Firmware: Pins für OLED/Geber, TSOP 6 auf GPIO16, ein Motor mit Prioritäten
    - Schaltplan, Fertigungsdaten, Renders, Doku und Skills aktualisiert
    [waffe_elektronik-B_Cu.gbl, waffe_elektronik-B_Mask.gbs, waffe_elektronik-B_Paste.gbp, waffe_elektronik-B_Silkscreen.gbo, waffe_elektronik-Edge_Cuts.gm1, waffe_elektronik-F_Cu.gtl, waffe_elektronik-F_Mask.gts, waffe_elektronik-F_Paste.gtp]
2026-10-12 Platine: USB-C senkrecht (HRO TYPE-C-31-E-17), Stecker durch die Seitenwand
    - J3 jetzt senkrechte, wasserdichte USB-C-Buchse (LCSC C7424785), eigener Footprint in
    footprints/lasertag.pretty (fp-lib-table), 3D-Modell per gen_3d_usb_c_vertical.py
    - USB-Paar neu geroutet: D+ über Via in der Buchsenmitte, D- über B.Cu-Brücke mit Abgriff
    in der Mitte; beide Steckrichtungen gleich lang (<= 0,007 mm), je 2 Vias
    - CC2-Widerstand R22 unter der Buchse, R23 daneben; VBUS-Ring auf B.Cu
    - Schaltplan, Fertigungsdaten, Renders, Doku und Skill aktualisiert
    [USB_C_Receptacle_HRO_TYPE-C-31-E-17_Vertical.step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]
2026-10-12 Gehäuse: Umbau für die Elektronik, Baugruppe als GLB/3MF
    - umbau.py schneidet alle Einbauten in die MP5-Teile (mp5_umbau/):
    Platinentasche mit Domen und USB-C-Öffnung links, beweglicher Abzug (Stift Ø 3,
    Druckfeder, Mikroschalter D2F), Schalldämpfer mit Innengewinde M24 x 1,5 für die
    Linsenhülse (Linse Ø 20), LED-Sitz und Frontkappe für das 12er-Ringlicht,
    Kabelschacht Mündung -> Platine mit Abzweig ins Magazin, 18650 im Magazin mit
    abnehmbarem Unterteil, OLED angewinkelt im Schaft mit Rahmen, Drehgeber EC11 im Griff,
    Vibrationsmotor über dem Griff; Kimme und Korn bleiben
    - baugruppe.py setzt alle Teile samt Platine an ihren Platz (Passungen über Stegkanäle,
    Profil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
    [abzug.stl, frontkappe.stl, linsenhuelse.stl, magazinboden.stl, mp5_baugruppe.3mf, obj_10_2_handschutz.stl, obj_1_3_links.stl, obj_2_4_schaft_rechts.stl]
2026-10-12 README: Schnitt durch den Schalldämpfer mit Linsenhülse, Linse und IR-LED
2026-10-12 Gehäuse: Lautsprecher, TSOP 6, verschraubte Hälften
    - Lautsprecher Ø 40 im Handschutz (geteilt bei Y = -56): strahlt nach hinten in eine
    Schallkammer mit 2 Reihen Löchern Ø 1,8 in den Rillen, geschlossene Basskammer ca. 42 cm³,
    Kabelschacht oben im Rohr um den Lautsprecher, Teile mit 2 Stiften Ø 2 ausgerichtet
    - TSOP 6 oben links am Handschutz hinter dem Korn: Aufnahme + gedruckter Einsatz für den
    TSOP34838, Kabel in den Schacht
    - Gehäusehälften mit 6 x M3 x 10 und Einschmelzmuttern verschraubt (Köpfe rechts versenkt)
    - OLED-Kabelschacht diagonal
    - Baugruppe, Bilder (Schnitt durch den Handschutz, Ansicht rechts) und Doku aktualisiert
    [mp5_baugruppe.3mf, obj_10_2_handschutz.stl, obj_10_2_handschutz_hinten.stl, obj_10_2_handschutz_vorn.stl, obj_1_3_links.stl, obj_2_4_schaft_rechts.stl, obj_3_6_rechts.stl, obj_4_7_schaft_links.stl]
2026-10-12 Gehäuse: TSOP vor dem Korn, eindeutige Teilenamen
    - TSOP 6 vorn an der Rundung unter dem Korn, über dem Schalldämpfer, Linse nach vorn;
    Einsatz 8,6 mm hoch (0,15 mm Luft zum Steg des Korns), Kabel senkrecht in den Hauptschacht
    - mp5_umbau/ ist ein vollständiger Drucksatz mit eindeutigen Namen (gehaeuse_links,
    handschutz_vorn, magazin_unterteil, steg_hinten_77mm, korn, ...), gleiche Namen als
    Knoten in der Baugruppe; Tabelle mit Herkunft im Originalsatz in der README
    [gehaeuse_links.stl, gehaeuse_rechts.stl, handschutz_hinten.stl, handschutz_vorn.stl, korn.stl, magazin.stl, magazin_unterteil.stl, mp5_baugruppe.3mf]
2026-10-12 Gehäuse: Explosionszeichnung mit Teilenamen (zwei Ansichten) in der README
2026-10-12 Gehäuse: Handschutz vorn mit Schalldämpfer links/rechts geteilt, 5 x M3 mit Einschmelzmuttern
    Handschutz hinten bleibt einteilig. READMEs, Explosionszeichnungen und
    3D-Bilder aktualisiert.
    [handschutz_vorn.stl, handschutz_vorn_links.stl, handschutz_vorn_rechts.stl, mp5_baugruppe.3mf]
2026-10-12 Gehäuse: Handschutz vorn umschließt Zapfen am hinteren Handschutz, Kabelnut an der Teilung
    Handschutz hinten/vorn ohne Kleber: Zapfen mit Kopf am hinteren Teil, je Hälfte
    2 x M3 in Einschmelzmuttern; Lautsprecher und Schallkammer ganz im vorderen Teil.
    Kabelschacht um den Lautsprecher als offene Nut an der Teilungsfläche.
    Steg vorn auf 96 mm gekürzt. READMEs, Explosionszeichnungen und Bilder aktualisiert.
    [handschutz_hinten.stl, handschutz_vorn_links.stl, handschutz_vorn_rechts.stl, mp5_baugruppe.3mf, steg_vorn_100mm.stl, steg_vorn_96mm.stl]
2026-10-13 Gehäuse: GX16-Buchse für die Weste am Schaft, alle Kabelwege geprüft
    GX16-7 Einbaubuchse unten vorn am Schaft (Mutter in Sechskanttasche), Kabelschacht
    durch das Gehäuse zu J2. Zone rechts oben zur VIB-Zone geöffnet (Drehgeberkabel).
    kabelwege.py prüft jede Leitung vom Stecker bis zum Bauteil gegen die Baugruppe.
    READMEs, Schnittbild Weste, Bilder und Explosionszeichnungen aktualisiert.
    [gehaeuse_links.stl, gehaeuse_rechts.stl, mp5_baugruppe.3mf, schaft_links.stl, schaft_rechts.stl]
2026-10-13 Gehäuse: Nachladetaste links über dem Griff, GX16-Buchse 15° nach hinten
    Taster 6 x 6 auf der rechten Hälfte, gedruckte Kappe in der linken Hälfte gefangen,
    Kabel in einer Nut zur Tasche des Abzugsschalters (SW2). Westenschacht über den
    Motorschacht (Ø 6) in die VIB-Zone, die bis unter die Platine reicht.
    kabelwege.py mit SW2, flache Adern unter der Platine. READMEs und Bilder aktualisiert.
    [gehaeuse_links.stl, gehaeuse_rechts.stl, mp5_baugruppe.3mf, nachladetaste.stl, schaft_links.stl, schaft_rechts.stl]
2026-10-13 Platine: Stecker nach Kabelwegen ausgerichtet, USB-C bündig mit der Gehäusewand
    J1/SP1 an die linke Kante (Hauptschacht), SW1/SW2 an die Unterkante (Kanal zum
    Abzugsschalter), J2 rechts unter M1 (Motorschacht), RESET auf den EN-Weg.
    USB-C hanxia HX-TYPE-C 16P 180 LT H10.5 (10,5 mm), neues USB-Routing, Paar gleich lang.
    J1 auf CJT A2001WR-S-3P (Lager). Gehäuse: Zonen, USB-Durchbruch mit Mulde,
    Nachladetaste 5 mm nach hinten. Kabelwege, Fertigungsdaten, Bilder, READMEs neu.
    [USB_C_Receptacle_HRO_TYPE-C-31-E-17_Vertical.step, USB_C_Receptacle_HX_TYPE-C-16P-180-LT-H10.5_Vertical.step, gehaeuse_links.stl, gehaeuse_rechts.stl, mp5_baugruppe.3mf, nachladetaste.stl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]
2026-10-13 Gehäuse: Verstärkung mit Stahlstegen, Zugankern M4 und Zentrierbunden
    Je zwei Zuganker M4 vorn (Zapfenkopf bis Gehäuse) und hinten (Gehäuse bis Schaft),
    gefangene Muttern und Mutternischen; Zwischenring beidseitig zentriert (Bund/Nut).
    Stege als Stahl-Rundstab Ø 10. READMEs, Schnittbild Zuganker, Bilder neu.
    [gehaeuse_links.stl, gehaeuse_rechts.stl, handschutz_hinten.stl, mp5_baugruppe.3mf, schaft_links.stl, schaft_rechts.stl, zwischenring.stl]
2026-10-13 Gehäuse: Sicherungshebel als beweglicher Nachladehebel, Abzug ohne festen Rest
    Hebel dreht um die Kreismarke (Lagerbund, M3 mit Scheibe), Wippe auf einen verdeckten
    Taster 6 x 6 mit Stift und Rückstellfeder; Kabel über der Abzugsfeder zur Schaltertasche.
    Abzugsblatt in voller Dicke aus beiden Hälften gelöst. Bilder und READMEs neu.
    [abzug.stl, gehaeuse_links.stl, gehaeuse_rechts.stl, mp5_baugruppe.3mf, nachladehebel.stl, nachladetaste.stl]
2026-10-13 Fertigung: lose Schalter mit LCSC-Nummer (Nachladetaster C110153, Abzugsschalter C397278)
    [waffe_lose_teile.csv]
2026-10-14 Platine: Flash 128 MB, microSD-Slot, Akkuschutz; Schaltplan auf fünf Seiten
    - SPI-NAND GD5F1GQ5UEYIGR (U14, 128 MB) für Audio-Dateien an IO7/IO15/IO3/IO46
    - microSD-Slot TF-018 (J7, Push-Pull) am selben SPI-Bus, /CS an IO48, DAT1/DAT2 mit Pull-up
    - Akkuschutz DW01A + FS8205A in einer Lasche oben links neben BT1
    - USB versorgt 5V_PERIPH über SS14 (Flashen ohne Akku), STAT über BAT54WS an IO18
    - C7 als IR-Puffer an GND, TSOP-Leitungen über 100 Ω an J2
    - Platine 59,6 × 51 mm, J2 an der rechten Kante, H2 versetzt, Gehäusetasche und Kabelwege angepasst
    - Schaltplan hierarchisch: Übersicht + fünf A3-Seiten, Projekt-Symbolbibliothek, ERC ohne Meldungen
    [WSON-8-1EP_8x6mm_P1.27mm_EP3.4x4.3mm.step, audio_speicher.kicad_sch, bedienung_aktoren.kicad_sch, gehaeuse_links.stl, gehaeuse_rechts.stl, mcu_usb.kicad_sch, microSD_TF-018_PushPull.step, mp5_baugruppe.3mf]
2026-10-14 README: Akkuschutz, USB-Betrieb, Sensorkabel-Schutz, Stand von Schaltplan und Gehäuse
2026-10-14 Fertigung: Mouser-BOM für 10 Waffen (Platine + lose Teile, Mouser-Vorlage) und LCSC-Ergänzung
    [lcsc_ergaenzung_10_waffen.csv, mouser_bom_10_waffen.csv, mouser_bom_10_waffen.xlsx, mouser_bom_10_waffen_template.xls]
2026-10-14 Platine: günstigere JLC-Teile, Option ESP32-S3-WROOM-1U mit externer Antenne
    - Flash ZD35Q1GC-IB, Kondensatoren/Dioden/Widerstände auf Basic-Teile und 0402, Layout angepasst
    - WROOM-1U auf demselben Footprint: eigene JLCPCB-BOM/CPL (Modulmitte 3,15 mm versetzt),
    Mouser-Option mit Pigtail RP-SMA/U.FL und Knick-Stabantenne, 3D-Modell des 1U
    - Gerber, BOM, CPL, Renders und Bestelllisten neu erzeugt
    Claude-Session: https://claude.ai/code/session_01KkZzubjLKyW9odUwvmxTog
    [ESP32-S3-WROOM-1U.step, audio_speicher.kicad_sch, bedienung_aktoren.kicad_sch, mcu_usb.kicad_sch, mouser_bom_10_waffen.csv, mouser_bom_10_waffen.xlsx, mouser_bom_10_waffen_template.xls, option_externe_antenne_10_waffen.csv]
2026-10-14 Gehäuse: externe Antenne links oben über dem ESP32-Modul
    - RP-SMA-Buchse quer durch die linke Seitenwand, Planfläche außen, Raum für Sechskant und
    Pigtail-Schlaufe innen; Knick-Stabantenne senkrecht nach oben neben Kimme und Korn
    - Buchse, Antenne und Pigtail in Baugruppe, Explosion und Kabelwegprüfung; Platine als WROOM-1U
    - Renders: Antenne links, schräg außen, innen; Explosionszeichnungen neu
    - umbau.py wertet die Schnitte schrittweise aus (tiefer CSG-Baum stürzte in manifold3d ab)
    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
    [gehaeuse_links.stl, gehaeuse_rechts.stl, mp5_baugruppe.3mf]
2026-10-14 Fertigung: JLCPCB-BOM/CPL mit allen Steckern und Tastern (Variante komplett)
    - Handlötteile tragen im Schaltplan das Feld "LCSC Hand" statt "LCSC", build_board.py übernimmt es
    - jlc_fab.py schreibt zusätzlich *_komplett und *_komplett_externe_antenne (79 Teile, 20 Extended),
    --check prüft den Bedarf der Komplett-Variante; Rotationskorrektur 180° für JST-SH (ungeprüft)
    - Schaltplan und Platine neu erzeugt (Geometrie unverändert), Gerber neu, Doku angepasst
    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
    [audio_speicher.kicad_sch, bedienung_aktoren.kicad_sch, mcu_usb.kicad_sch, sensoren.kicad_sch, stromversorgung.kicad_sch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]
2026-10-15 Platine: microSD-Slot gedreht, Ein/Aus über den Drehgeber-Taster, R7 12 Ω, 10 µF am Slot
    - J7: Karte wird auf der Kontaktseite eingesteckt (Datenblatt TF-018) -> Slot gedreht, Kontakte und
    Öffnung an der Unterkante, SD-Leitungen neu verlegt
    - Soft-Power: Q4 (AO3401A) trennt den Akku von BAT_SW, Taster an J5.2 schaltet über D6 (BAT54CW) ein,
    IO21 hält über Q5, IO9 liest den Taster; Lasche oben links 18,6 x 9 mm mit den neuen Teilen,
    Leitungen auf B.Cu über die Oberkante, Akku-Plus über In2
    - R7 12 Ω (C17913), C28 10 µF an der microSD-Versorgung
    - Gerber, BOM/CPL (alle Varianten), Mouser-BOM, Renders und Doku neu
    Claude-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
    [audio_speicher.kicad_sch, bedienung_aktoren.kicad_sch, mcu_usb.kicad_sch, mouser_bom_10_waffen.csv, mouser_bom_10_waffen.xlsx, mouser_bom_10_waffen_template.xls, sensoren.kicad_sch, stromversorgung.kicad_sch]
2026-10-15 Gehäuse: Platinentasche für die höhere Lasche (Ein/Aus)
    - Tasche folgt der neuen Kontur (Lasche 18,6 x 9 mm), rechte Wand dort mindestens 2,5 mm
    - Baugruppe, Explosionszeichnungen und Antennen-Innenansicht mit der neuen Platine
    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
    [gehaeuse_links.stl, gehaeuse_rechts.stl, mp5_baugruppe.3mf]
2026-10-15 Gehäuse: Baugruppe-Renders mit aktueller Platine und externer Antenne
    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
2026-10-15 Platine: IP5306 (2 A Laden + 5 V) statt MT3608/MCP73831, Ein/Aus über KEY, eigener I²C-Bus
    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
    [audio_speicher.kicad_sch, bedienung_aktoren.kicad_sch, lcsc_ergaenzung_10_waffen.csv, mcu_usb.kicad_sch, mouser_bom_10_waffen.csv, mouser_bom_10_waffen.xlsx, mouser_bom_10_waffen_template.xls, sensoren.kicad_sch]
2026-10-15 Platine: Stecker zusammengelegt, Basic-Teile, MOSFET-Pegelwandler, Flash optional, Kabel-3V3 über 10 Ω, breitere 5-V- und Akku-Wege
    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
    [audio_speicher.kicad_sch, bedienung_aktoren.kicad_sch, mcu_usb.kicad_sch, mouser_bom_10_waffen.csv, mouser_bom_10_waffen.xlsx, mouser_bom_10_waffen_template.xls, sensoren.kicad_sch, stromversorgung.kicad_sch]
2026-10-15 Platine: Lastschalter TPS22810 hinter dem IP5306 (EN = IRQ), RESET in die Lasche, Dämpfung an der USB-Buchse
    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
    [audio_speicher.kicad_sch, bedienung_aktoren.kicad_sch, mcu_usb.kicad_sch, mouser_bom_10_waffen.csv, mouser_bom_10_waffen.xlsx, mouser_bom_10_waffen_template.xls, sensoren.kicad_sch, stromversorgung.kicad_sch]
2026-10-15 Platine: Herstellerzeichen mit Borg-Würfel unter U2, Schaltplan: Westen-TSOP-Ausgänge auf Steckerseite
    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
    [audio_speicher.kicad_sch, bedienung_aktoren.kicad_sch, mcu_usb.kicad_sch, sensoren.kicad_sch, stromversorgung.kicad_sch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]
2026-10-15 Platine: nur Logo + URL unter U2, weißer Lötstopplack mit schwarzem Druck (Stackup, Renders)
    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
    [waffe_elektronik-B_Cu.gbl, waffe_elektronik-B_Mask.gbs, waffe_elektronik-B_Paste.gbp, waffe_elektronik-B_Silkscreen.gbo, waffe_elektronik-Edge_Cuts.gm1, waffe_elektronik-F_Cu.gtl, waffe_elektronik-F_Mask.gts, waffe_elektronik-F_Paste.gtp]
2026-10-15 Platine: Herstellertexte in Orbitron / Share Tech Mono als Silk-Polygone (Schriften in fonts/)
    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
    [waffe_elektronik-B_Cu.gbl, waffe_elektronik-B_Mask.gbs, waffe_elektronik-B_Paste.gbp, waffe_elektronik-B_Silkscreen.gbo, waffe_elektronik-Edge_Cuts.gm1, waffe_elektronik-F_Cu.gtl, waffe_elektronik-F_Mask.gts, waffe_elektronik-F_Paste.gtp]
2026-10-15 JLC: Tantal-Rotation 0° statt 180° (C3-Polung laut JLC-Vorschau), CPL neu
    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
    [waffe_elektronik_cpl.csv, waffe_elektronik_cpl_externe_antenne.csv, waffe_elektronik_cpl_externe_antenne_flash.csv, waffe_elektronik_cpl_flash.csv, waffe_elektronik_cpl_komplett.csv, waffe_elektronik_cpl_komplett_externe_antenne.csv, waffe_elektronik_cpl_komplett_externe_antenne_flash.csv, waffe_elektronik_cpl_komplett_flash.csv]
2026-10-15 Platine: Vias 0,2/0,45 statt 0,2/0,4 (kein Kelvin-Test bei JLC), Baugruppe mit aktueller Platine, Kabelenden in der Kabelweg-Prüfung ausgenommen
    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
    [mp5_baugruppe.3mf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]
2026-10-16 Lizenz: CC BY-NC-SA 4.0 (keine kommerzielle Nutzung ohne Einwilligung), Teile Dritter in der Readme
2026-10-18 Gehäuse: Gießfüllung als eigene Variante (Modifier-STLs, Konzept, Vorschaubilder)
    - mp5_umbau/GIESSFUELLUNG.md: Konzept Schale drucken + Quarzharz/PU-Schaum ausgießen, Druckprofil 0,4er Düse
    - scripts/giessfuellung.py: Gießkammern je Teil (2 mm Wand, offen zur Bettseite, Überhänge bis 45°),
    Zonen Quarzharz/Schaum/hohl (Antenne), Volumen und Vorschaubilder
    - mp5_giessfuellung/: Modifier-STLs, volumen.json, Bilder, Slicer-Anleitung; Teile in mp5_umbau bleiben
    unverändert (Prototyp ohne Füllung)
    [gehaeuse_links__hohl.stl, gehaeuse_links__quarzharz.stl, gehaeuse_rechts__hohl.stl, gehaeuse_rechts__quarzharz.stl, handschutz_hinten__schaum.stl, handschutz_vorn_links__schaum.stl, handschutz_vorn_rechts__schaum.stl, schaft_links__quarzharz.stl]
2026-10-18 Gehäuse: Bambu-Studio-Projekte für P2S (massiv und Gießvariante) mit geslicten Druckzeiten
    - scripts/bambu_projekte.py: baut beide Projekte über die Kommandozeile von Bambu Studio (Teile + Modifier,
    aufgelöste Systemprofile, Platten ausgelegt), slict zur Kontrolle, schreibt bambu/druckzeiten.json
    - bambu/: mp5_massiv_p2s.3mf (41,2 h, 933 g), mp5_guss_p2s.3mf (21,3 h, 503 g; Grid 15 %, 3 Bodenschichten)
    - Druckzeiten in GIESSFUELLUNG.md und der Gieß-README nach dem Slicen
    Claude-Session: https://claude.ai/code/session_017wUBxxsBGHR7hG5qNwnZ2e
    [mp5_guss_p2s.3mf, mp5_massiv_p2s.3mf]
2026-10-18 Gießfüllung: fertige STLs mit ausgesparten Kammern statt Modifier
    Kammerdecken höchstens 10 mm freie Brücke, Antennenbereich ohne Kammer,
    geglättete Kammerflächen. Bambu-Projekte mit Support-Blocker über den Kammern
    und Ensure vertical shell thickness = Partial neu gebaut (Guss 24,8 h / 560 g).
    Dokumentation angepasst.
    [gehaeuse_links.stl, gehaeuse_links__hohl.stl, gehaeuse_links__quarzharz.stl, gehaeuse_rechts.stl, gehaeuse_rechts__hohl.stl, gehaeuse_rechts__quarzharz.stl, handschutz_hinten.stl, handschutz_hinten__schaum.stl]
2026-10-20 Gießfüllung: OrcaSlicer-Projekt für Anycubic i3 Mega S (PETG)
    Gegenstück zu mp5_guss_p2s.3mf für das 210er Bett: Schafthälften auf eigenen
    Platten, vorderer Handschutz 45° gedreht, Gehäusehälften 4,5 mm nach hinten
    (Support sonst auf der Reinigungslinie), kein Brim/Skirt. Orca übernimmt
    subtype und print_params aus der Assemble-Liste nicht, fix_parts trägt
    Support-Blocker und Zapfen-Modifier nachträglich ein. 79,3 h, 655 g.
    [mp5_guss_i3megas.3mf]
2026-10-20 Orca-Projekt: geänderte Einstellungen in different_settings_to_system eintragen
    Die Kommandozeile lässt die Liste leer, die Oberfläche lud dann das
    Mega-S-Systemprofil unverändert (Brim und Skirt über den Bettrand, Crosshatch,
    volle vertikale Schalen). fix_settings trägt die geänderten Prozessschlüssel ein.
    [mp5_guss_i3megas.3mf]
2026-10-21 Gießfüllung: OrcaSlicer-Projekt für Artillery Sidewinder X2 (PETG)
    orca_projekte.py baut jetzt mehrere Drucker (i3megas, x2). Sidewinder X2 mit
    300er Bett auf 3 Platten: Gehäusehälfte und vorderer Handschutz nebeneinander,
    der Rest auf Platte 3. Teile kommen in die erste Reihe mit Platz (sonst blieb
    hinter dem Schaft die Reihe halb leer). Auto-Brim aus (17 mm breit, lief übers
    Bett), 10 mm Rand. 71,1 h, 614 g. druckzeiten.json je Drucker.
    [mp5_guss_x2.3mf]
2026-10-22 Orca X2: PETG-Einstellungen gegen Stringing
    Mit dem Artillery-PETG-Profil (255 °C, 1 mm Retract, kein Wipe, 0,4 mm Z-Hop)
    zog der X2 starke Fäden. Filament-Overrides: 240 °C (erste Schicht 245 °C),
    Retract 1,6 mm mit 40 mm/s, Wiedereinschub 30 mm/s, Wipe 2 mm, Z-Hop 0,2 mm.
    Avoid crossing walls an. Druckzeit 71,1 h -> 78,8 h, 614 g.
    [mp5_guss_x2.3mf]
2026-10-22 Orca X2: schneller drucken (78,8 h -> 63,6 h)
    Das Artillery-Profil druckt mit 500 mm/s² und 30–60 mm/s. Beschleunigung
    1000 mm/s² (Limit im Druckerprofil), Innenwand 80, Infill 100, inneres
    Solid-Infill 80, Oberseite 45, Support 70, Gap-Fill 40, Leerfahrt 200 mm/s.
    Außenwand bleibt 60 mm/s mit 700 mm/s². Avoid crossing walls bleibt an
    (kostet 4 h, hilft gegen Stringing).
    [mp5_guss_x2.3mf]
2026-10-22 Orca X2: Klipper-Startcode, Bett 80 °C, Exclude Object
    Der X2 läuft jetzt mit Klipper. G-Code-Flavor klipper, eigener Startcode
    (G28, BED_MESH_CALIBRATE, Reinigungslinien bei X 5–5,4, Y 20–200), Endcode
    ohne M150/M85/M200. Das M221 S95 des alten Startcodes fällt weg.
    exclude_object an, damit sich einzelne Teile abbrechen lassen.
    Bett lief mit 60 °C statt 80 °C (Profil auf Cool Plate): Cool-Plate-
    Temperatur im Filament auf 80 °C. 63,4 h, 613 g.
    [mp5_guss_x2.3mf]
2026-10-23 Orca i3 Mega S: Reinigungslinie im Startcode unter Klipper-Querschnittslimit
    Das Systemprofil schaltet M83 ein, rechnet die Linie aber absolut (E12.5 auf
    40 mm = 0,75 mm²); Klipper bricht bei 0,64 mm² ab. Jetzt E6 (0,36 mm²).
    [mp5_guss_i3megas.3mf]
